kuropatoochka/bms_stand/bms_app/reports/report_1111_20250519_182336.pdf

ПРОТОКОЛ

Проверки соответствия системы контроля литий-ионной аккумуляторной батареи функциональным требованиям

№ ____ | « » _______ 2025 г.
1. Объект испытания: система контроля литий-ионной аккумуляторной батареи BMS_ABC123 зав. № 1111.
2. Цель испытания:
Проверка соответствия системы контроля литий-ионной аккумуляторной батареи функциональным требованиям
по защите аккумуляторной батареи от перезаряда, переразряда, токов короткого замыкания.
- отключение тока заряда при напряжении 4,25±0,05 В на любом из аккумуляторов;
- отключение тока разряда при напряжении 2,85±0,05 В на любом из аккумуляторов;
- отключение при превышении тока разряда свыше 50 А.
3. Дата проведения испытания: «19» May 2025 г.
4. Место проведения испытания: ООО "Ту-ту".

№ каналаРабота принапряженииниже 4,2 В Отключение принапряжениивыше 4,3 В Работа принапряжениивыше 2,9 В Отключение принапряженииниже 2,8 В

1 | + | - | - | -
2 | - | - | - | -
3 | - | - | - | +
4 | + | + | + | +
5 | - | + | - | +
6 | - | - | + | +
7 | - | - | + | +
8 | - | - | + | -

Отключение разряда по превышению тока 50 А: Результат по КЗ: СКУ ЛИАБ не сработало по короткому замыканию
