kuropatoochka/bms_stand/bms_app/reports/report_BMS_ABS111_20250519_181500.pdf

ПРОТОКОЛ

Проверки соответствия системы контроля литий-ионной аккумуляторной батареи функциональным требованиям

№ ____ | « » _______ 2025 г.
