kuropatoochka/bms_stand/bms_altium/Project Outputs for BMS_Test_Stand/BOM/Copy of Bill of Materials-Stand.xlsx

Comment | Description | Designator | Footprint | LibRef | Quantity
 | Чип-конденсатор | C1, C2, C3, C4, C5, C6, C7 | С0805 | Chip Capasitor | 7
C-Type | Чип конденсатор (3/C) тант. | C8, C9, C10 | C_tant 3(С-type) | К53-67 (3/C) | 3
 | Чип-конденсатор | C11, C12, C13, C14, C15, C16, C17, C18, C19, C20, C21, C22, C23, C24, C25, C26, C27, C44, C45, C46, C47, C48, C49, C50, C51, C52, C53, C54, C55, C56, C57, C58, C59, C60, C61, C62, C63, C64, C65, C66, C67 | C0603 | Chip Capasitor | 41
0.1μF | Чип-конденсатор | C28, C30, C32, C34, C36, C38, C40, C42 | C0603 | Chip Capasitor | 8
1nF | Чип-конденсатор | C29, C31, C33, C35, C37, C39, C41, C43 | C0603 | Chip Capasitor | 8
К1986ВЕ92Q | 32бит микроконтроллер CortexM3 | D1 | LQFP64 | К1986ВЕ92QI(C)_2parts(LQFP64) | 1
PRAB30S | Реле твердотельное с оптической развязкой | DA1, DA2, DA3, DA4 | SOP-4 | PRAB30S | 4
78D12L | Стабилизатор напряжения, 12В | DA5 | DPAK | 78D12L | 1
LD1117DT 3.3V | LDO-регулятор напряжения, 3.3В | DA6 | DPAK | LD1117DT33TR | 1
REF193 3V | Источник опорного напряжения, 3В | DA7 | SOP-8 (SOIC) | REF193 | 1
TS321ILT | 1х Операционный усилитель | DA8, DA9, DA10, DA11, DA12, DA13, DA14, DA15 | SOT-23-5 | TS321ILT | 8
CH340N | Преобразователь интерфейса USB в UART | DD1 | SOP-8 (SOIC) | CH340N | 1
FH-101C | Fuse holder 5x20mm | FU1 | FH-101C | FH-101C | 1
LED | Светодиод, d=5мм | HL1, HL2, HL3, HL4 | LED 5mm (L-7113IT) | LED | 4
LQH43MN331K | Чип-индуктивность 95мА, 330мкГн 10% | L1 | LQH43M (1812) | LQH43MN331K | 1
 | Чип-резистор | R1, R2, R5, R6, R10, R11, R19, R20, R28, R29, R30, R31, R32, R33, R34, R35, R36, R37, R38, R39, R40, R41, R42, R48, R49, R50, R51, R52, R53, R54, R55, R56, R57, R58, R59, R60, R61, R62, R63, R64, R70, R71, R72, R73, R74, R75, R76, R77, R78, R79, R80, R81, R82, R83, R84, R85, R86, R92, R93, R94, R95, R96, R97, R98, R99, R100, R101, R102, R103, R104, R105, R106, R107, R108, R114, R115, R116, R117, R118, R119, R120, R121, R122, R123, R124, R125, R126, R127, R128, R129, R130, R136, R137, R138, R139, R140, R141, R142, R143, R144, R145, R146, R147, R148, R149, R150, R151, R152, R158, R159, R160, R161, R162, R163, R164, R165, R166, R167, R168, R169, R170, R171, R172, R173, R174, R180, R181, R182, R183, R184, R185, R186, R187, R188, R189, R190, R191, R192, R193, R194, R195, R196, R202, R203 | R0603 | Chip Resistor | 144
 | Чип-резистор | R3, R4 | R1206 | Chip Resistor | 2
6,8К | Чип-резистор | R7 | R1206 | Chip Resistor | 1
100 | Чип-резистор | R8, R44, R66, R88, R110, R132, R154, R176, R198 | R0603 | Chip Resistor | 9
68 | Резистор | R9 | SQP 5W | Resistor | 1
 | Чип-резистор | R12, R13, R14, R15, R16, R17, R18, R21, R22, R23, R24, R25, R26, R27 | R0805 | Chip Resistor | 14
1k | Чип-резистор | R43, R45, R46, R47, R65, R67, R68, R69, R87, R89, R90, R91, R109, R111, R112, R113, R131, R133, R134, R135, R153, R155, R156, R157, R175, R177, R178, R179, R197, R199, R200, R201 | R0603 | Chip Resistor | 32
0650HIM-130G-G | Кнопка тактовая, h=5мм | SF1, SF2 | TC-0103 | 0650HIM-130G-G | 2
PRTR5V0U2X | Защитная диодная сборка от статического заряда | VD1 | SOT-143 | PRTR5V0U2X | 1
S1B | Диод выпрямительный, 100В | VD2, VD5, VD8, VD11, VD14, VD17, VD20, VD23 | DO-214AC | S1B | 8
TLV431B | Стабилитрон регулируемый, 6В | VD3, VD6, VD9, VD12, VD15, VD18, VD21, VD24 | SOT-23 | TLV431B | 8
SMCJ5.0A | Защитный диод, 5В | VD4, VD7, VD10, VD13, VD16, VD19, VD22, VD25 | DO-214AB | SMCJ5.0A | 8
BC846B | Транзистор биполярный NPN, 65В | VT1, VT3, VT4, VT5, VT15, VT16, VT17, VT27, VT28, VT29, VT39, VT40, VT41, VT51, VT52, VT53, VT63, VT64, VT65, VT75, VT76, VT77, VT87, VT88, VT89 | SOT-23 | BC846B | 25
IRFP4710PBF | Транзистор MOSFET N-канал, 100В | VT2 | TO-247AC | IRFP4710PBF | 1
BC856 | Транзистор биполярный PNP, 65В | VT6, VT7, VT8, VT13, VT18, VT19, VT20, VT25, VT30, VT31, VT32, VT37, VT42, VT43, VT44, VT49, VT54, VT55, VT56, VT61, VT66, VT67, VT68, VT73, VT78, VT79, VT80, VT85, VT90, VT91, VT92, VT97 | SOT-23 | BC856 | 32
AO3404A | Транзистор MOSFET N-канал, 30В | VT9, VT10, VT11, VT21, VT22, VT23, VT33, VT34, VT35, VT45, VT46, VT47, VT57, VT58, VT59, VT69, VT70, VT71, VT81, VT82, VT83, VT93, VT94, VT95 | SOT-23 | AO3404A | 24
2N7002 | Транзистор MOSFET N-канал, 60В | VT12, VT24, VT36, VT48, VT60, VT72, VT84, VT96 | SOT-23 | 2N7002 | 8
KT814Г | Транзистор биполярный PNP, 100В | VT14, VT26, VT38, VT50, VT62, VT74, VT86, VT98 | TO-126 | KT814Г | 8
Mini-Fit | Mini-Fit 4,2mm A Male 6 pin | XP1 | MF2x3MA | MF2x3MA | 1
MicroFit | MicroFit 3mm RA Male 4 pin | XP2 | MF3-04MA | 43045-0412 | 1
AC-023 | Разъём питания AC, одинарный | XP3 | IEC-C14 | AC-023 | 1
5EHDRC-03P | Клеммник 3 конт. "вилка" шаг 5.00 мм | XP4 | 5EHDRC-03P | 5EHDRC-03P | 1
5EHDRC-10P | Клеммник 10 конт. "вилка" шаг 5.00 мм | XP5 | 5EHDRC-10P | 5EHDRC-10P | 1
"JTAG" | J-TAG Connector | XP6 | IDC_20 | JTAG_20 L | 1
USB Type B | Гнездо USB тип B | XS1 | USB Type B | USB Type B | 1
QuartzRes | Кварцевый резонатор, 8 МГц | ZQ1 | HC-49SM | QuartzRes | 1
