kuropatoochka/bms_stand/bms_altium/Project Outputs for BMS_Test_Stand/Для СБ Измерительного модуля стенда/Top.DXF

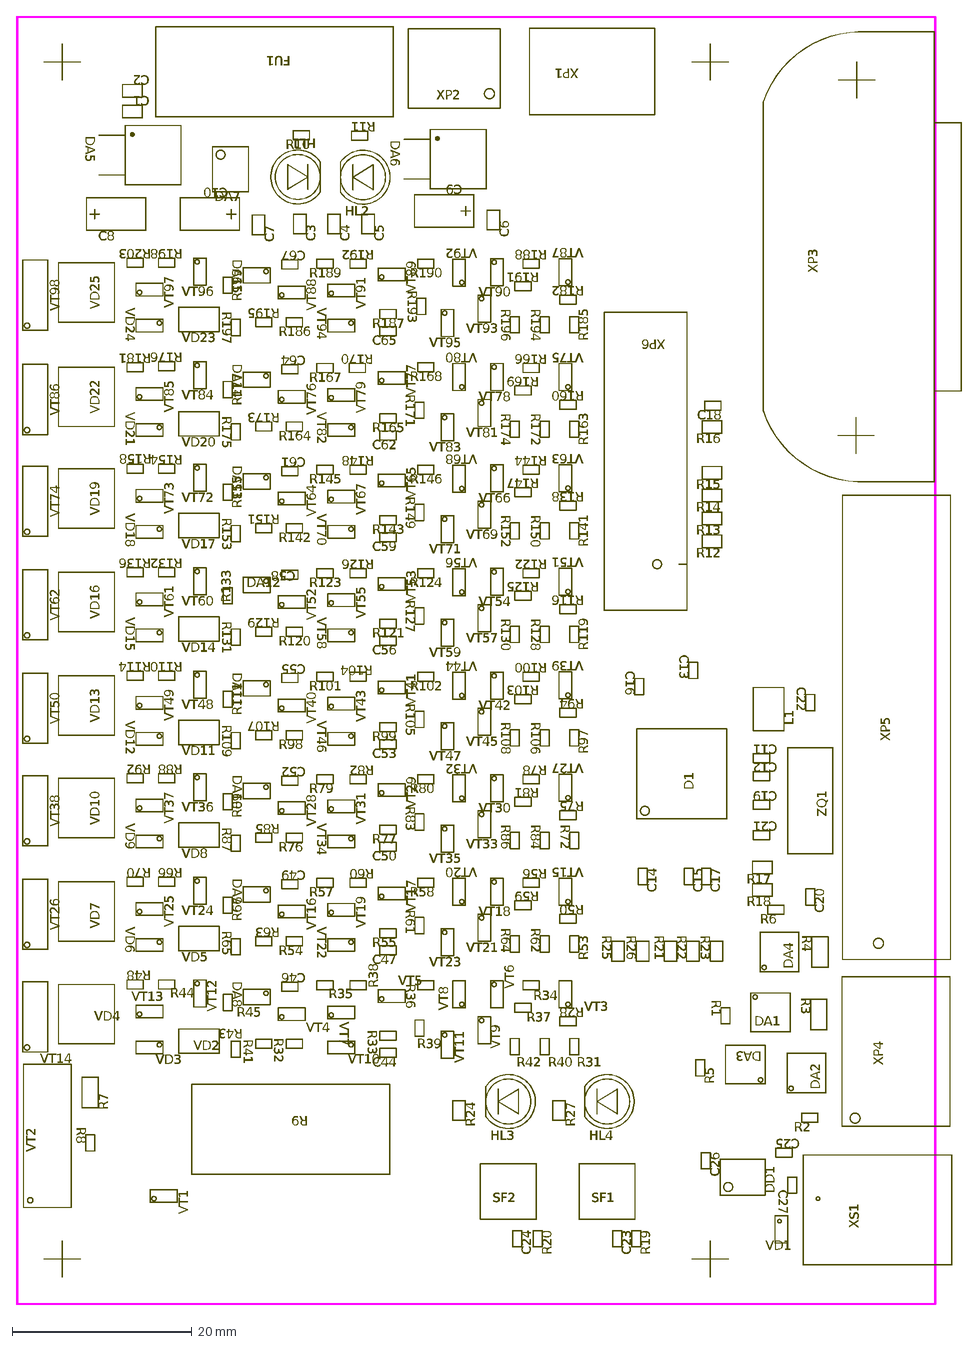
[picture p1: CAD file, 2025-08-11]
bms_altium/Project Outputs for BMS_Test_Stand/Для СБ Измерительного модуля стенда/Top.DXF
XP4
XP5
XP1
XP2
C3
C2
C67
C65
C64
C62
C61
C59
C58
C56
C55
C53
C52
C50
C49
C47
C46
C44
DA15
DA14
DA13
DA12
DA11
DA10
DA9
DA8
R50
C20
ZQ1
XS1
XP6
XP3
VT98
VT97
VT96
VT95
VT94
VT93
VT92
VT91
VT90
VT89
VT88
VT87
VT86
VT85
VT84
VT83
VT82
VT81
VT80
VT79
VT78
VT77
VT76
VT75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
