kuropatoochka/bms_stand/bms_solid/top.SLDPRT

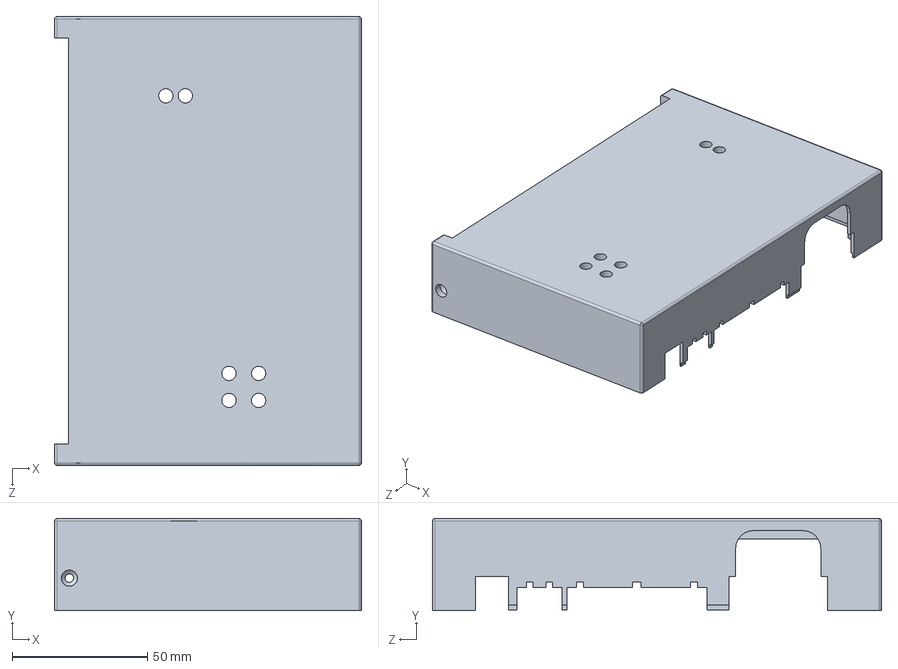
[picture p2: CAD file, 2025-08-11]
bms_solid/top.SLDPRT
113.6 x 34.1 x 166.2 mm
