kuropatoochka/bms_stand/bms_altium/Project Outputs for BMS_Test_Stand/Для СБ Измерительного модуля стенда/Bottom.DXF

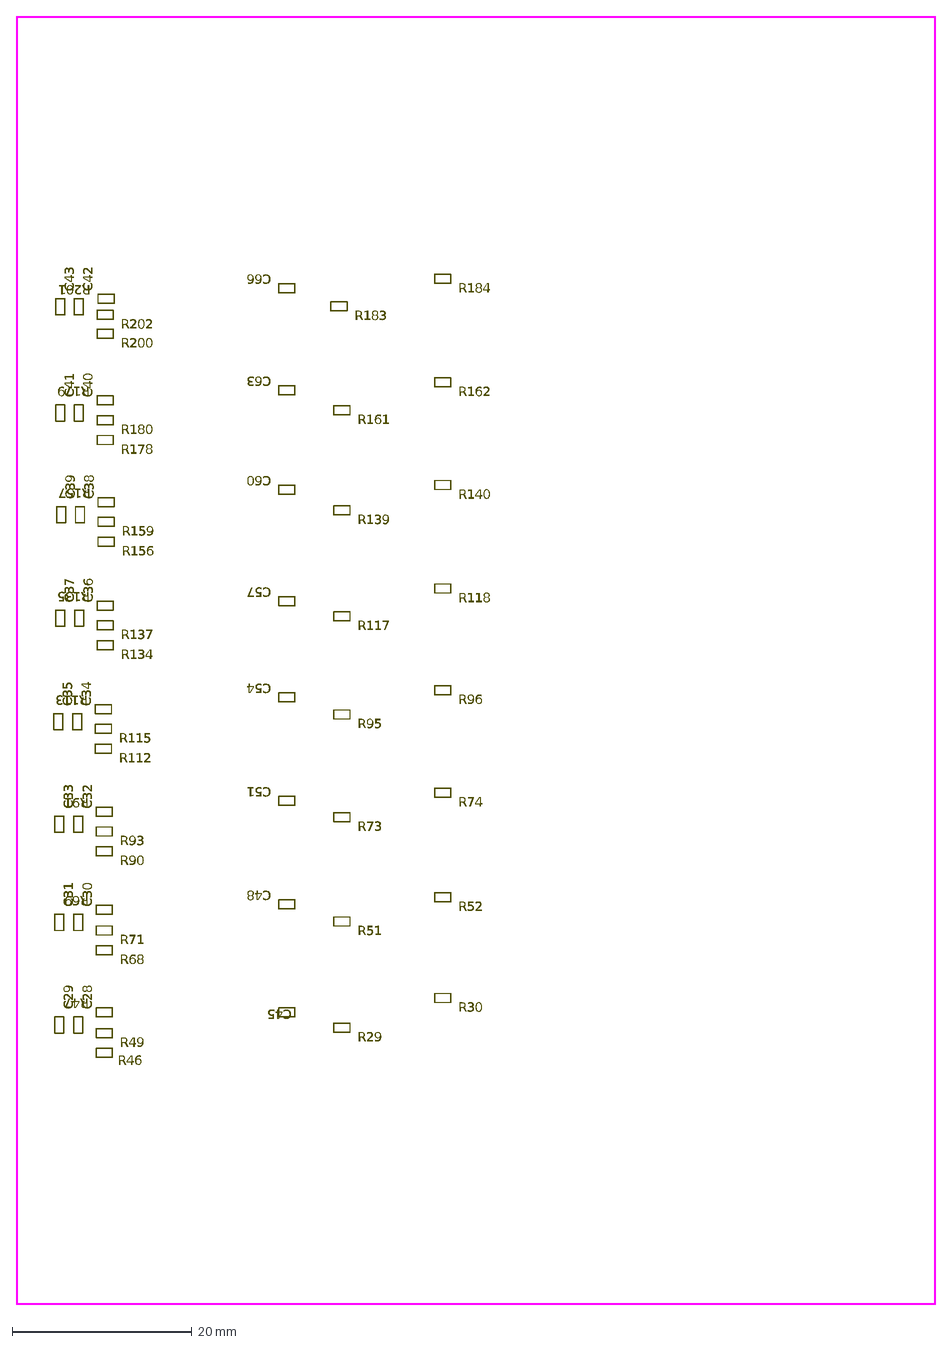
[picture p3: CAD file, 2025-08-11]
bms_altium/Project Outputs for BMS_Test_Stand/Для СБ Измерительного модуля стенда/Bottom.DXF
C66
C63
C60
C57
C54
C51
C48
C45
R200
R68
R202
R201
R184
R183
R180
R179
R178
R162
R161
R159
R157
R156
R140
R139
R137
R135
R134
R118
R117
R115
R113
R112
R96
R95
R93
R91
R90
R74
R73
R71
R69
R52
R51
R49
R47
R46
R30
R29
C43
C42
C41
C40
C39
C38
C37
C36
C35
C34
C33
C32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
