kuropatoochka/bms_stand/bms_solid/колпачек.SLDPRT

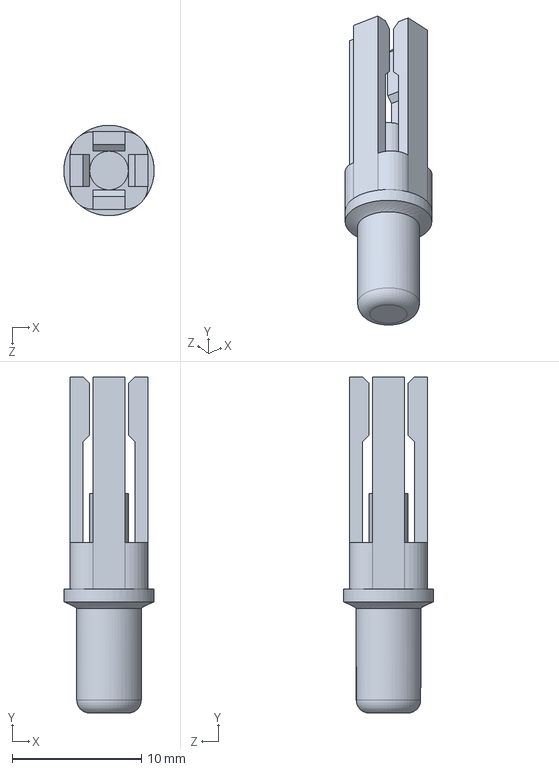
[picture p4: CAD file, 2025-08-11]
bms_solid/колпачек.SLDPRT
7.00 x 26.0 x 7.00 mm
