kuropatoochka/bms_stand/bms_solid/Плоская шайба DIN 125 M3.SLDPRT

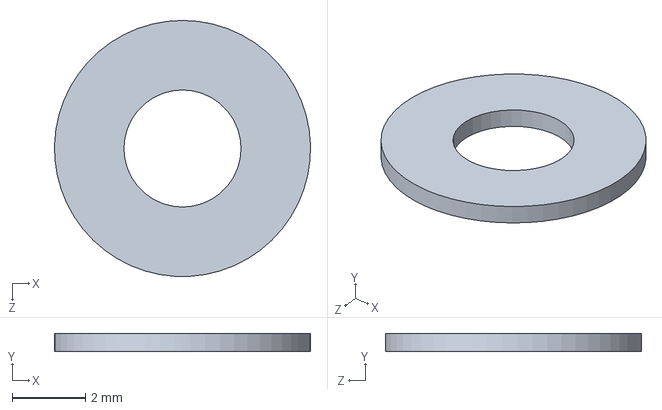
[picture p5: CAD file, 2025-08-11]
bms_solid/Плоская шайба DIN 125 M3.SLDPRT
7.00 x 0.5 x 7.00 mm
