kuropatoochka/bms_stand/bms_solid/A06-17.0.SLDPRT

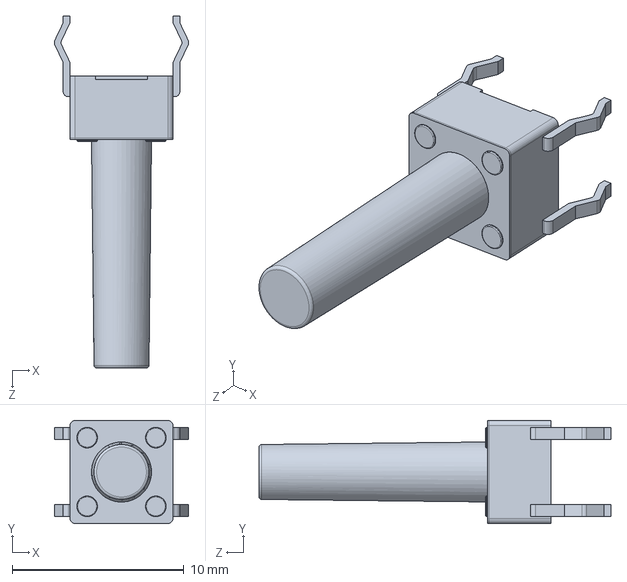
[picture p6: CAD file, 2025-08-11]
bms_solid/A06-17.0.SLDPRT
7.83 x 6.00 x 20.5 mm
