kuropatoochka/bms_stand/bms_solid/body.SLDPRT

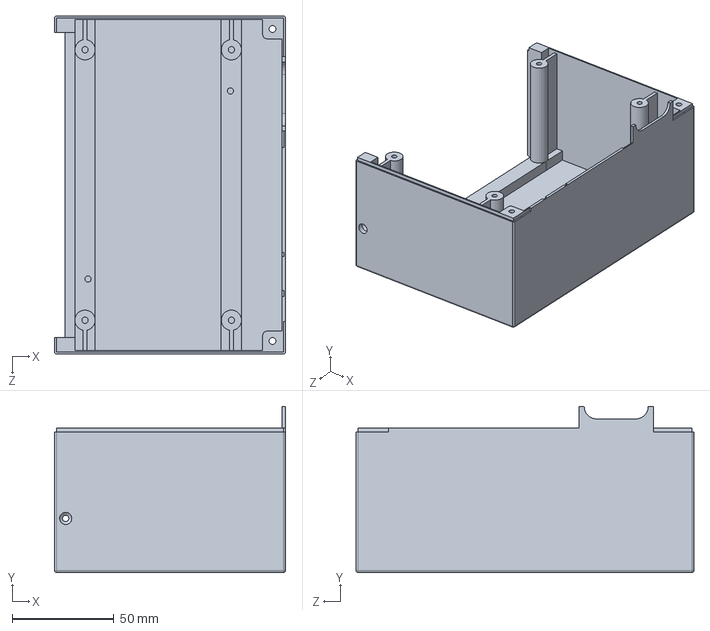
[picture p7: CAD file, 2025-08-11]
bms_solid/body.SLDPRT
113.6 x 81.6 x 166.2 mm
