kuropatoochka/bms_stand/bms_solid/LRS-35,50 Mean Well/Bot LRS-35,50.sldprt

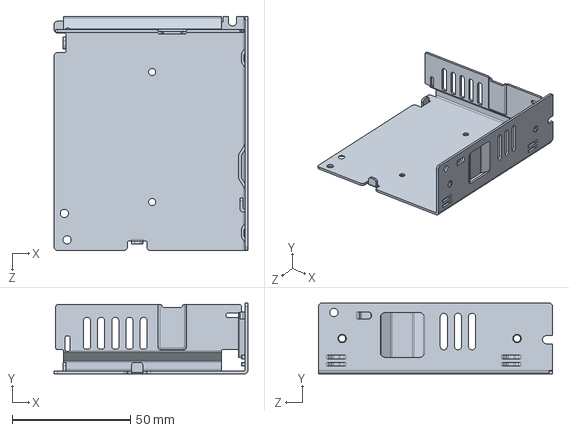
[picture p8: CAD file, 2025-08-11]
bms_solid/LRS-35,50 Mean Well/Bot LRS-35,50.sldprt
82.0 x 30.0 x 99.0 mm
