kuropatoochka/bms_stand/bms_solid/Пружинная шайба DIN 127 М3.SLDPRT

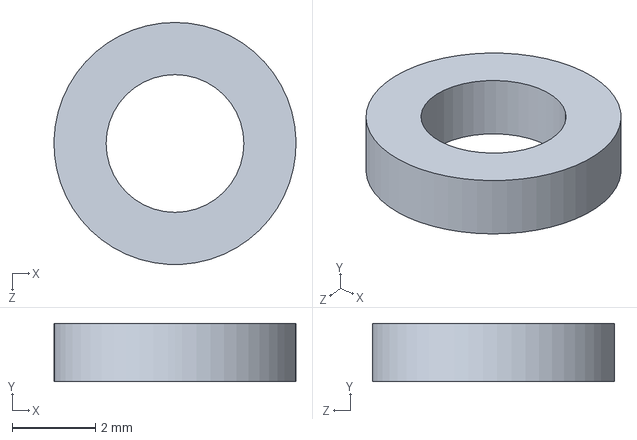
[picture p9: CAD file, 2025-08-11]
bms_solid/Пружинная шайба DIN 127 М3.SLDPRT
5.80 x 1.40 x 5.80 mm
