kuropatoochka/bms_stand/bms_solid/radiator_АВМ-077-100.SLDPRT

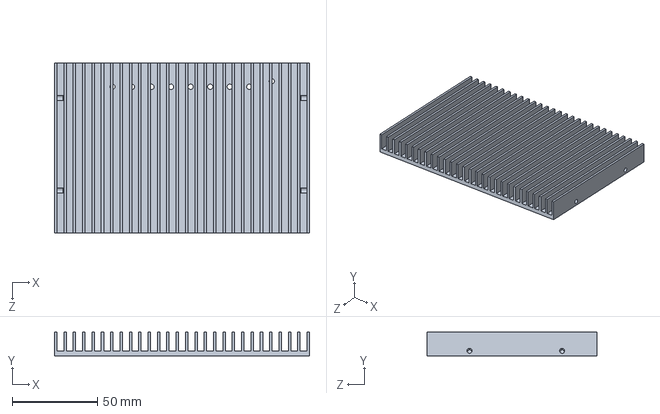
[picture p10: CAD file, 2025-08-11]
bms_solid/radiator_АВМ-077-100.SLDPRT
150.0 x 14.0 x 100.0 mm
