kuropatoochka/bms_stand/bms_solid/LRS-35,50 Mean Well/LRS-35,50 Mean Well.SLDASM

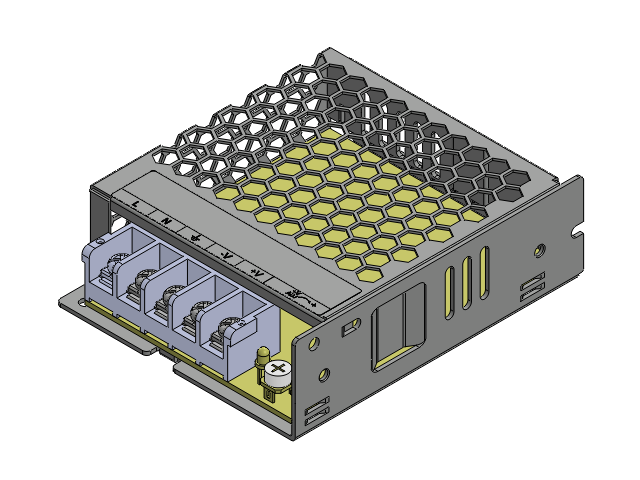
[picture p11: CAD file, 2025-08-11]
bms_solid/LRS-35,50 Mean Well/LRS-35,50 Mean Well.SLDASM
Bot LRS-35,50
Cap LRS-35,50
PCB LRS-35,50
Terminal Block LRS-35,50
