kuropatoochka/bms_stand/bms_solid/stand.SLDASM

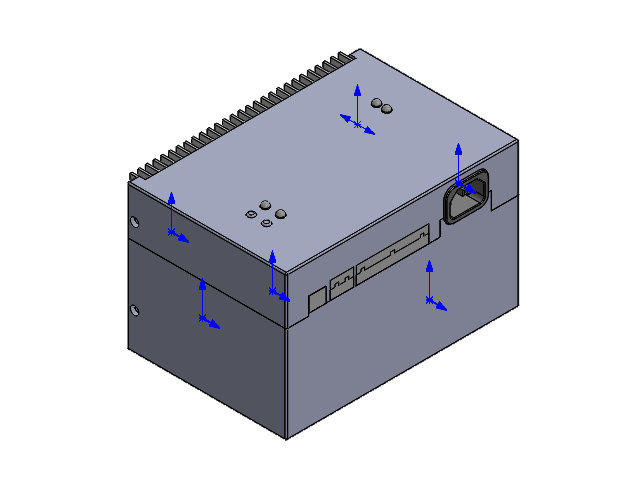
[picture p12: CAD file, 2025-08-11]
bms_solid/stand.SLDASM
Bot LRS-35,50
Cap LRS-35,50
PCB LRS-35,50
Terminal Block LRS-35,50
radiator_АВМ-077-100
top
колпачек x 2
slot head_am x 8
Измерительный модуль стенда
Плоская шайба DIN 125 M3 x 6
Пружинная шайба DIN 127 М3 x 6
flat head screw_am x 4
