kuropatoochka/bms_stand/(list of files, cad)

Other CAD files:
bms_altium/Stand.DXF
bms_solid/LRS-35,50 Mean Well/PCB LRS-35,50.sldprt
bms_solid/LRS-35,50 Mean Well/Terminal Block LRS-35,50.sldprt
bms_solid/LRS-35,50 Mean Well/Cap LRS-35,50.sldprt
bms_solid/LRS-35,50 Mean Well/СНАБ.468222.001 Э4 Схема электрическая подключения.SLDDRW
bms_solid/LRS-35,50 Mean Well/СНАБ.468222.001 Э4 Схема электрическая соединений.SLDDRW
bms_solid/СНАБ.468222.001 ПЭЗ Перечень элементов.SLDDRW
bms_solid/СНАБ.468222.001 СБ Измерительный модуль стенда.SLDDRW
bms_solid/СНАБ.468222.001 Спецификация измерительный модуль стенда.SLDDRW
bms_solid/СНАБ.468222.001 Э4 Схема электрическая соединений.SLDDRW
bms_solid/СНАБ.715691.001 Колпачок.SLDDRW
bms_solid/СНАБ.731141.001 Чертеж корпус основание.SLDDRW
bms_solid/СНАБ.735214.001 Чертеж корпус крышка.SLDDRW
bms_solid/СНАБ.752694.001 Радиатор.SLDDRW
