kuropatoochka/bms_stand/bms_docs/СНАБ.468222.001 ЭЗ Принципиальная схема.pdf

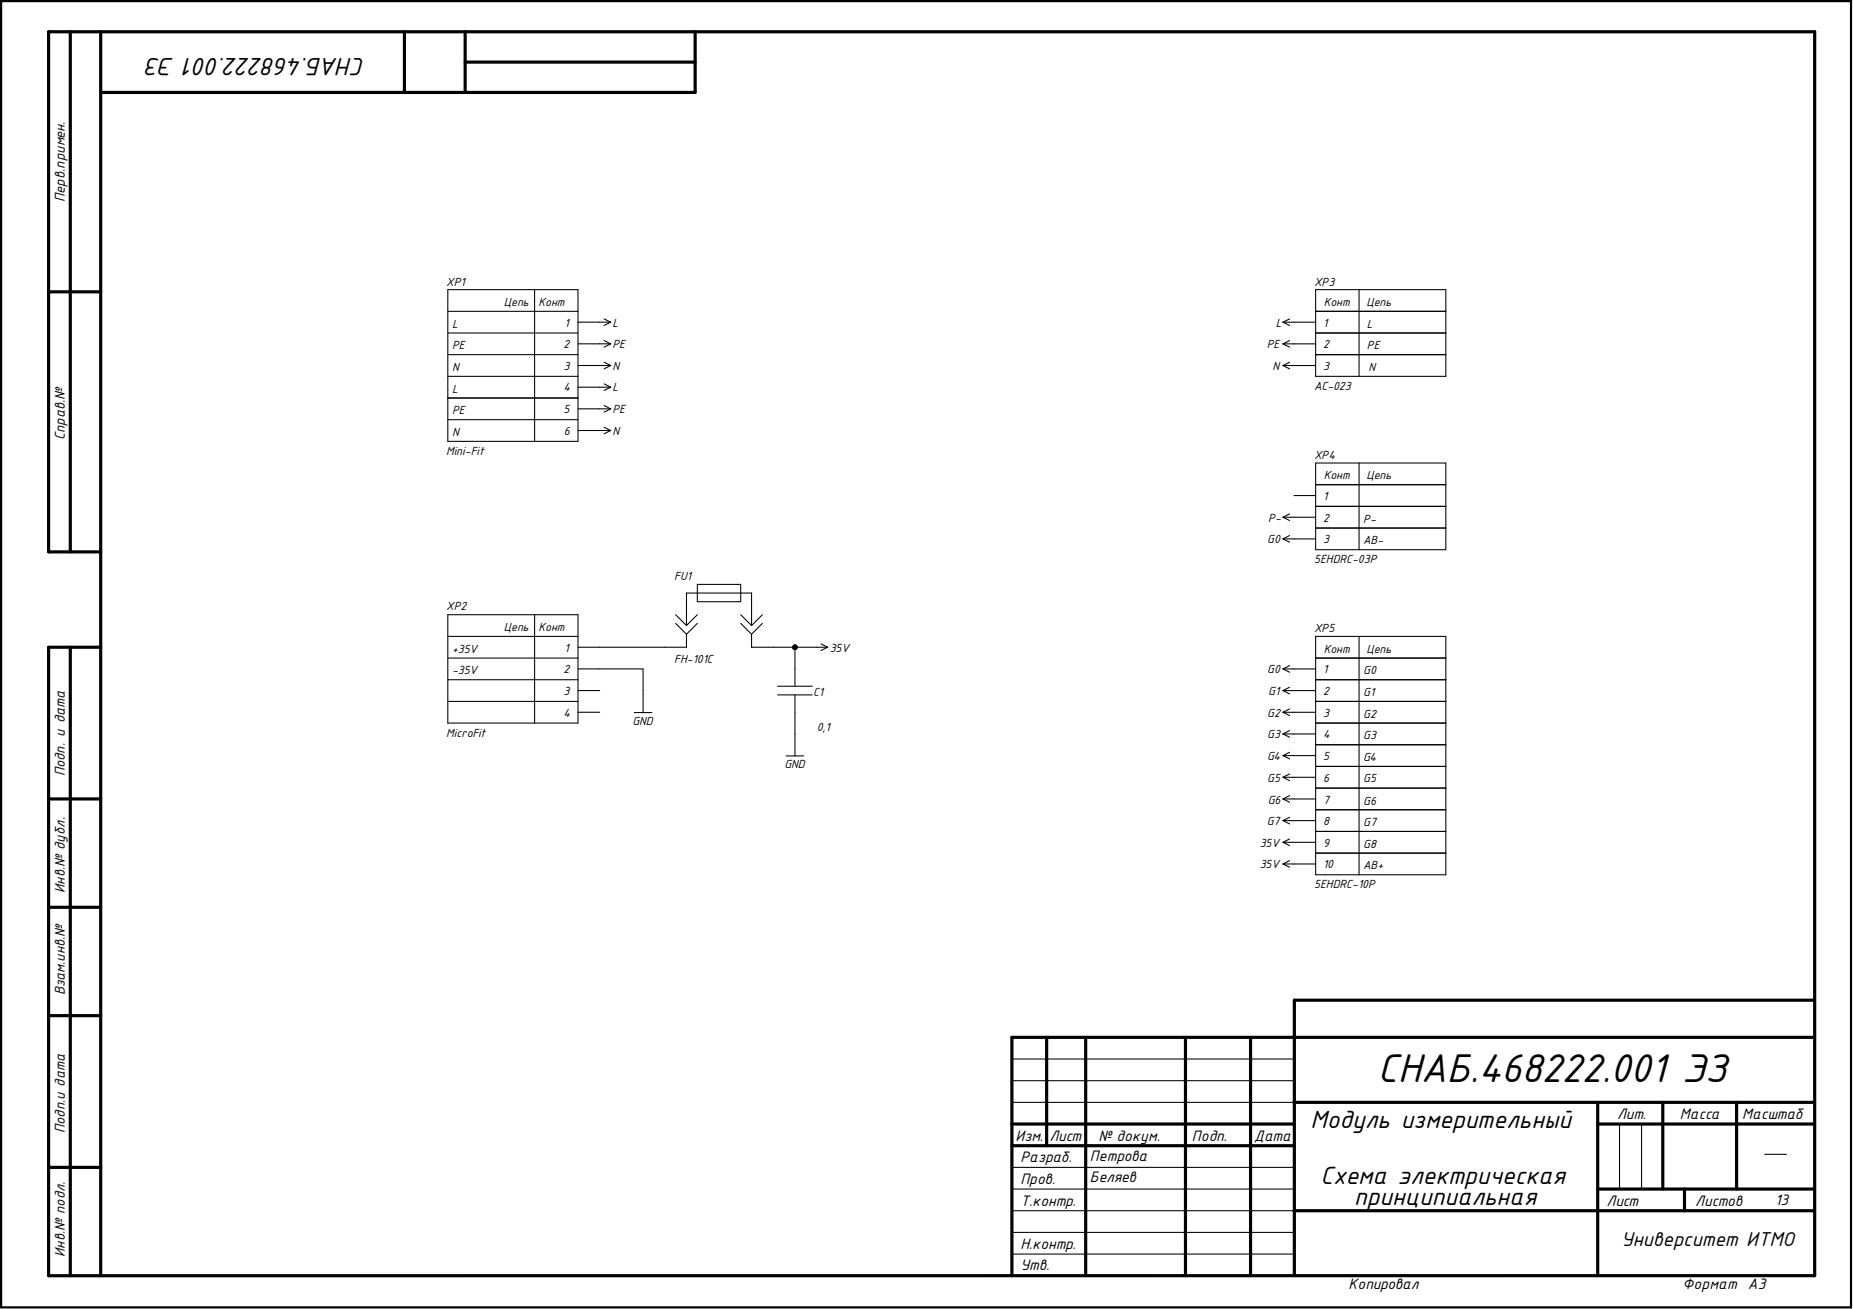
[picture p13: page 1]

PELN | XP4

Инв.№ подл. Подп.и дата Взам.инв.№ Инв.№ дубл. Подп. и дата

СНАБ.468222.001 ЭЗ

И з м . | Л и ст | № д о к у м . | П о дп . | Д а т а | | | стЛит

Модуль измерительный Копировал Схема электрическая принципиальная | . | М а с с а | М а с ш т а б

Р а зр а б. | | П е тр о в а
. Пр о в | | Б е л я е в

Н. н тр
Ут в .

Университет ИТМО

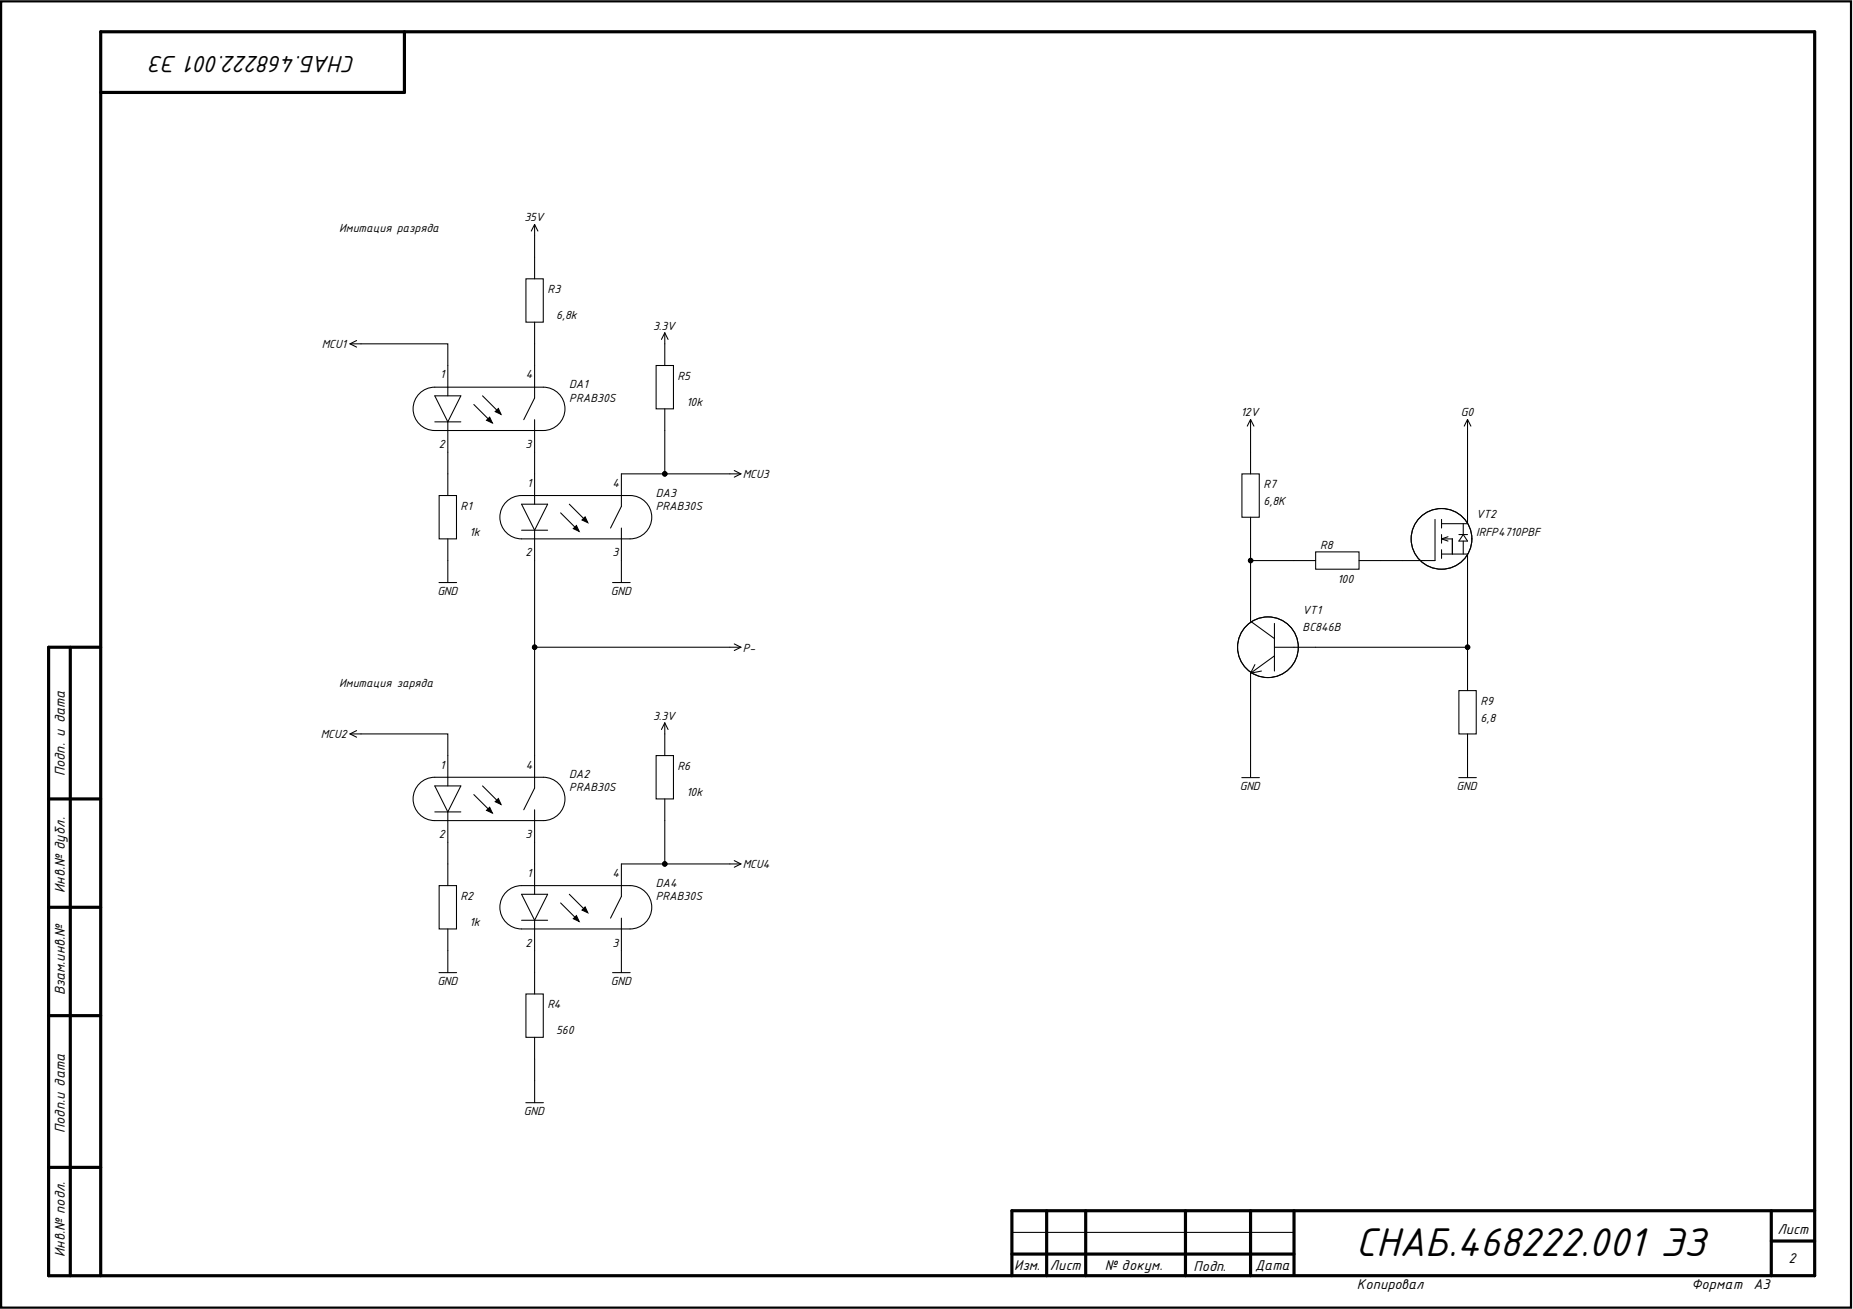
[picture p14: page 2]

Инв.№ подл. Подп.и дата Взам.инв.№ Инв.№ дубл.

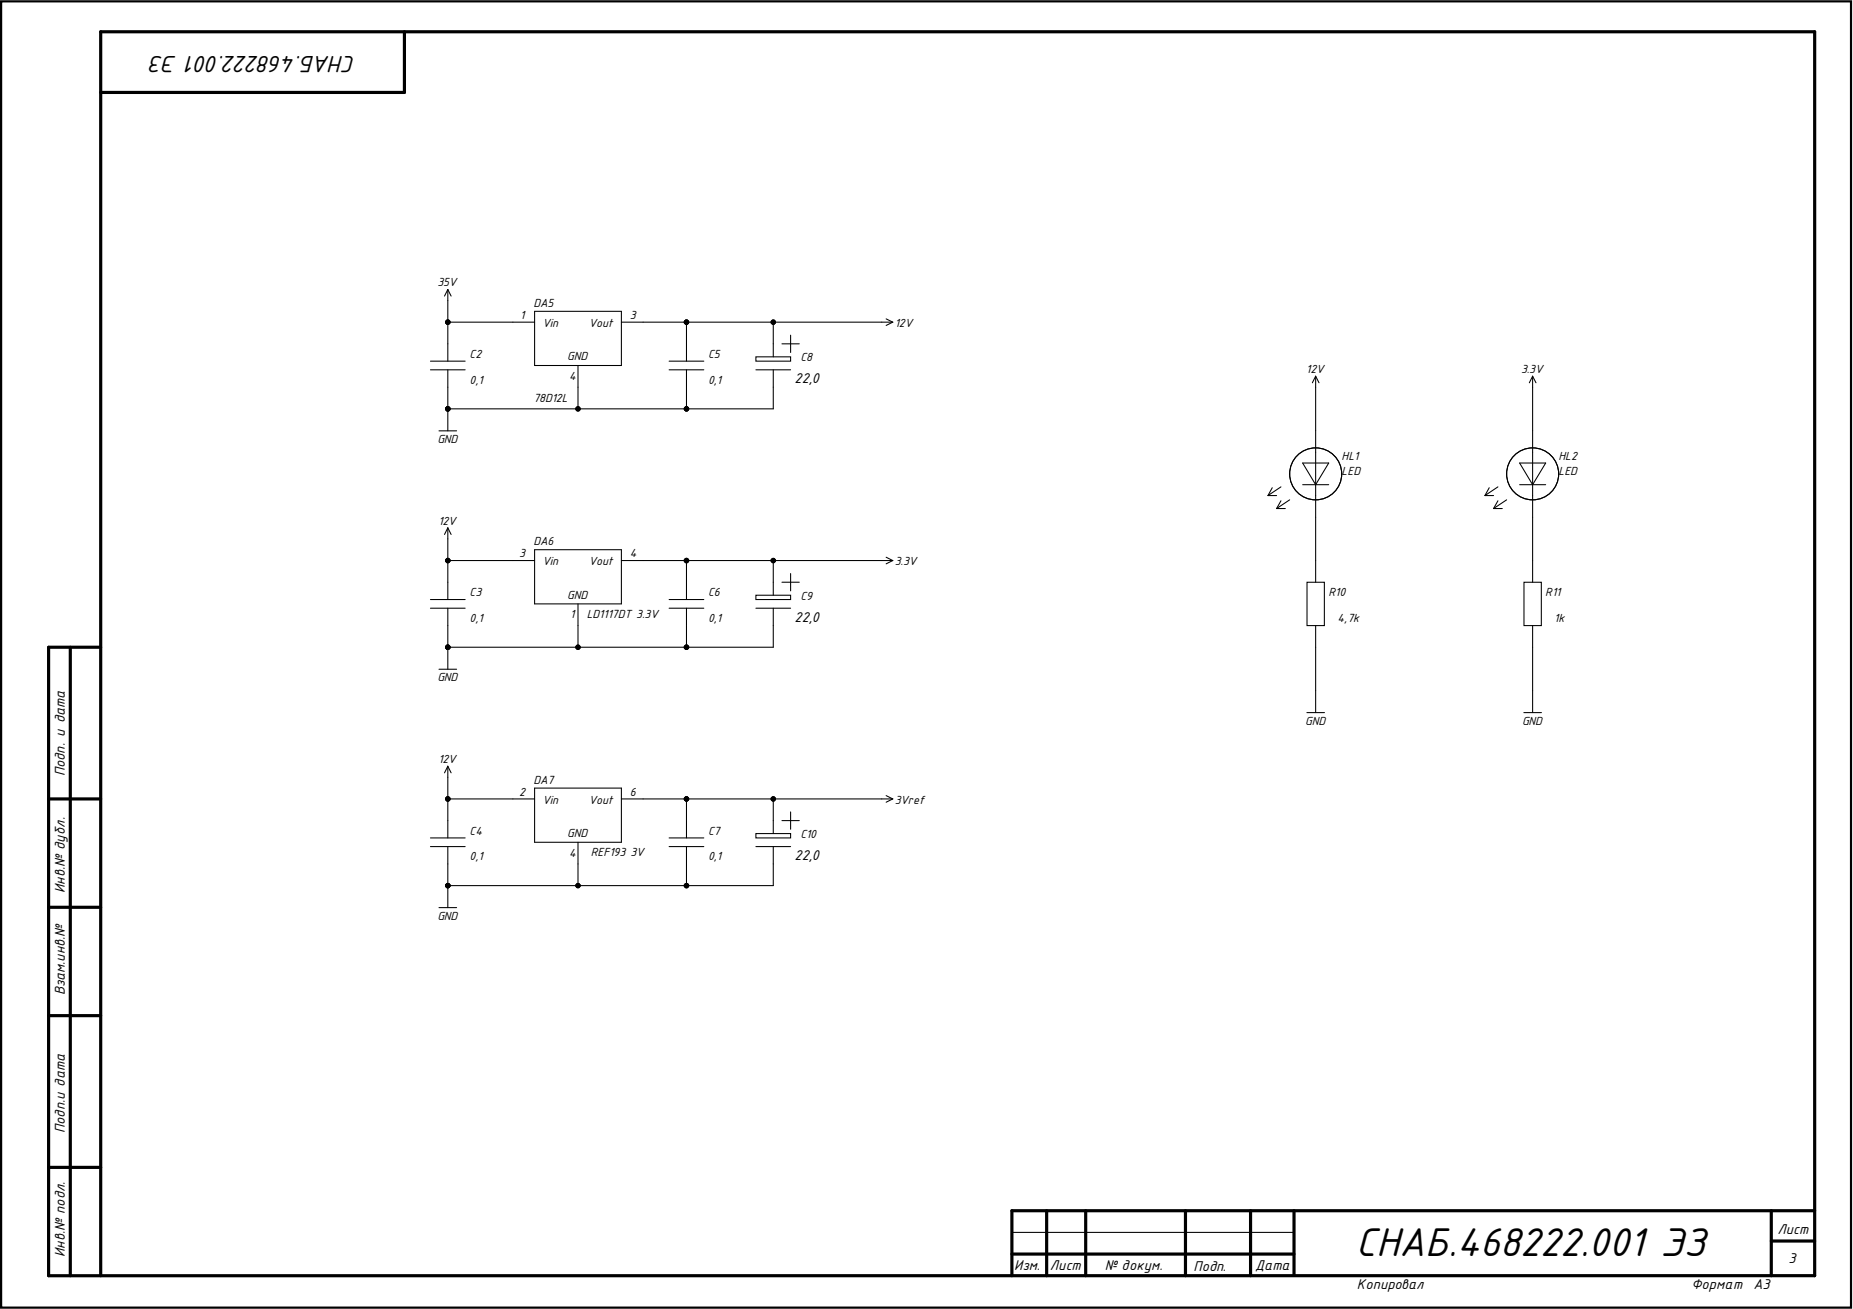
[picture p15: page 3]

Инв.№ подл. Подп.и дата Взам.инв.№ Инв.№ дубл.

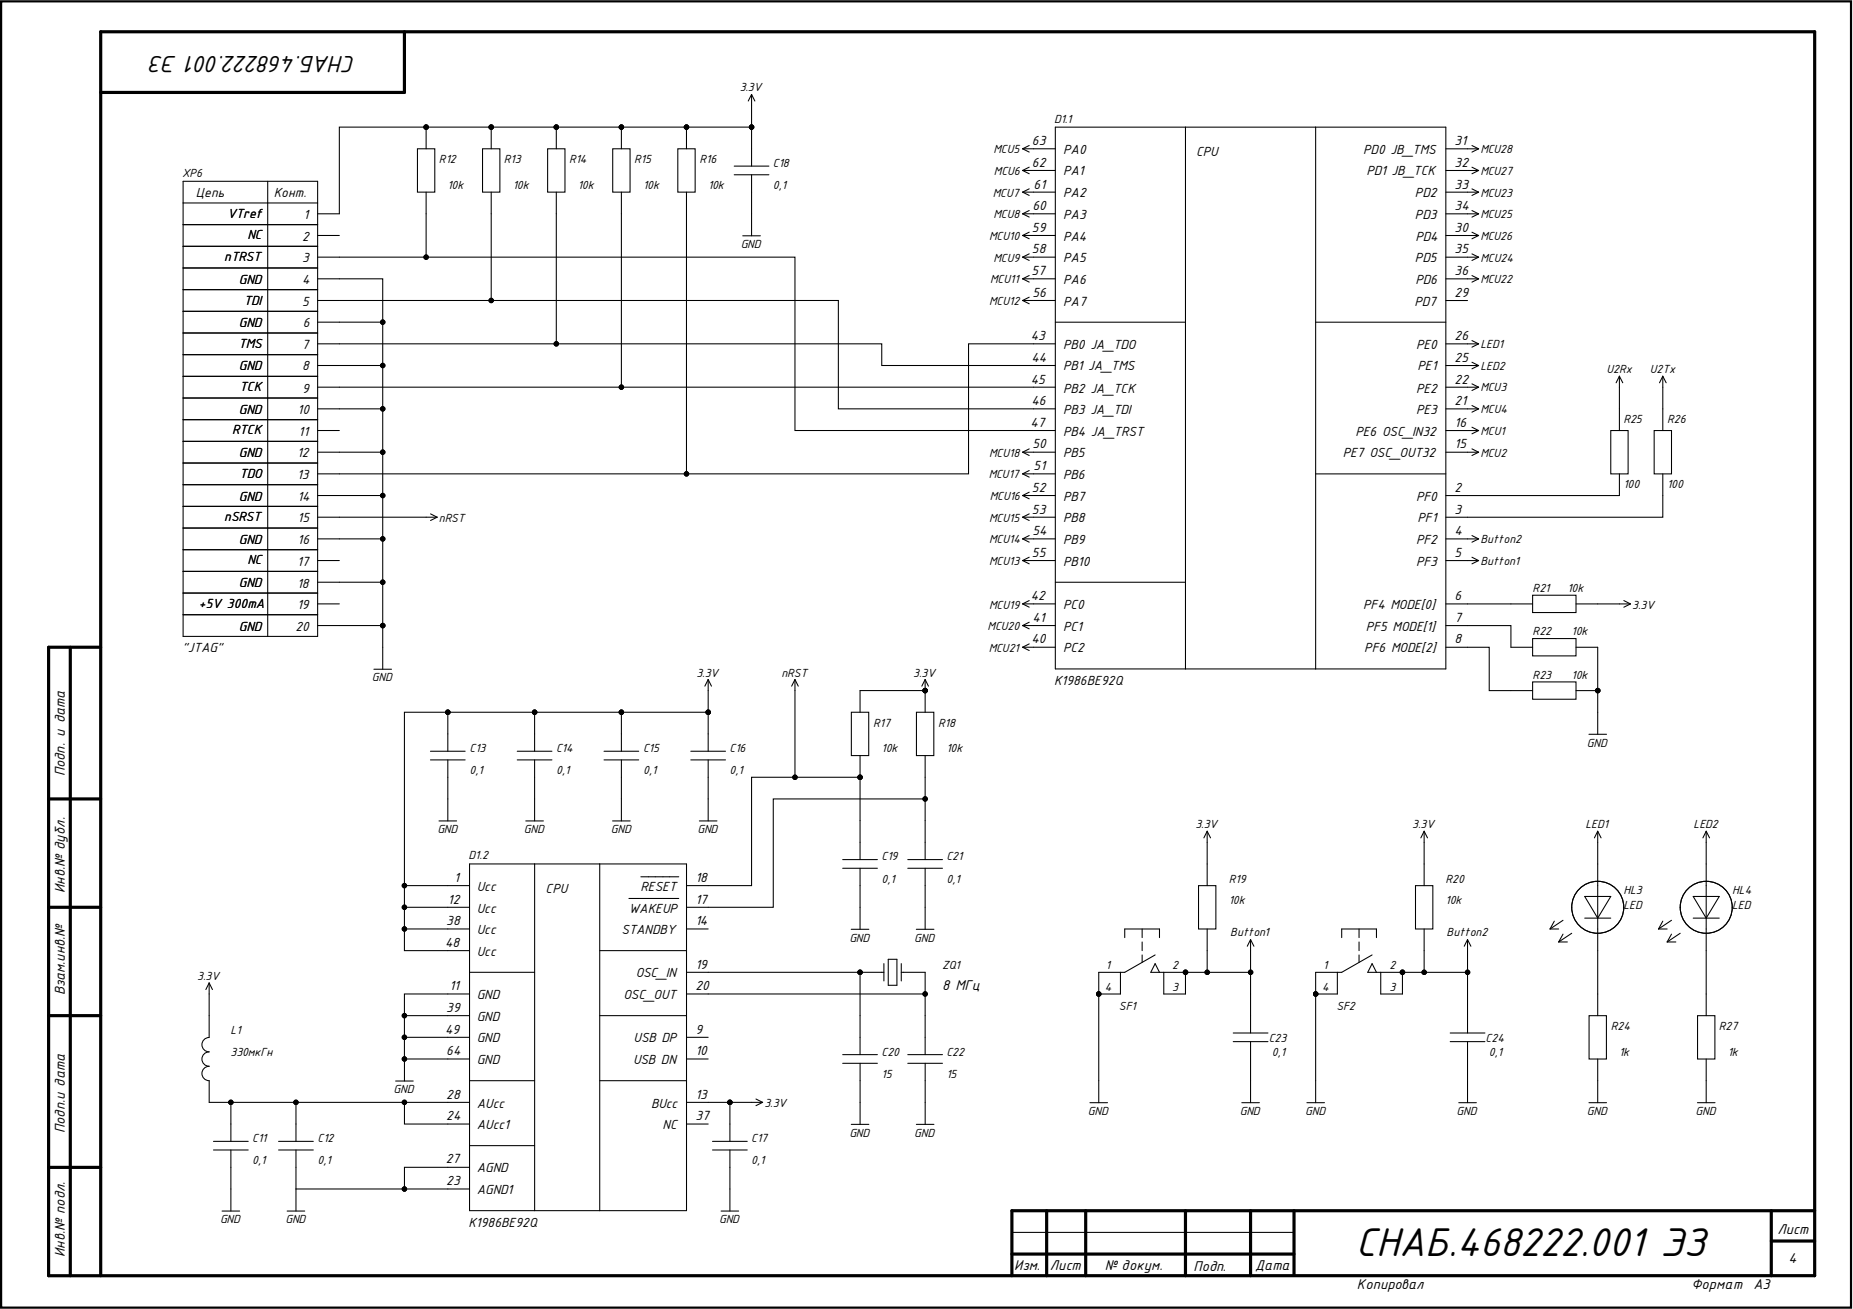
[picture p16: page 4]

Цепь | Конт.
VTref | 1
NC | 2
nTRST | 3

GND | MCU9 | PA4 59 PA5 58

MCU11 MCU12 | PA6 57 PA7 56

GND | 4
TDI | 5
GND | 6
TMS | 7
GND | 8
TCK | 9
GND | 10
RTCK | 11

PB1 JA_TMS 44

PB3 JA_TDI 46
PB4 JA_TRST 47

GND | 12
TDO | 13
GND | 14
nSRST | 15
GND | 16
NC | 17
GND | 18

MCU18 | PB5 50 PB6 51

GND | 20

GND 39 | 9
GND 49 | USB DP

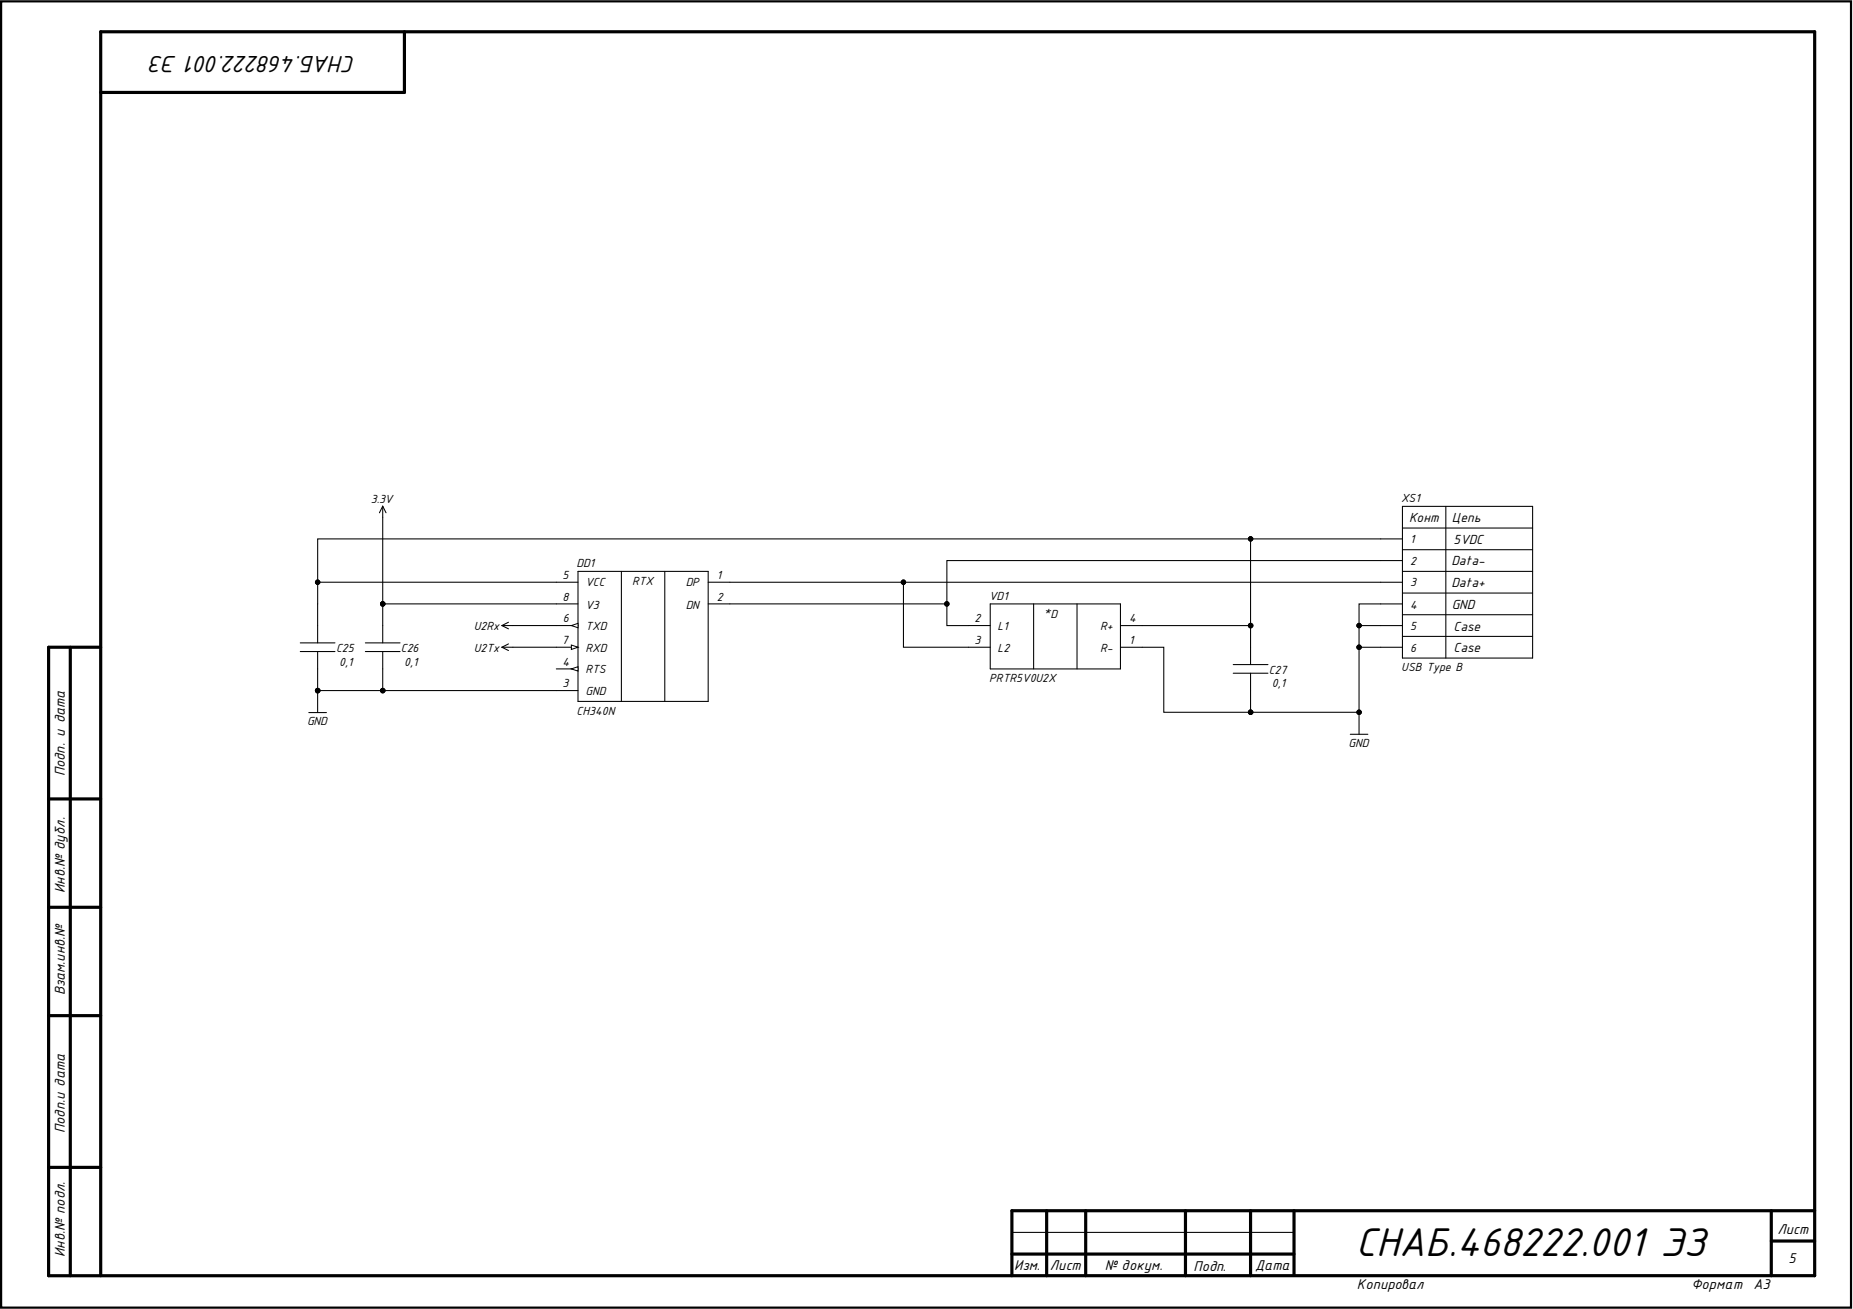
[picture p17: page 5]

5VD C
D ata -

U2Tx | TXD RXD RTS GND | | | | 2 | | * D | 4

C a s e

Инв.№ подл. Подп.и дата Взам.инв.№ Инв.№ дубл.

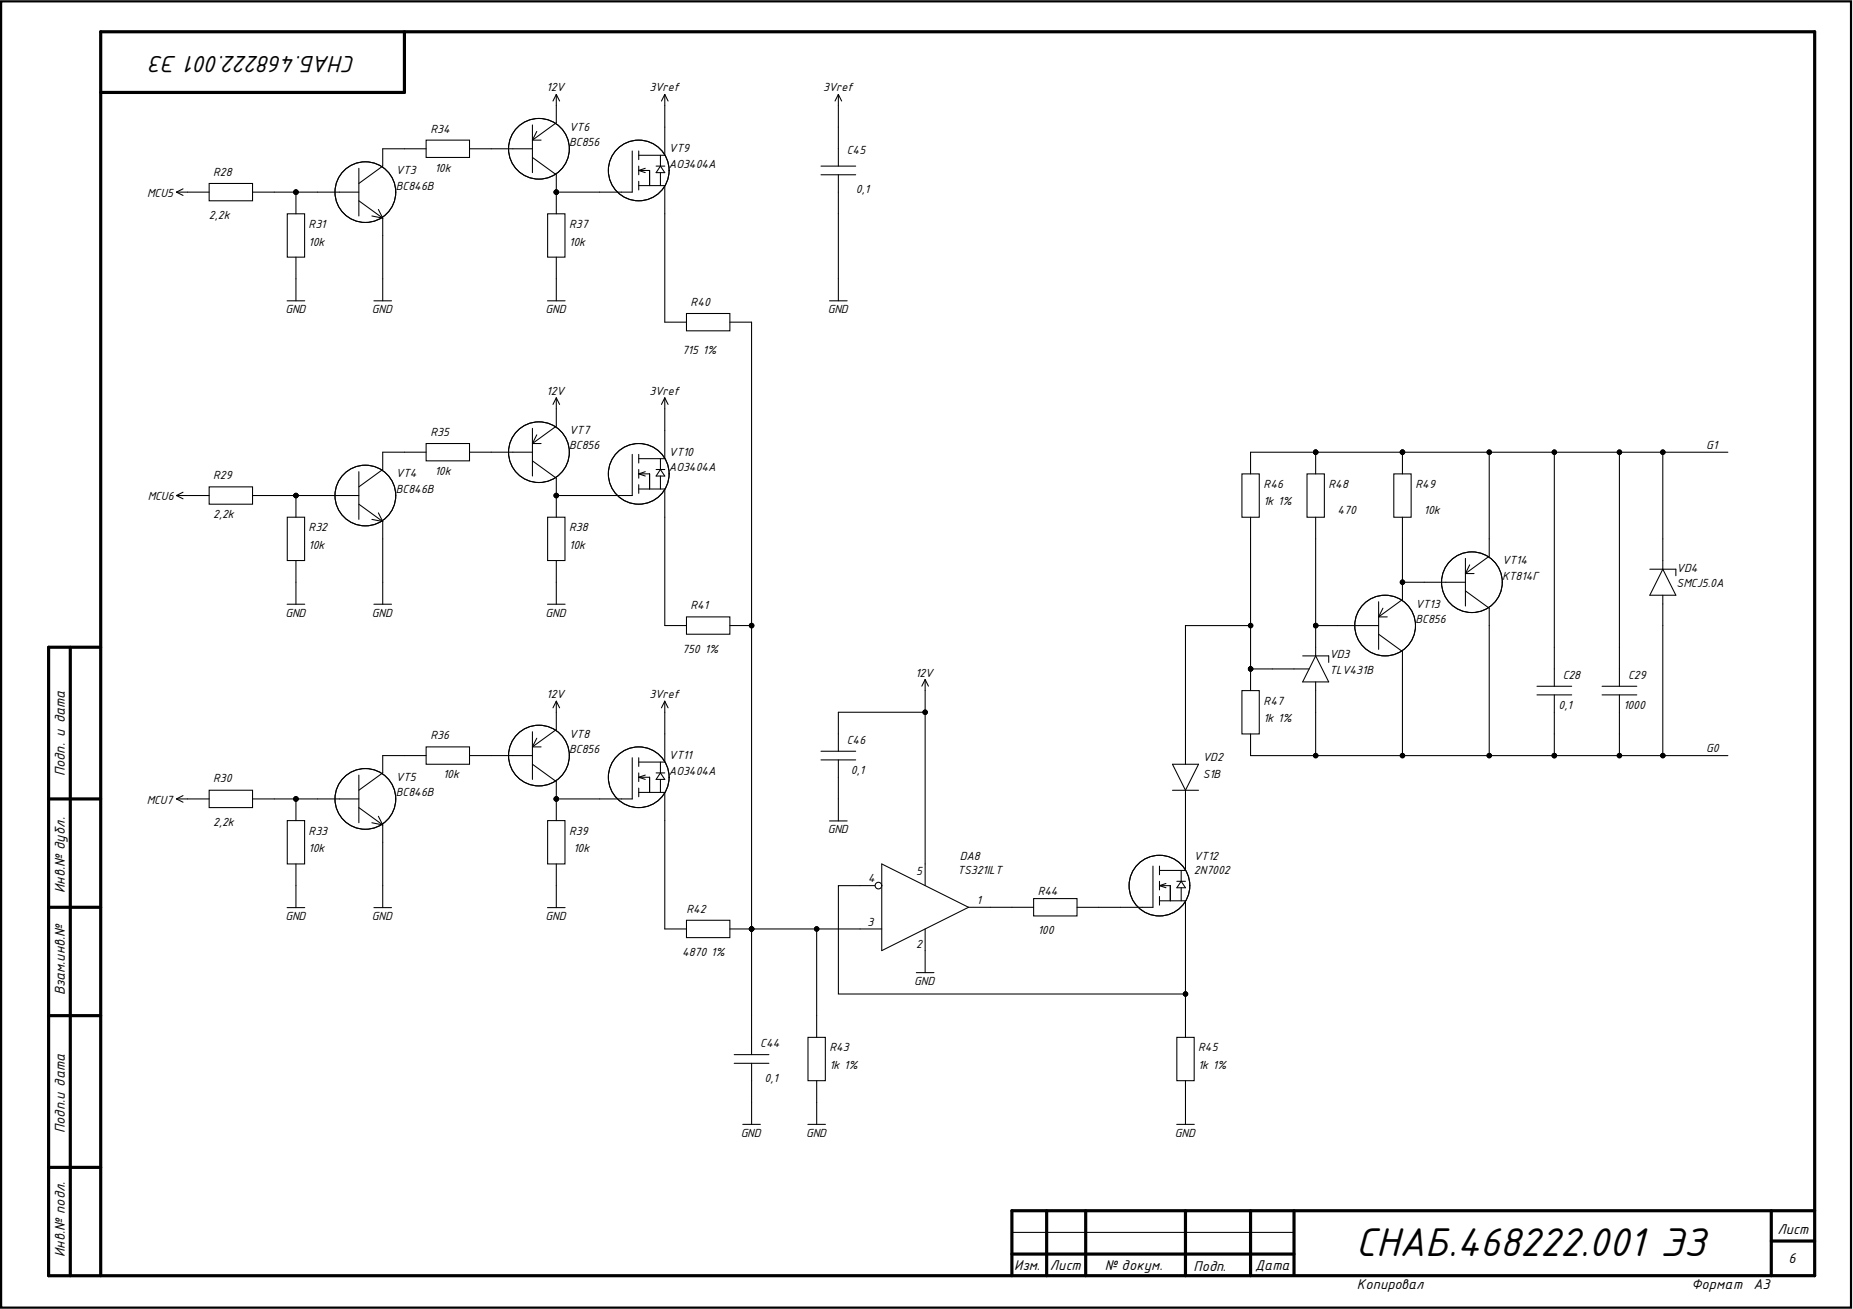
[picture p18: page 6]

Инв.№ подл. Подп.и дата Взам.инв.№ Инв.№ дубл.

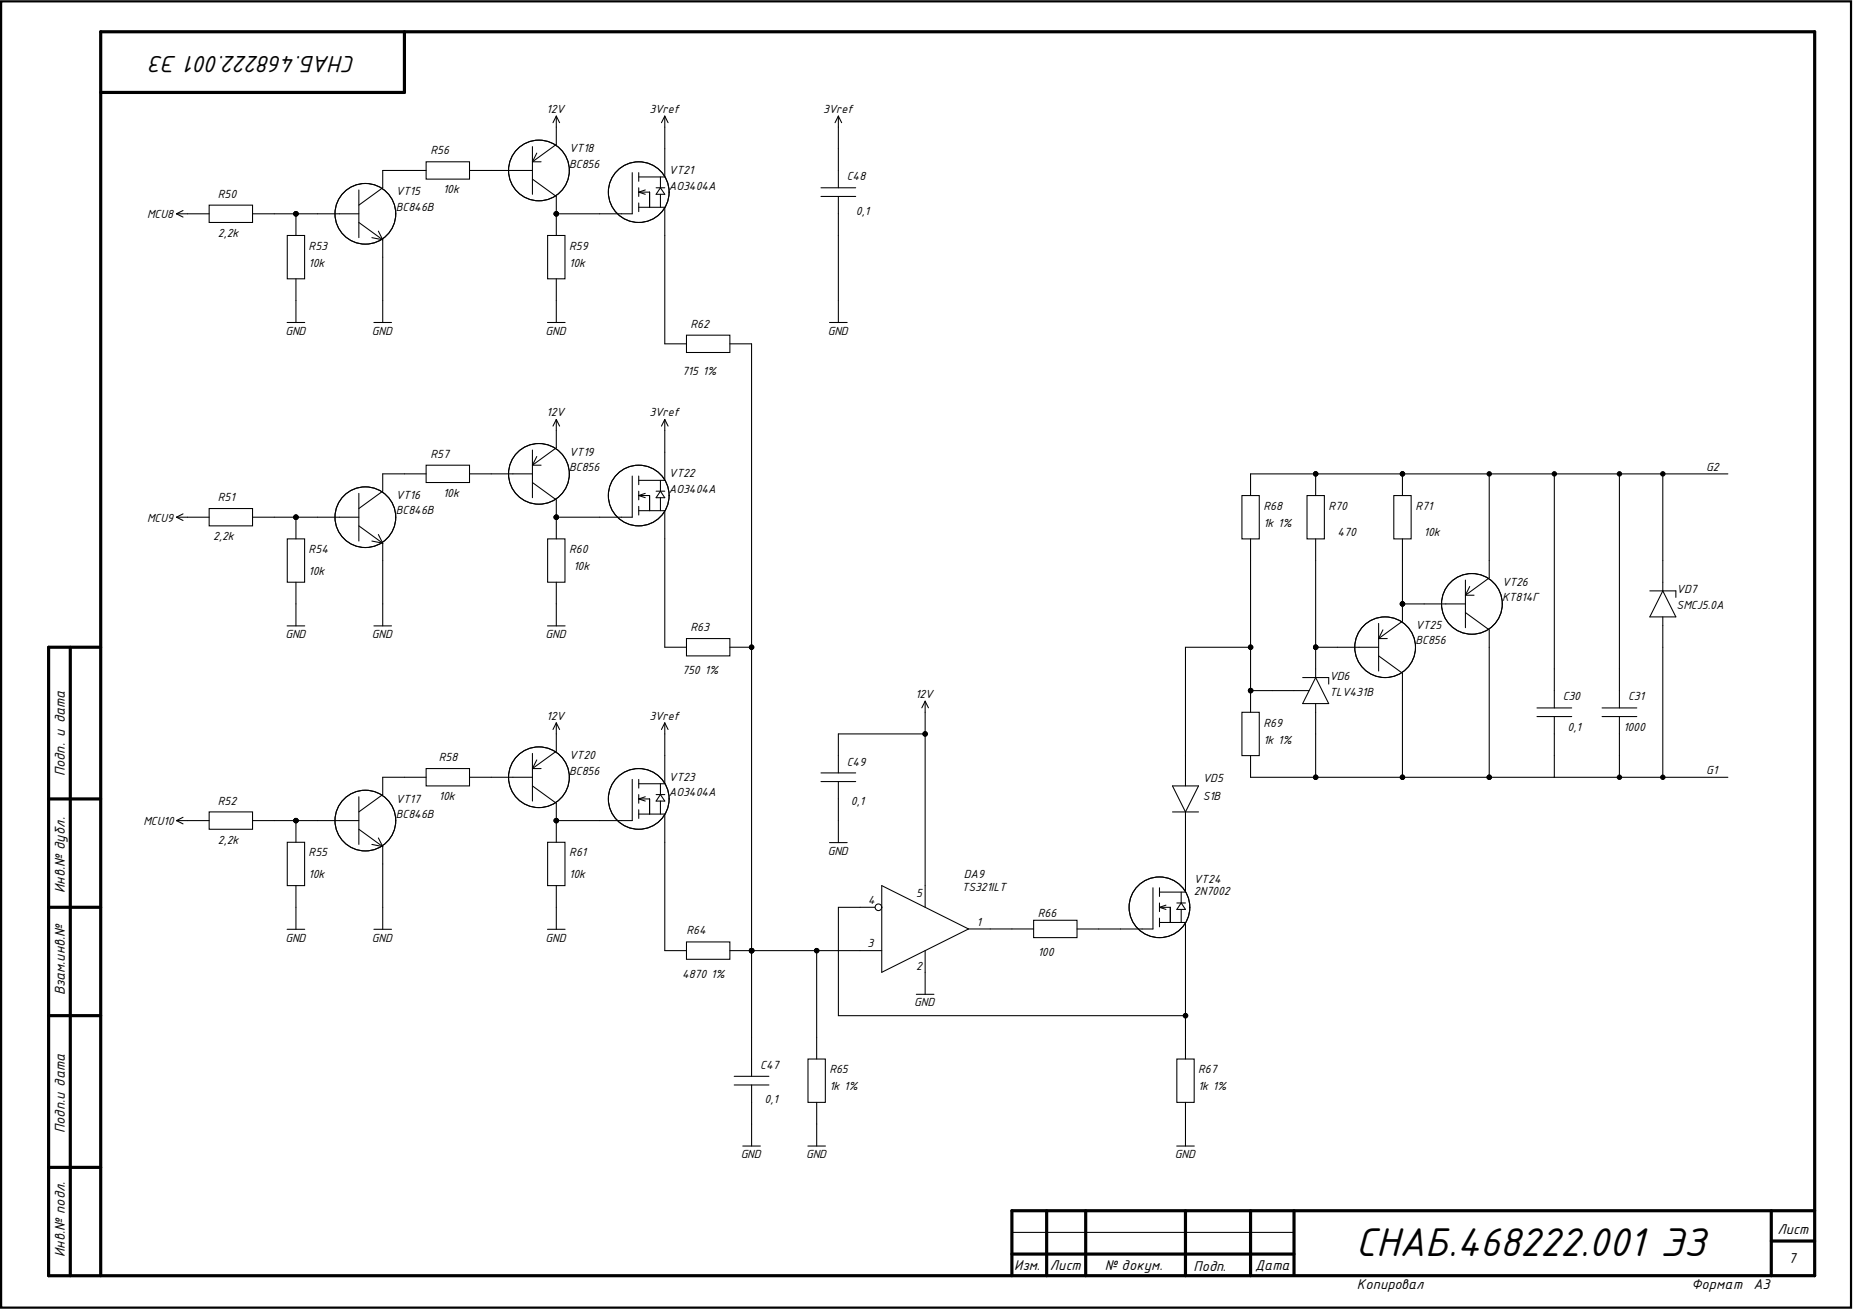
[picture p19: page 7]

Инв.№ подл. Подп.и дата Взам.инв.№ Инв.№ дубл.

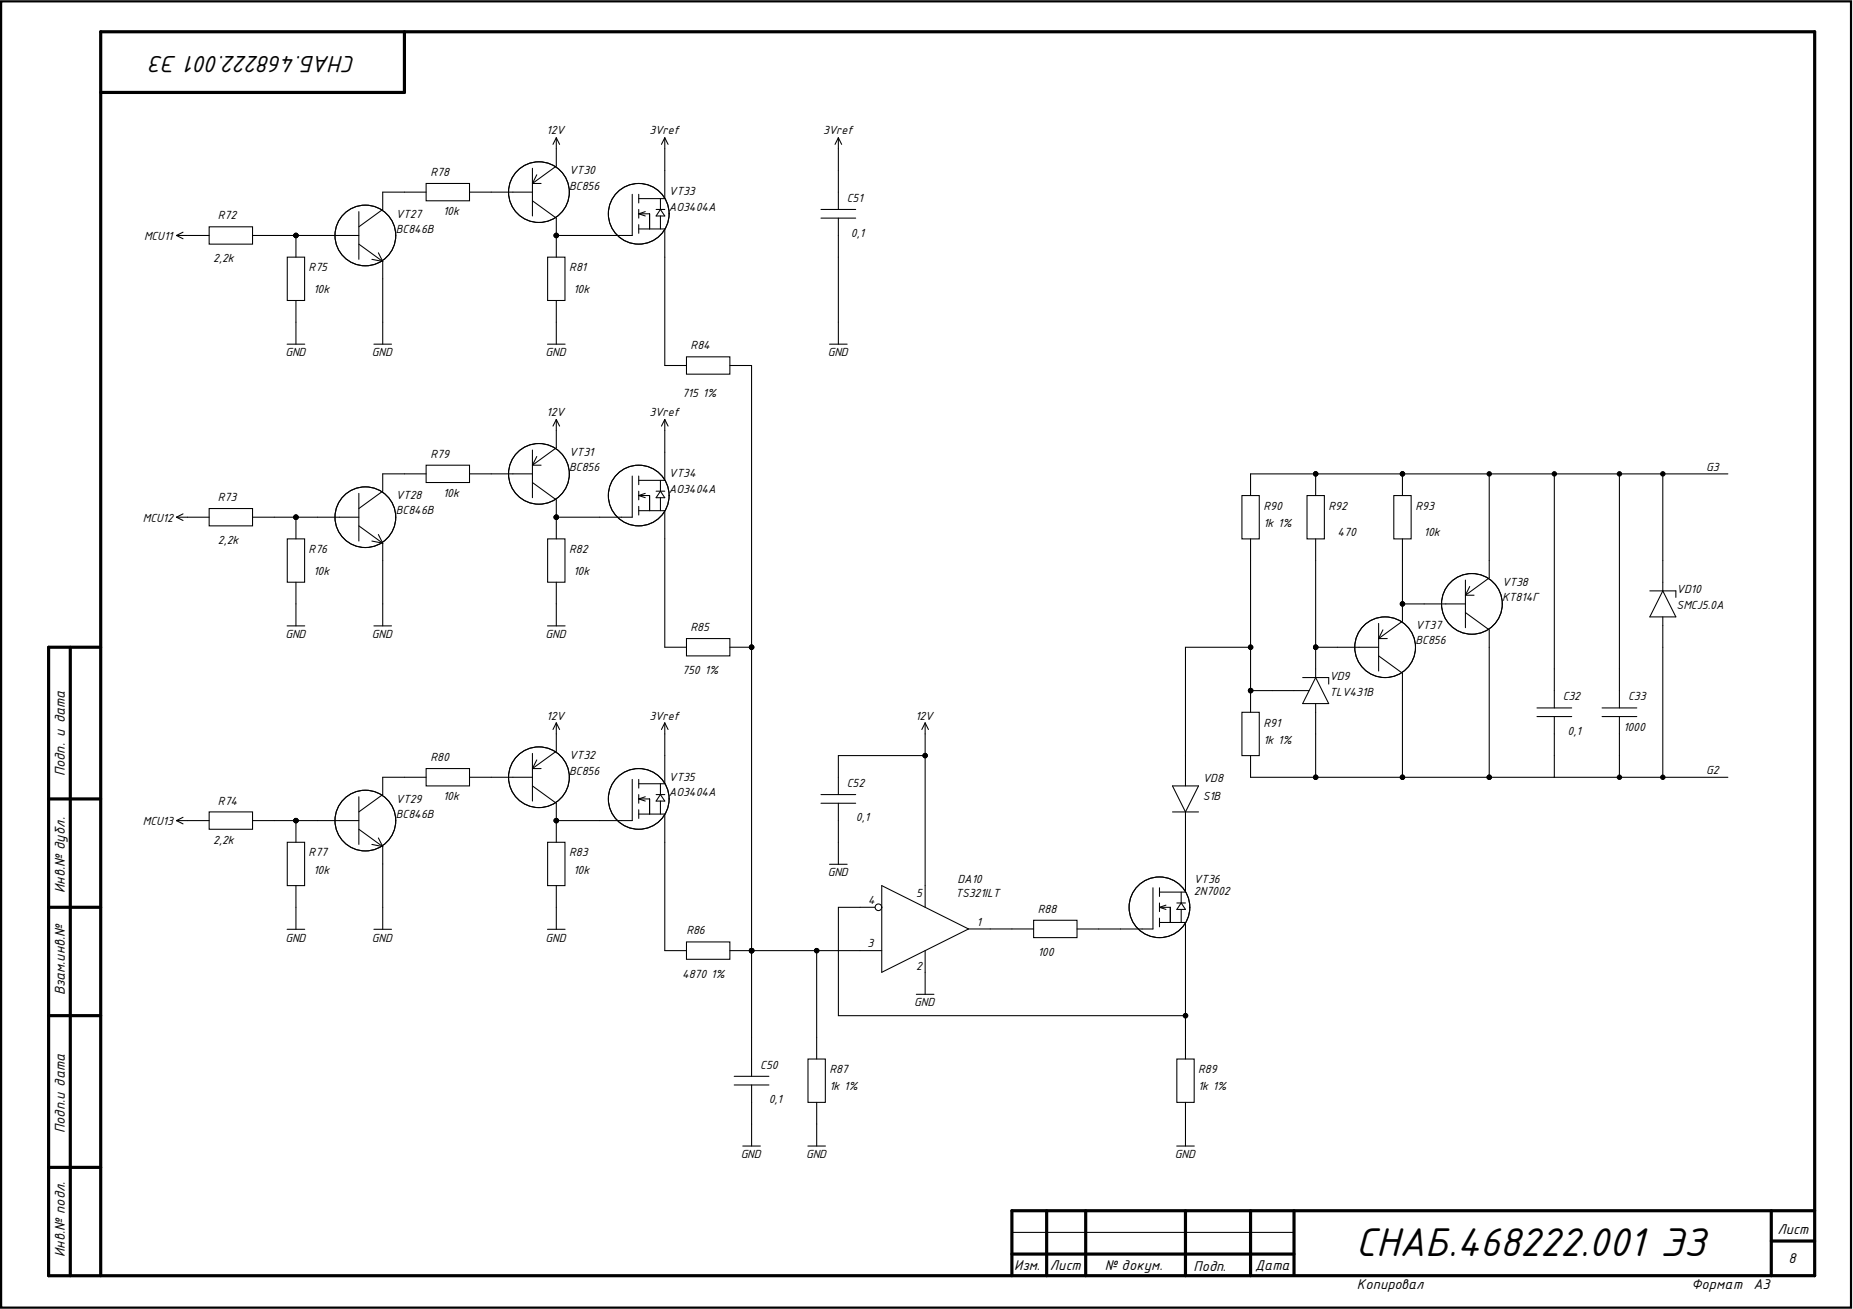
[picture p20: page 8]

Инв.№ подл. Подп.и дата Взам.инв.№ Инв.№ дубл.

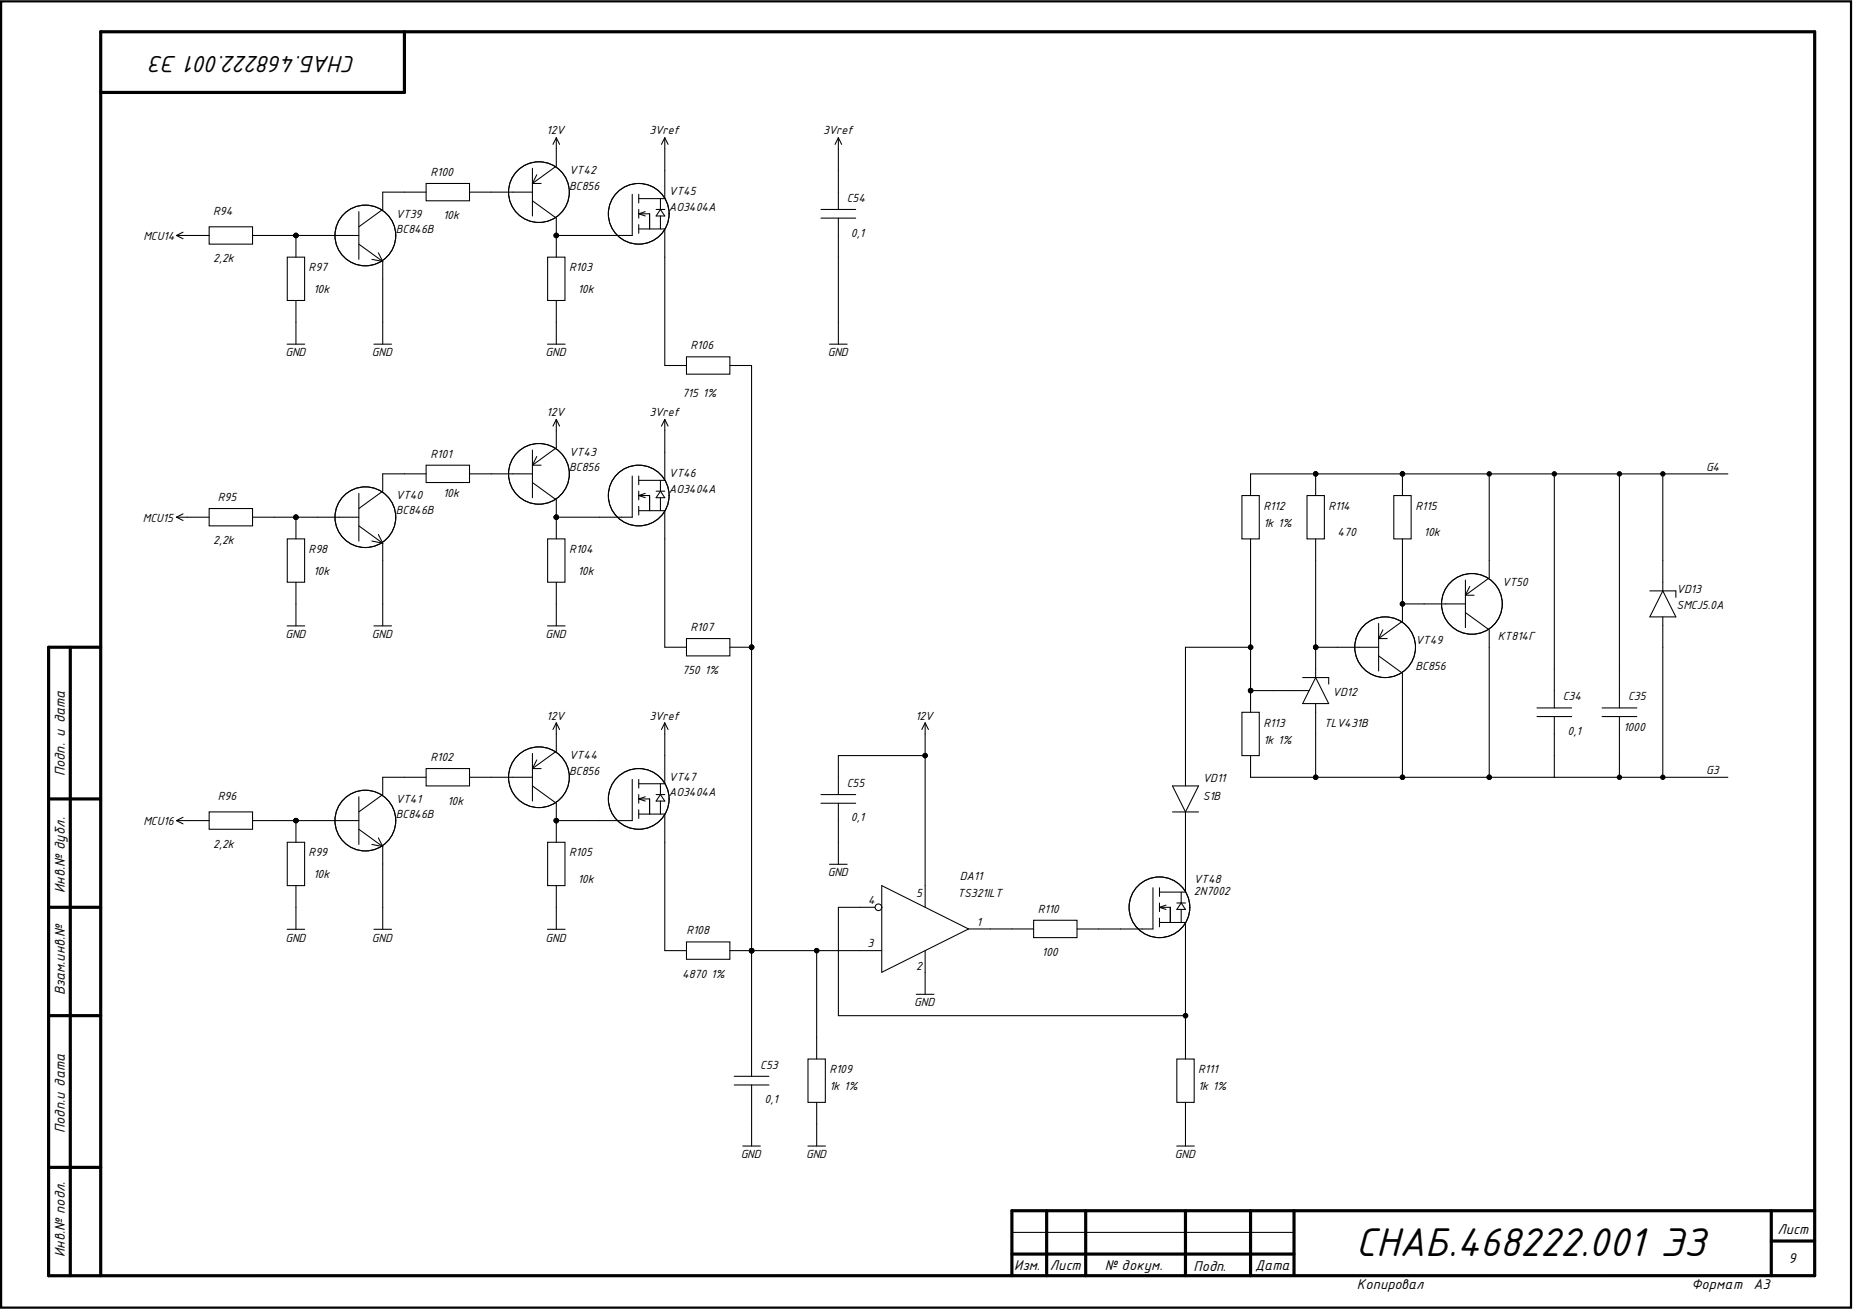
[picture p21: page 9]

Инв.№ подл. Подп.и дата Взам.инв.№ Инв.№ дубл.

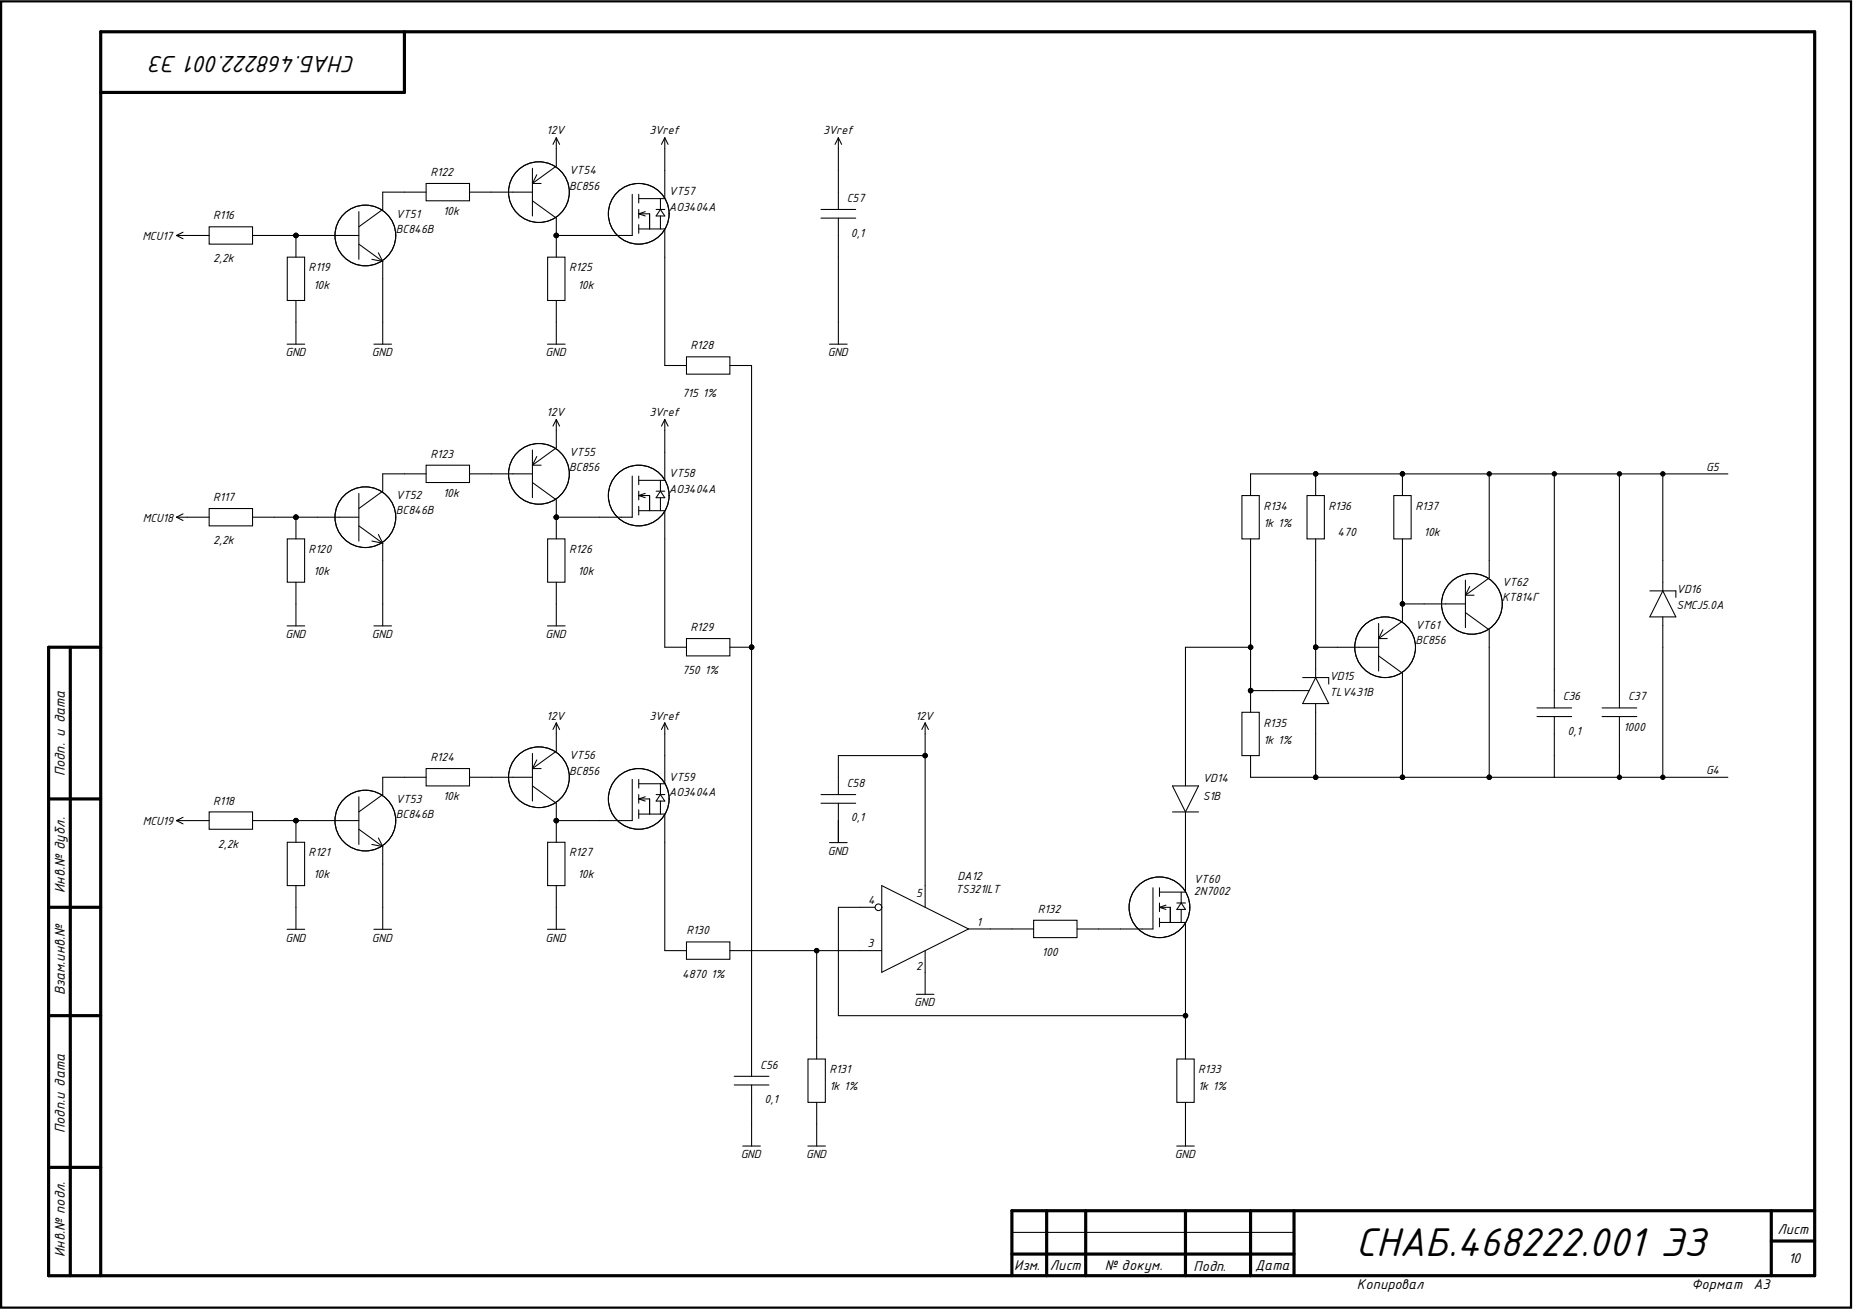
[picture p22: page 10]

Инв.№ подл. Подп.и дата Взам.инв.№ Инв.№ дубл.

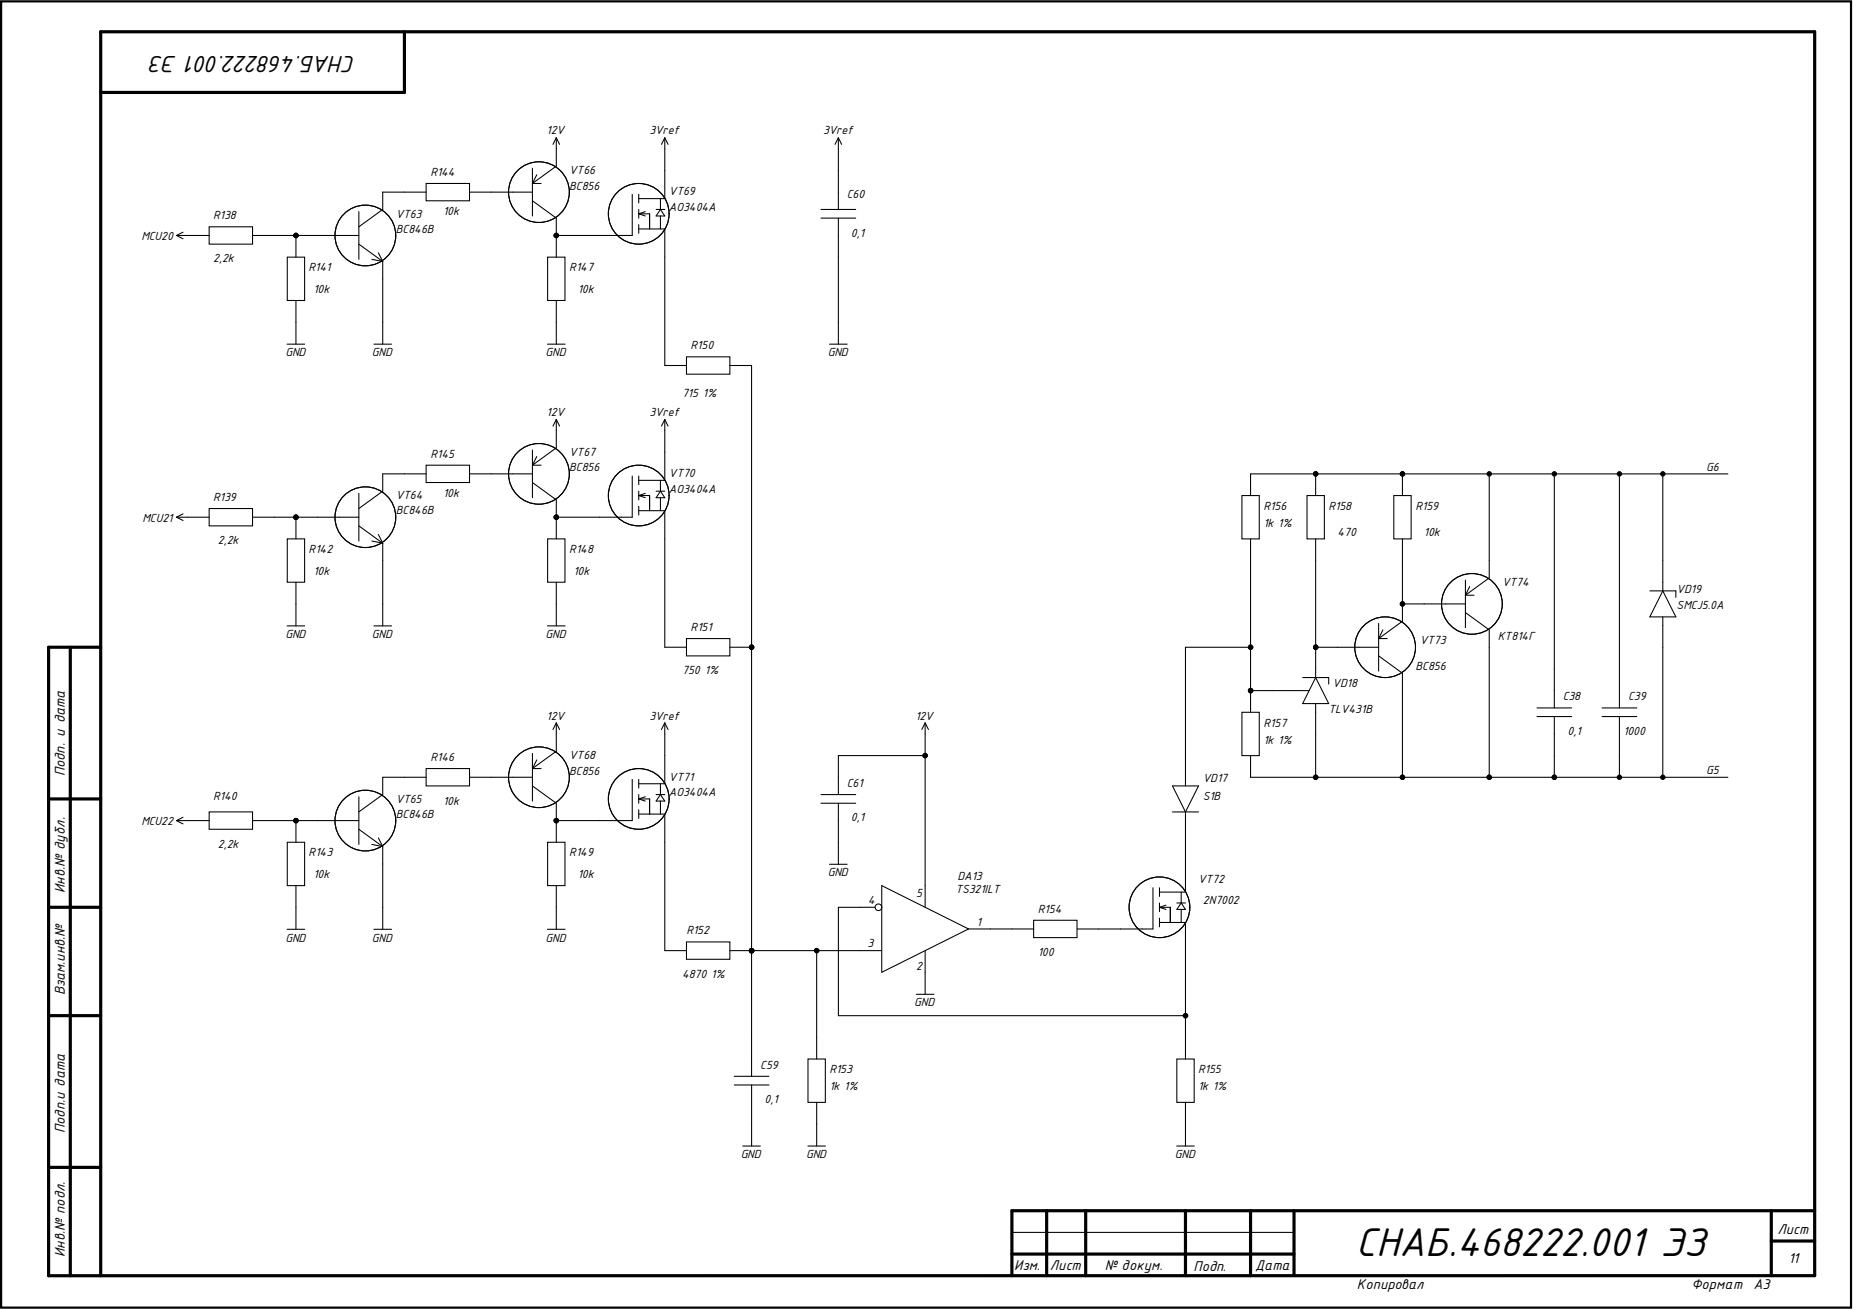
[picture p23: page 11]

Инв.№ подл. Подп.и дата Взам.инв.№ Инв.№ дубл.

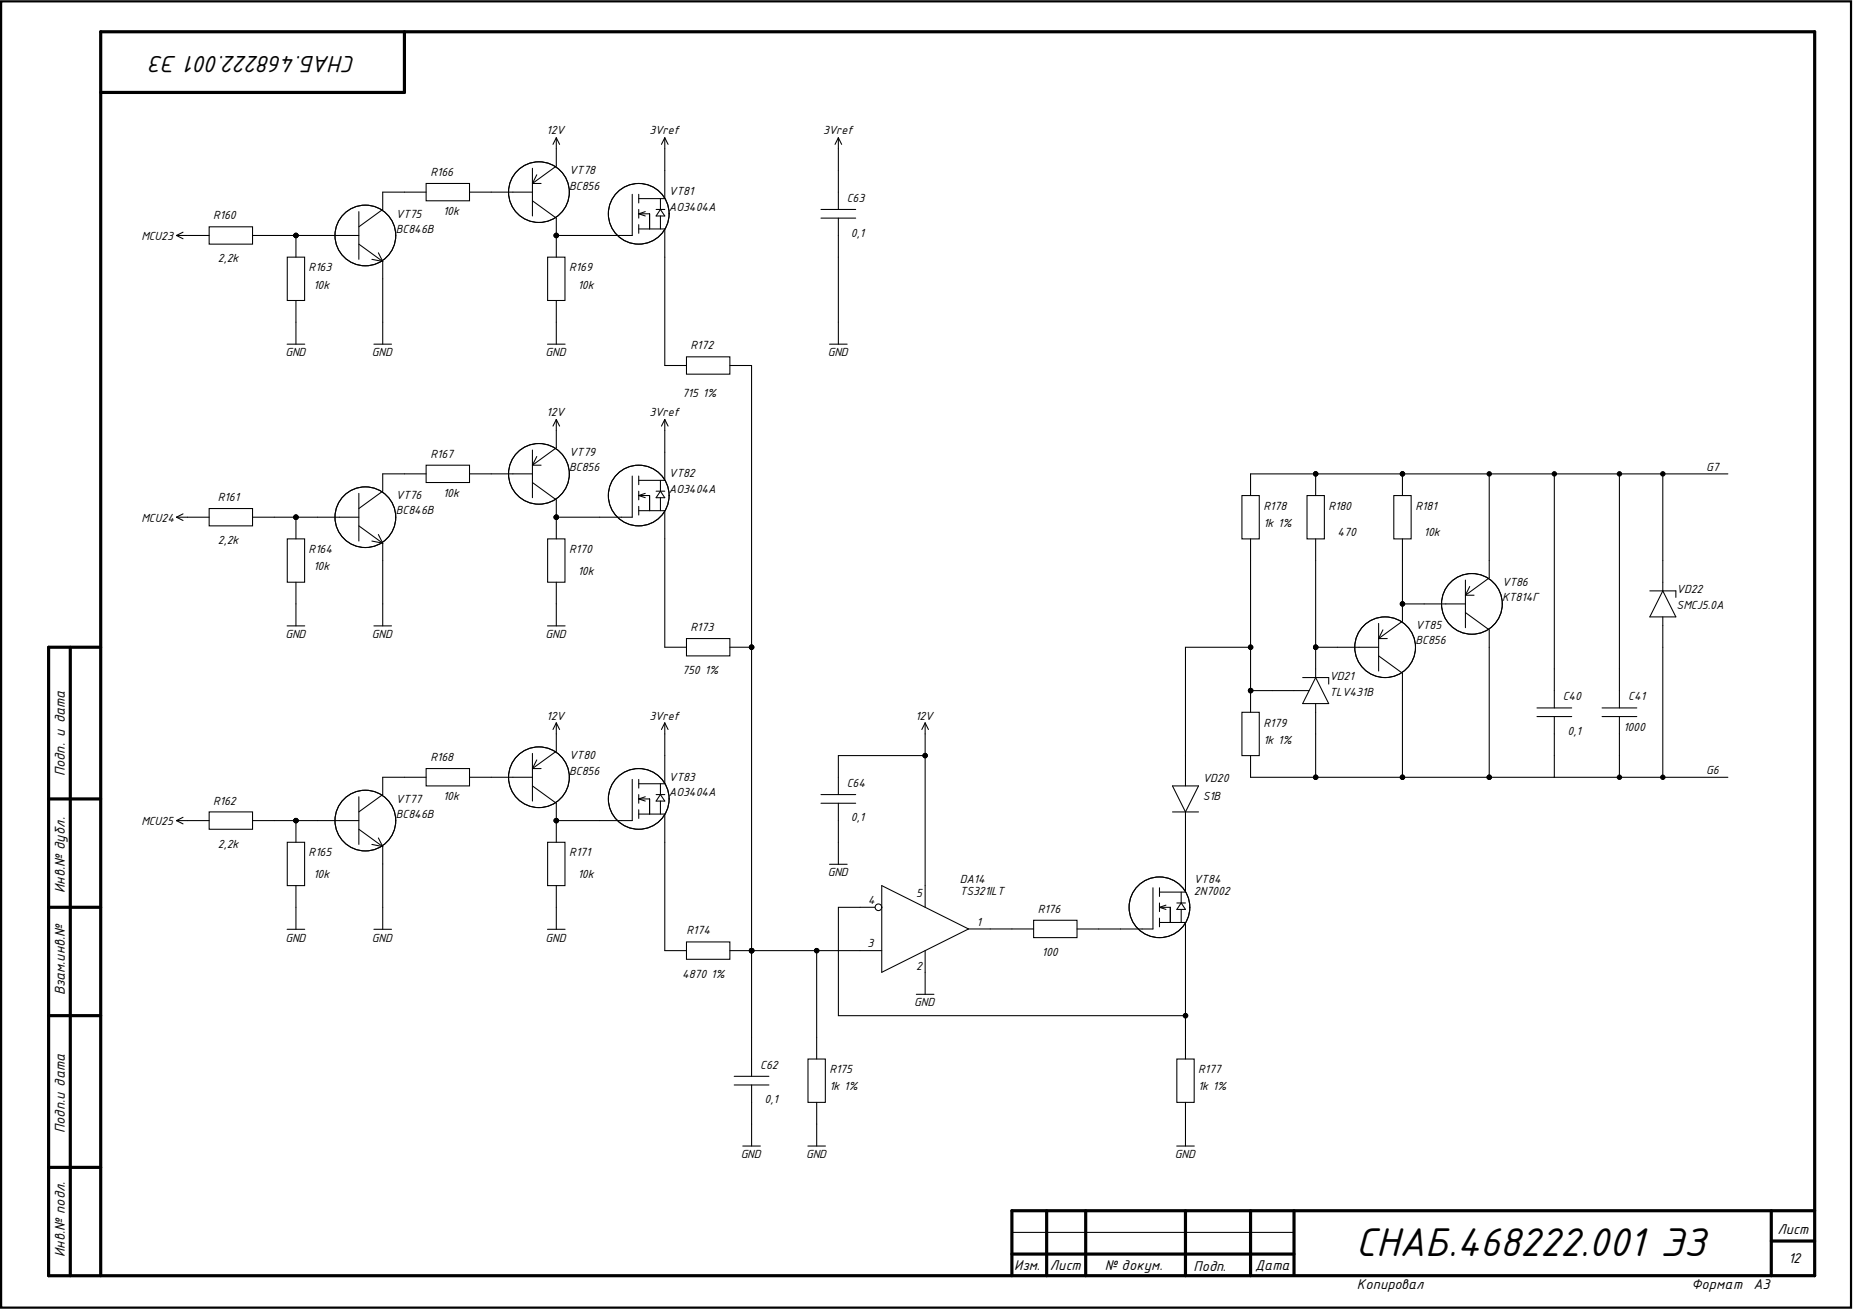
[picture p24: page 12]

Инв.№ подл. Подп.и дата Взам.инв.№ Инв.№ дубл.

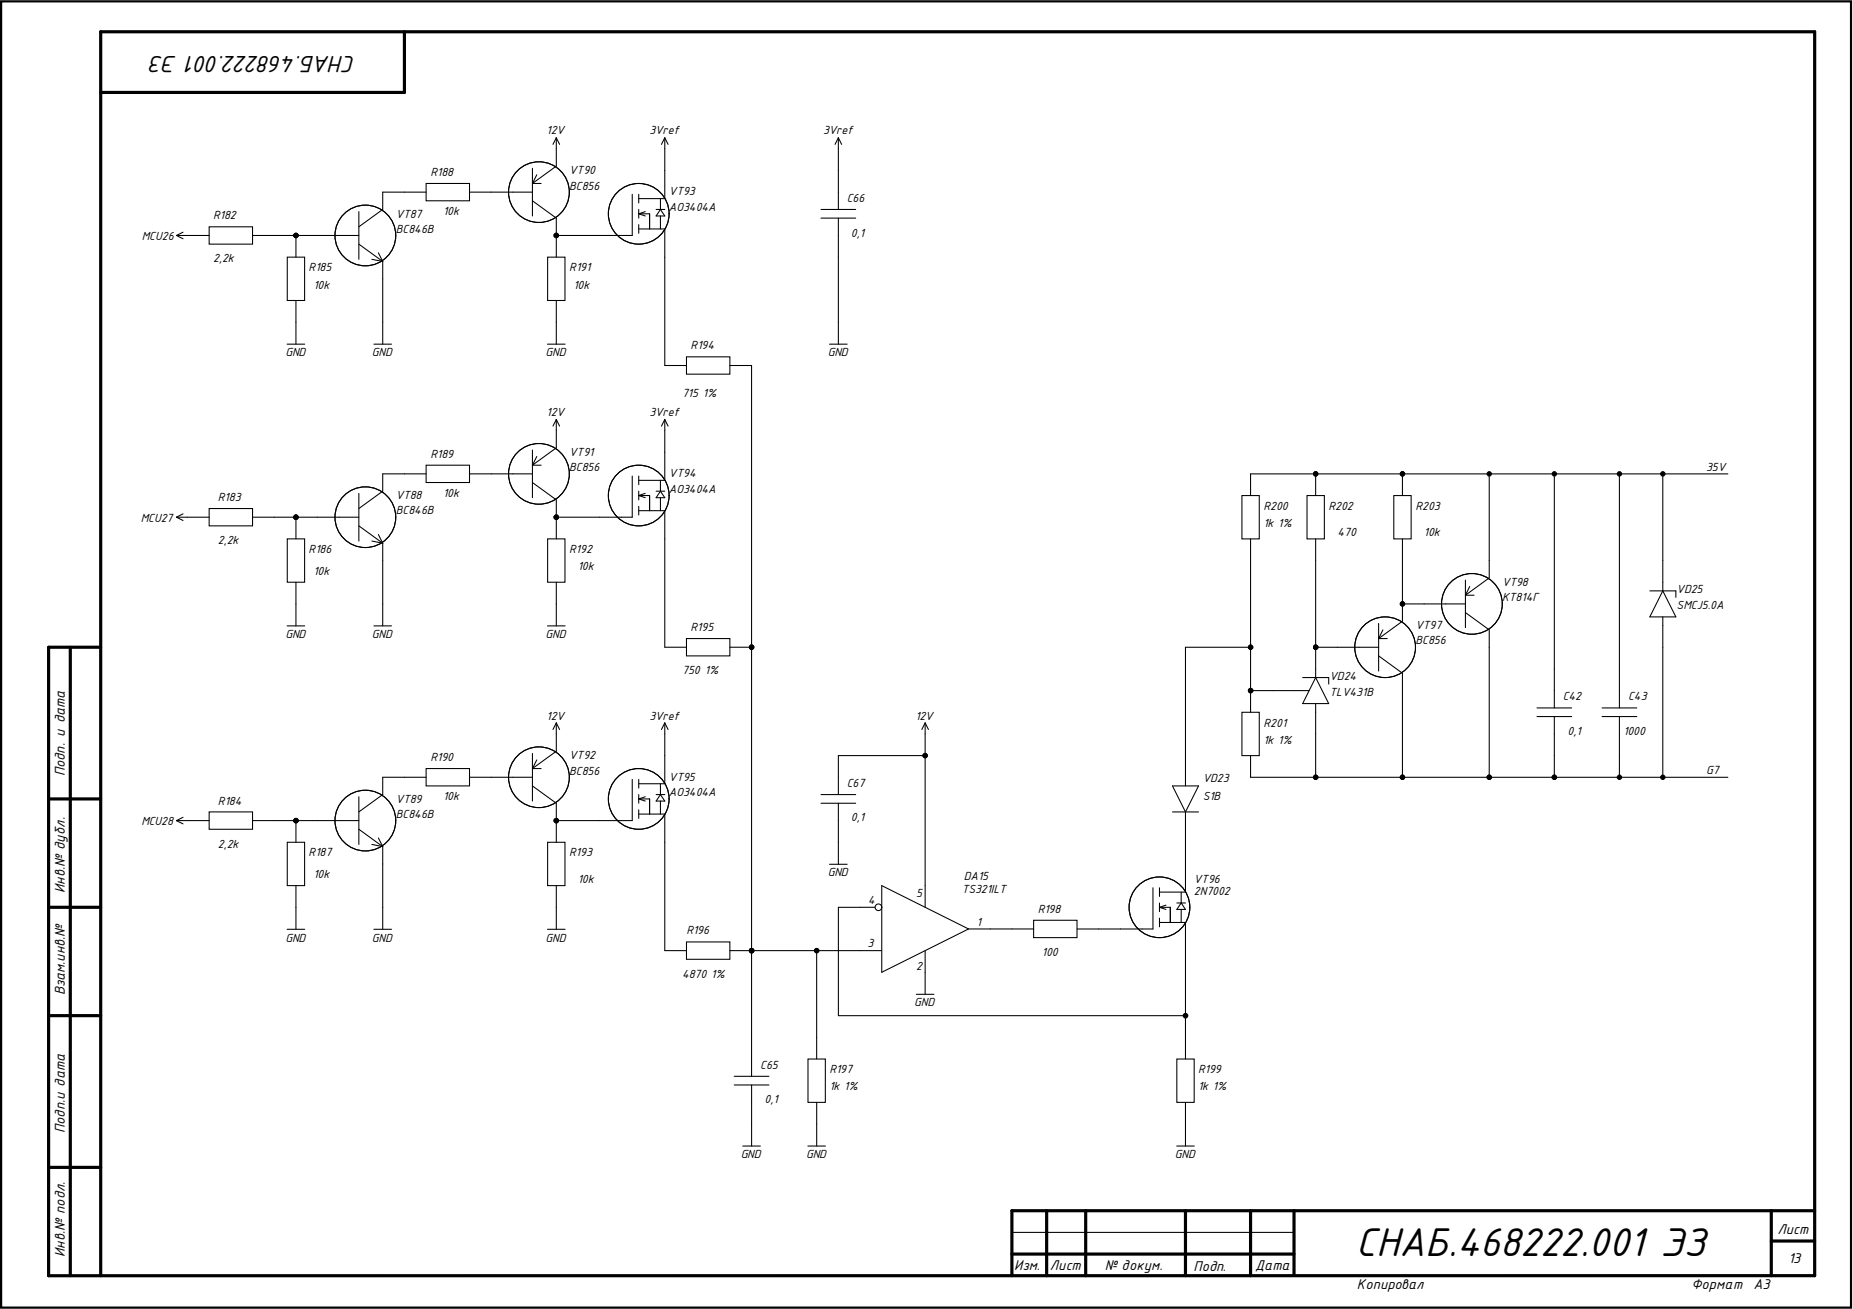
[picture p25: page 13]

Инв.№ подл. Подп.и дата Взам.инв.№ Инв.№ дубл.
