kuropatoochka/bms_stand/bms_docs/СНАБ.468222.001 ПЭЗ Перечень элементов.pdf

Поз.
обозначение
Наименование | Кол. | Примечание
C1-C7 | Конденсатор GRM21BR71H104KA01L | 7 | Murata
С8-С10 | Конденсатор К53-67-20 В-22 мкФ | 3 | АО "НИИ "ГИРИКОНД"
С11-С28 | Конденсатор GRM188R71H104JA93D | 18 | Murata
C29 | Конденсатор GCM155R71H102KA37D | 1 | Murata
С30 | Конденсатор GRM188R71H104JA93D | 1 | Murata
C31 | Конденсатор GCM155R71H102KA37D | 1 | Murata
C32 | Конденсатор GRM188R71H104JA93D | 1 | Murata
C33 | Конденсатор GCM155R71H102KA37D | 1 | Murata
C34 | Конденсатор GRM188R71H104JA93D | 1 | Murata
C35 | Конденсатор GCM155R71H102KA37D | 1 | Murata
С36 | Конденсатор GRM188R71H104JA93D | 1 | Murata
С37 | Конденсатор GCM155R71H102KA37D | 1 | Murata
С38 | Конденсатор GRM188R71H104JA93D | 1 | Murata
С39 | Конденсатор GCM155R71H102KA37D | 1 | Murata
С40 | Конденсатор GRM188R71H104JA93D | 1 | Murata
С41 | Конденсатор GCM155R71H102KA37D | 1 | Murata
С42 | Конденсатор GRM188R71H104JA93D | 1 | Murata
С43 | Конденсатор GCM155R71H102KA37D | 1 | Murata
С44-С67 Конденсатор GRM188R71H104JA93D | | 23 | Murata
D1 | Микросхема К1986ВЕ92QI | 1 | АО «ПКК Миландр»
DA1-DA4 Оптореле PRAB30S | | 4 | ОАО «Протон»
DA5 | Стабилизатор напряжения UMW 78D12L | 1 | UTD Semiconductor
DA6 | LDO-регулятор напряжения LD1117DT33TR | 1 | STMicroelectronics
DA7 | Источник опорного напряжения REF193GSZ-REEL | 1 | Analog Devices
DA8-DA15 Операционный усилитель TS321ILT | | 8 | STMicroelectronics

Н. контр.
Утв.
Изм. | Лист | № докум. | Подп. | Дата
| | Разраб. | Петрова Беляев | | Модуль измерительный Перечень элементов | Лит. | Лист | Листов
Пров. | | | | | | | 1 | 8

Справ. № Перв. примен. Подп. и дата Инв. № дубл. Взам. инв. № Подп. и дата Инв. № подл.

Копировал | Формат А4

# СНАБ.468222.001 ПЭЗ

### Университет ИТМО

A | A

Не для коммерческого использования

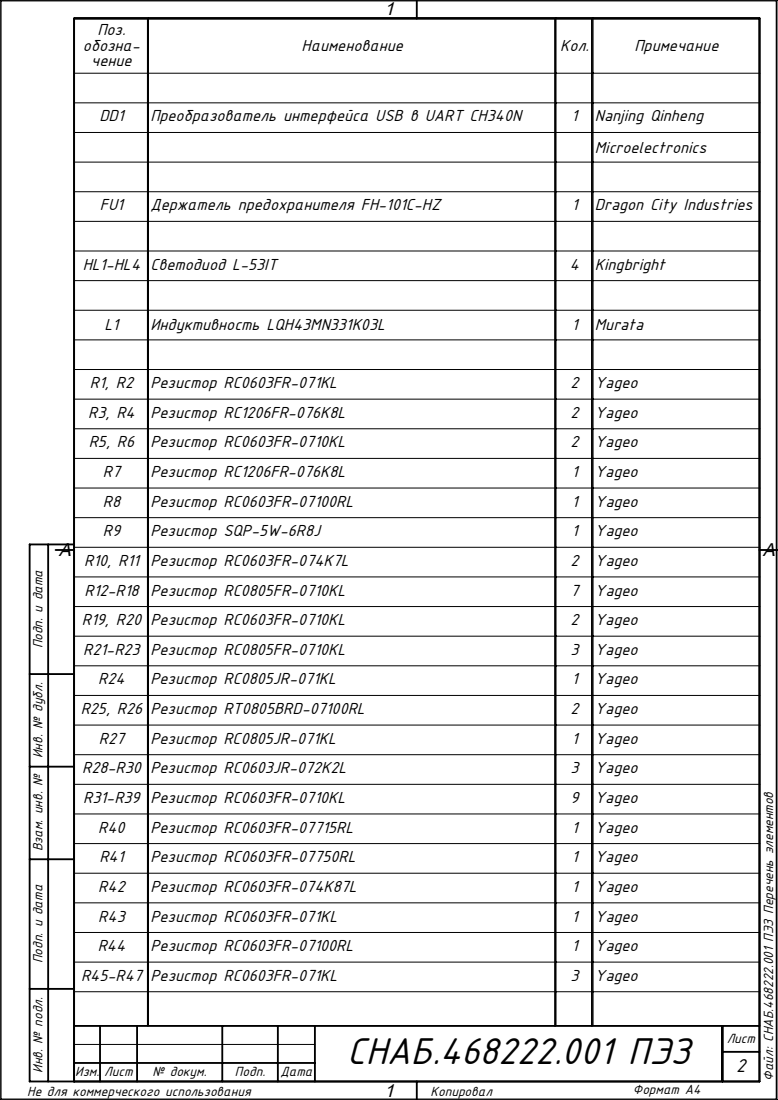
[picture p26: page 2]

Подп. и дата Взам. инв. № Инв. № дубл. Подп. и дата

Файл: СНАБ.468222.001 ПЭЗ Перечень элементов

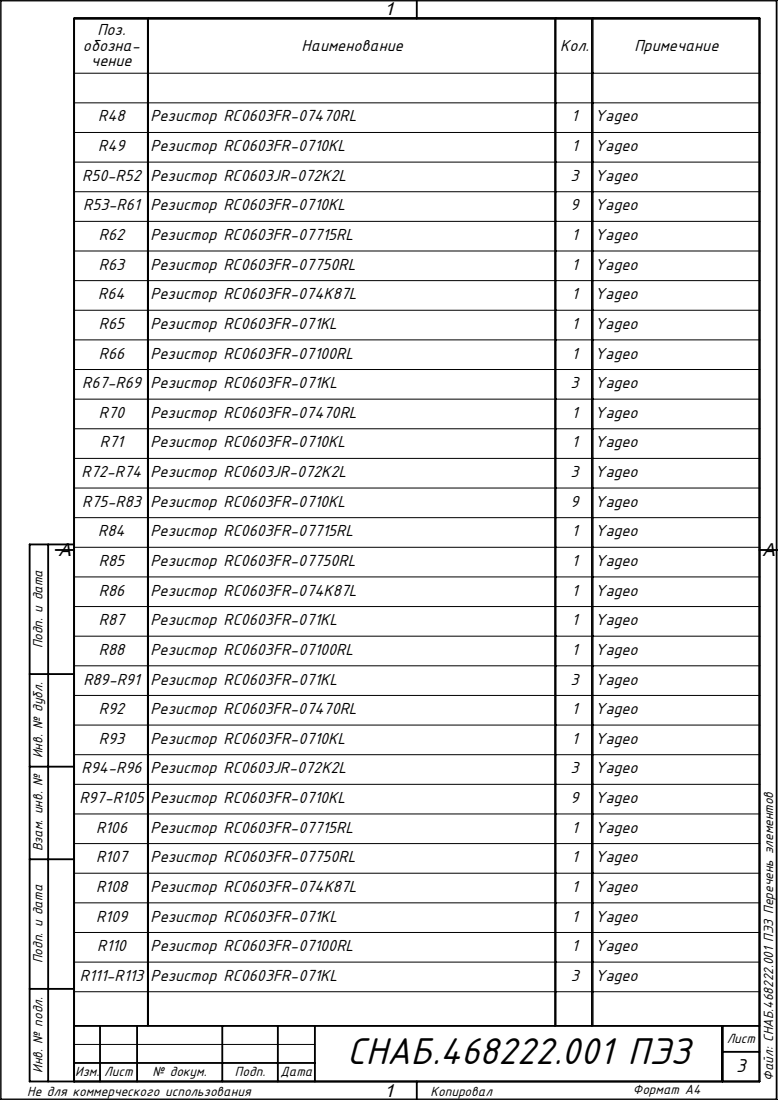
[picture p27: page 3]

Подп. и дата Взам. инв. № Инв. № дубл. Подп. и дата

Файл: СНАБ.468222.001 ПЭЗ Перечень элементов

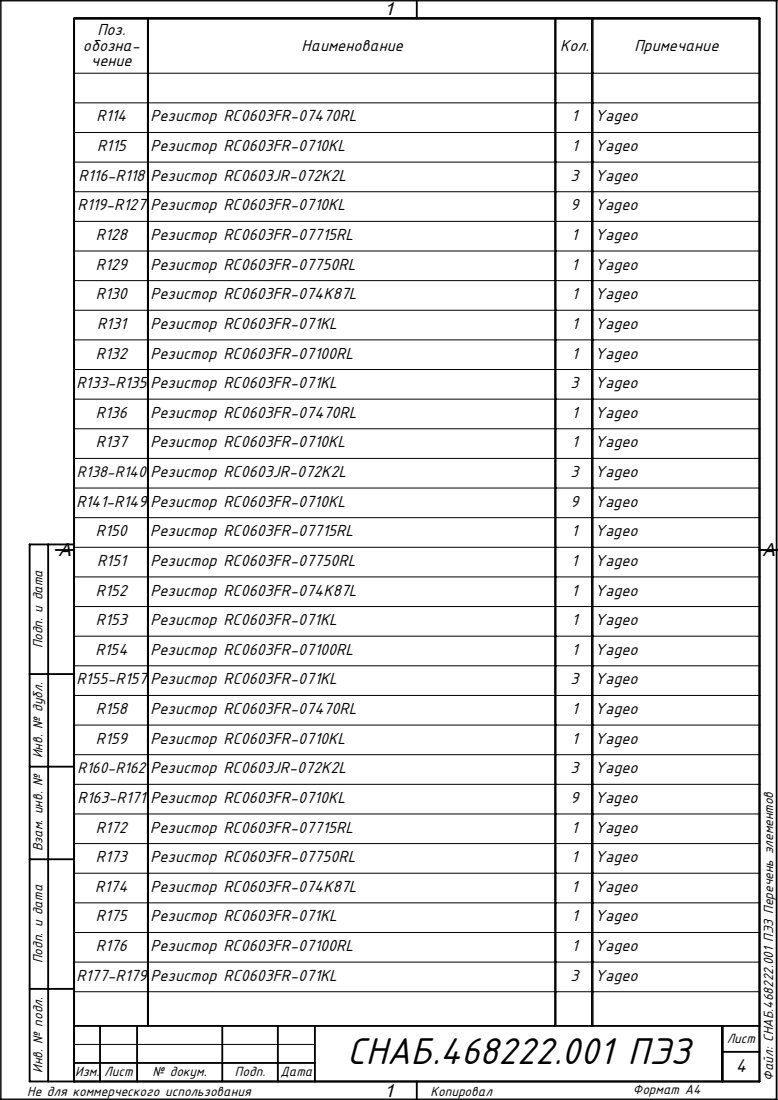
[picture p28: page 4]

Подп. и дата Взам. инв. № Инв. № дубл. Подп. и дата

Файл: СНАБ.468222.001 ПЭЗ Перечень элементов

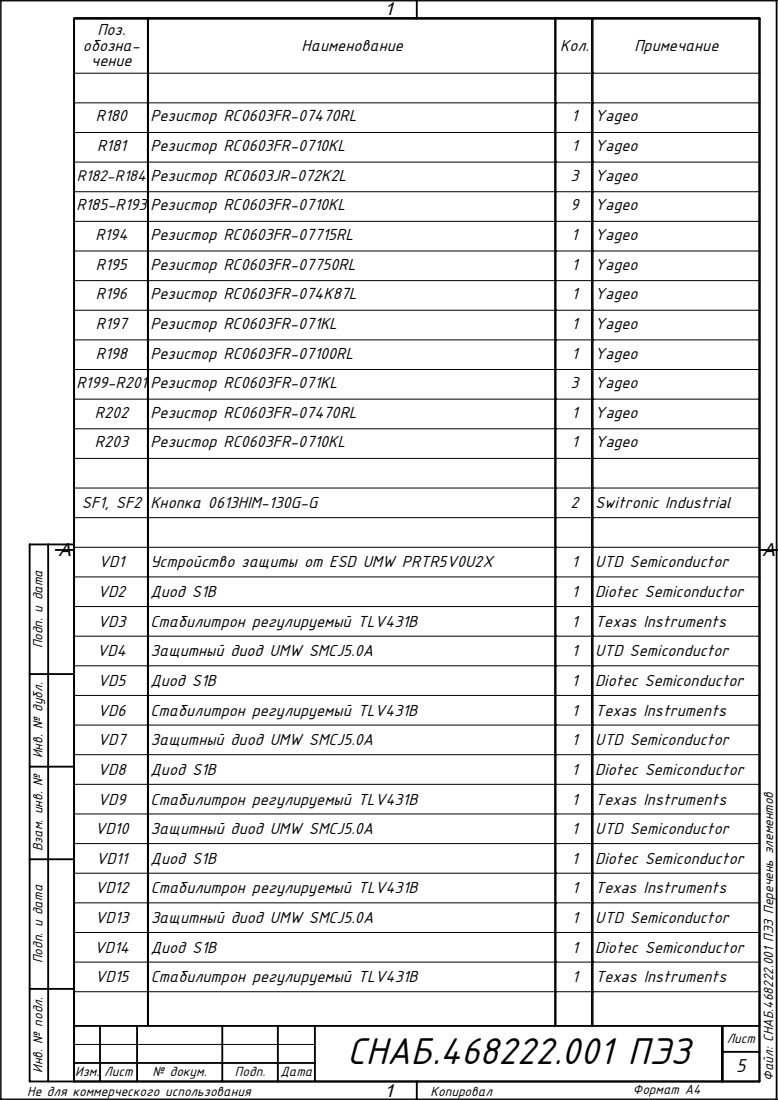
[picture p29: page 5]

Подп. и дата Взам. инв. № Инв. № дубл. Подп. и дата

Файл: СНАБ.468222.001 ПЭЗ Перечень элементов

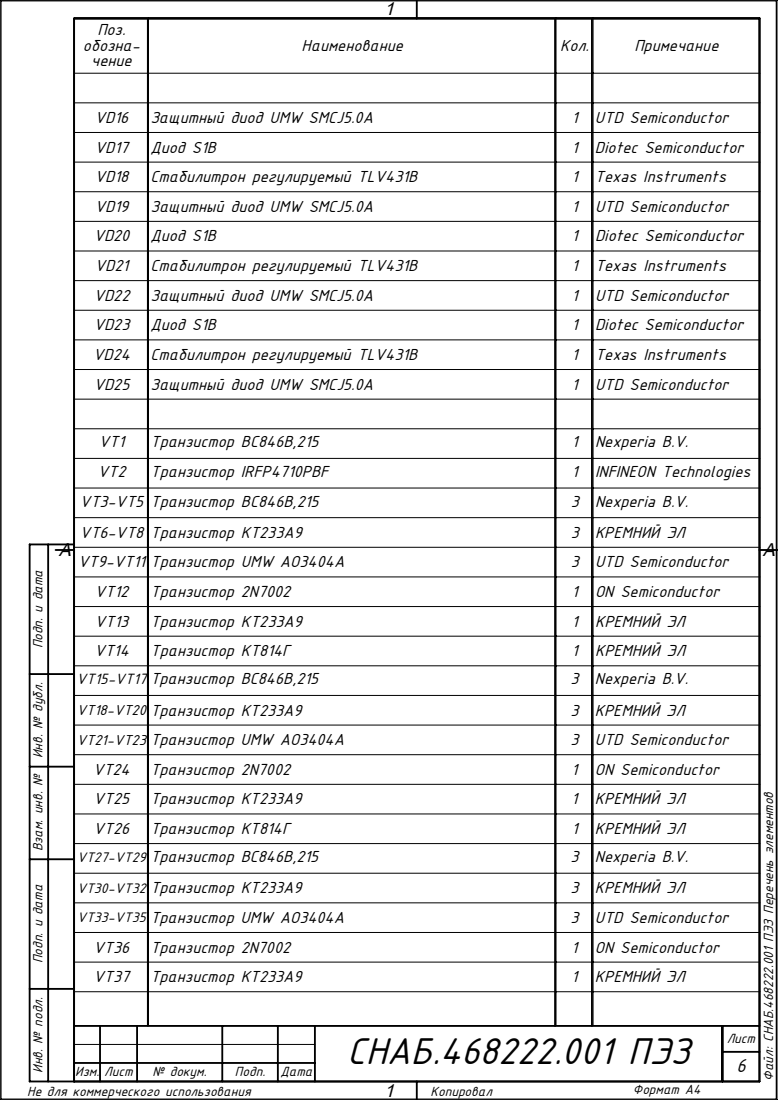
[picture p30: page 6]
Защитный диод UMW SMCJ5.0A; UTD Semiconductor; Диод S1B; Diotec Semiconductor; Стабилитрон регулируемый TLV431B; Texas Instruments; Транзистор BC846B,215; Nexperia B.V.; Транзистор IRFP4710PBF; INFINEON Technologies; VT3-VT5 Транзистор BC846B,215; VT6-VT8 Транзистор КТ233А9; КРЕМНИЙ ЭЛ; VT9-VT11 Транзистор UMW AO3404A; Транзистор 2N7002; ON Semiconductor; Транзистор КТ233А9; Транзистор KT814Г; VT15-VT17 Транзистор BC846B,215; VT18-VT20 Транзистор КТ233А9; VT21-VT23 Транзистор UMW AO3404A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

Подп. и дата Взам. инв. № Инв. № дубл. Подп. и дата

Файл: СНАБ.468222.001 ПЭЗ Перечень элементов

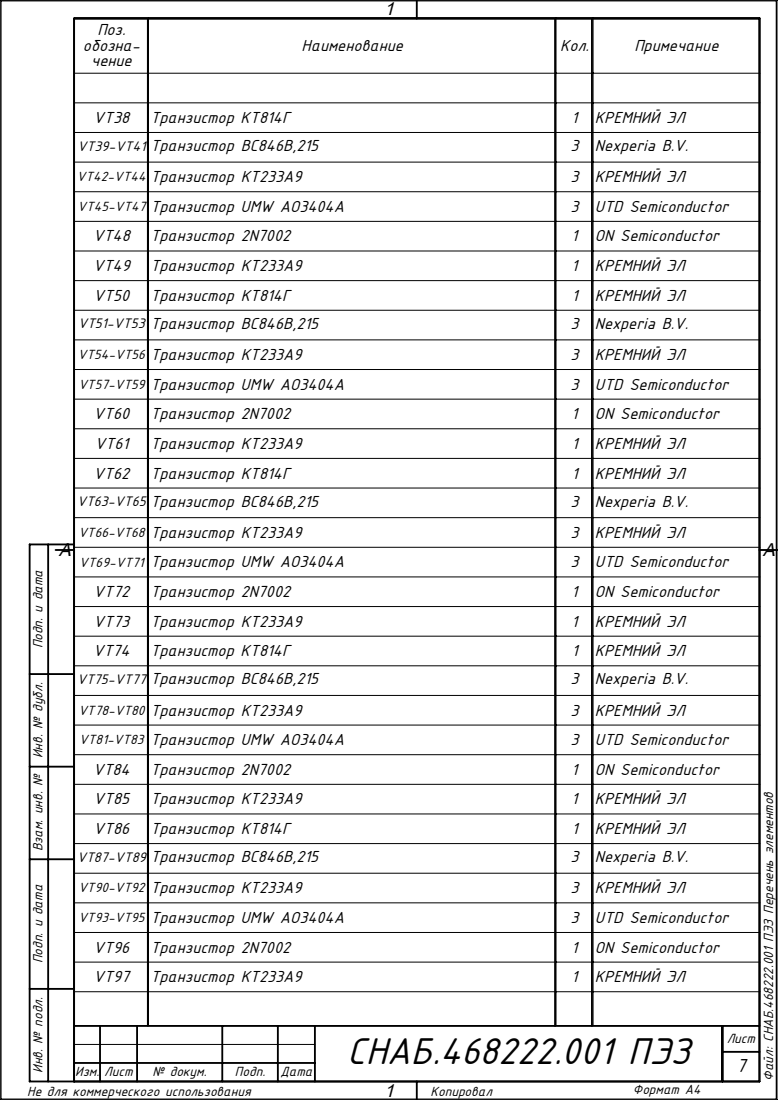
[picture p31: page 7]
Транзистор KT814Г; КРЕМНИЙ ЭЛ; VT39-VT41 Транзистор BC846B,215; Nexperia B.V.; VT42-VT44 Транзистор КТ233А9; VT45-VT47 Транзистор UMW AO3404A; UTD Semiconductor; Транзистор 2N7002; ON Semiconductor; Транзистор КТ233А9; VT51-VT53 Транзистор BC846B,215; VT54-VT56 Транзистор КТ233А9; VT57-VT59 Транзистор UMW AO3404A; VT63-VT65 Транзистор BC846B,215; VT66-VT68 Транзистор КТ233А9; VT69-VT71 Транзистор UMW AO3404A; VT75-VT77 Транзистор BC846B,215; VT78-VT80 Транзистор КТ233А9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

Подп. и дата Взам. инв. № Инв. № дубл. Подп. и дата

Файл: СНАБ.468222.001 ПЭЗ Перечень элементов

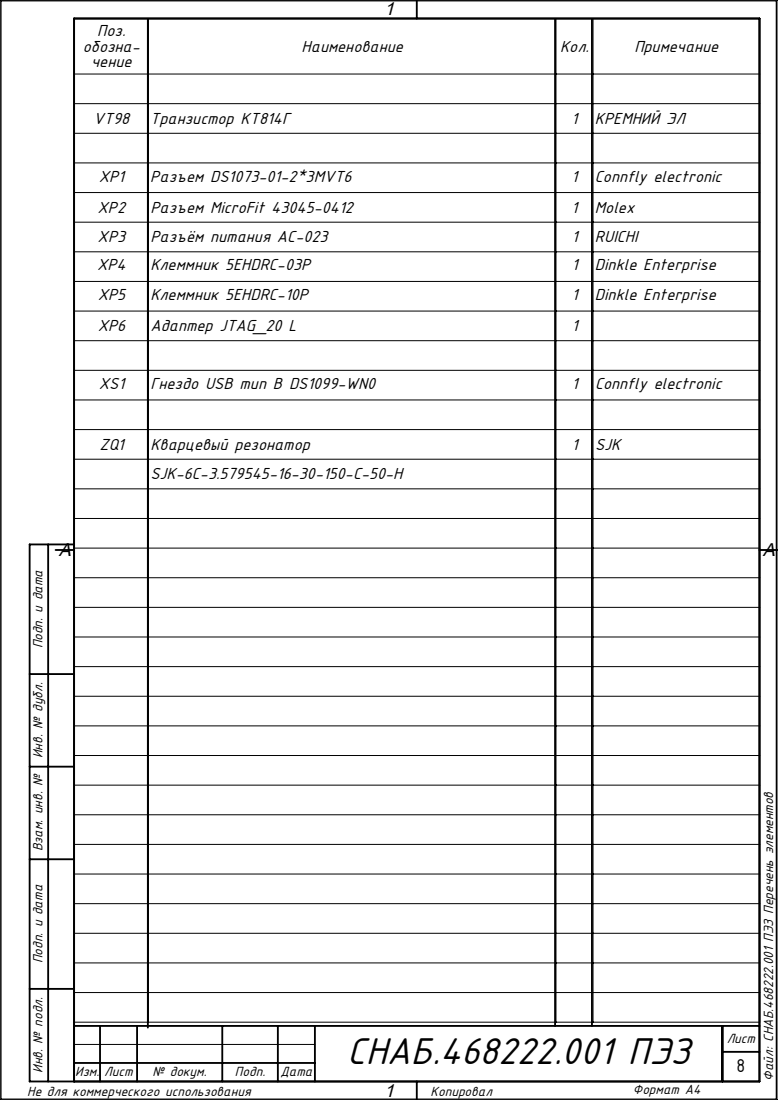
[picture p32: page 8]
Транзистор KT814Г; КРЕМНИЙ ЭЛ; Разъем DS1073-01-2*3MVT6; Connfly electronic; Разъем MicroFit 43045-0412; Molex; Разъём питания AC-023; RUICHI; Клеммник 5EHDRC-03P; Dinkle Enterprise; Клеммник 5EHDRC-10P; Адаптер JTAG_20 L; Гнездо USB тип B DS1099-WN0; Кварцевый резонатор; SJK; Инв. № подл.; № докум.; Подп.; Дата

Подп. и дата Взам. инв. № Инв. № дубл. Подп. и дата

Файл: СНАБ.468222.001 ПЭЗ Перечень элементов
