kuropatoochka/bms_stand/bms_docs/СНАБ.468222.001 Спецификация модуль измерительный.pdf

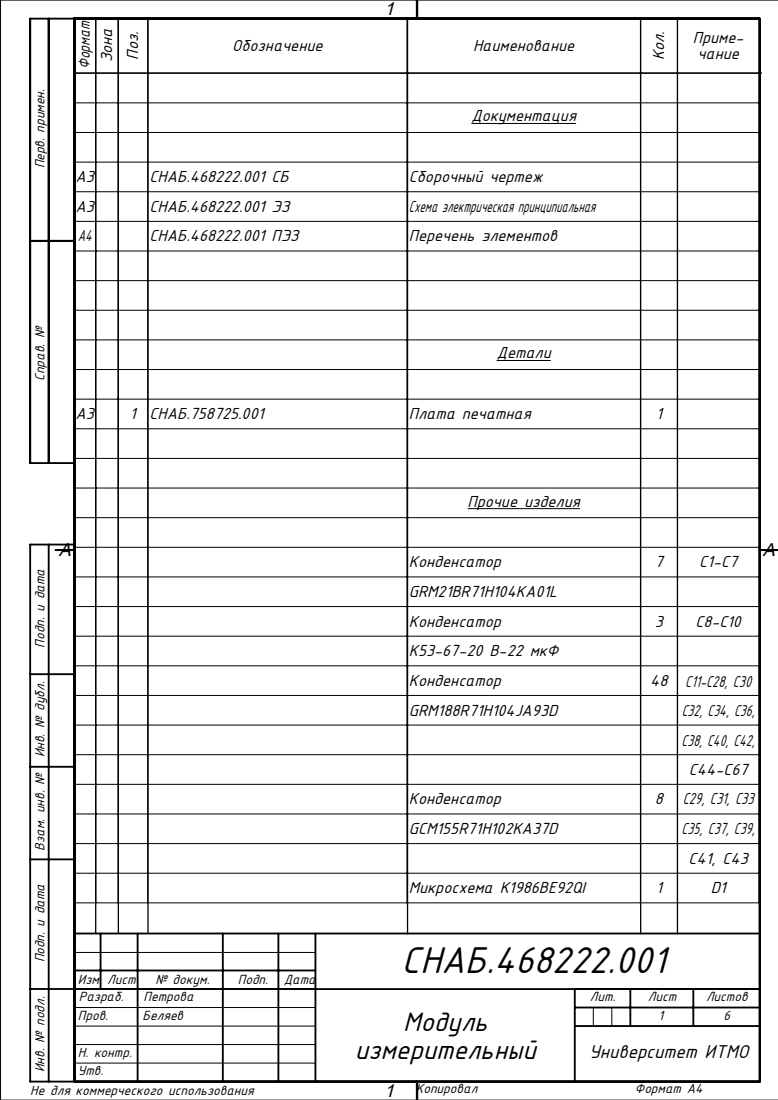
[picture p36: page 1]
СНАБ.468222.001 СБ; Сборочный чертеж; СНАБ.468222.001 ЭЗ; Схема электрическая принципиальная; СНАБ.468222.001 ПЭЗ; Перечень элементов; СНАБ.758725.001; Плата печатная; Прочие изделия; К53-67-20 В-22 мкФ; Конденсатор; GRM188R71H104JA93D; GCM155R71H102KA37D; Микросхема К1986ВЕ92QI; Университет ИТМО; Копировал; Формат А4

Инв. № подл. Подп. и дата Взам. инв. № Инв. № дубл. Подп. и дата Перв. примен. Справ. №

СНАБ.468222.001

Изм. | Лист № докум. | | Подп. | Дата
Разраб. | Петрова | | Модуль измерительный | Лит. | Лист | Листов
Пров. | Беляев | | | | | | 1 | 6

Н. контр.
Утв.

Не для коммерческого использования

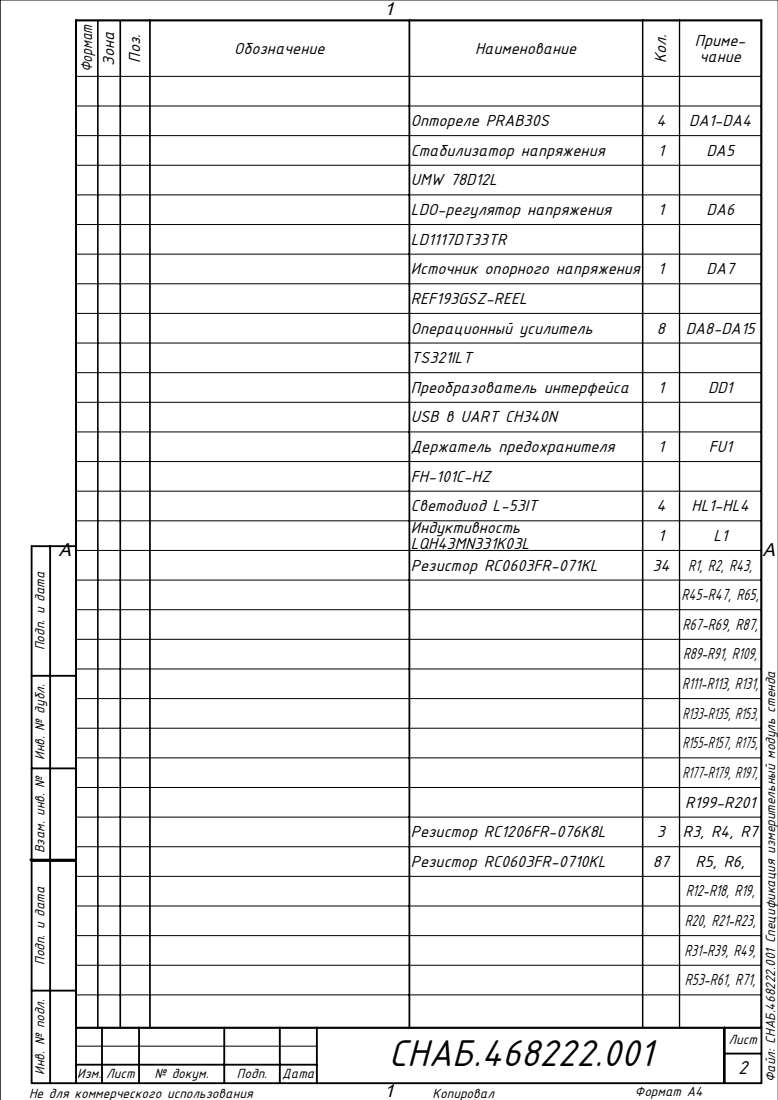
[picture p37: page 2]
Оптореле PRAB30S; Стабилизатор напряжения; UMW 78D12L; LDO-регулятор напряжения; Источник опорного напряжения 1; Операционный усилитель; Преобразователь интерфейса; USB в UART CH340N; Держатель предохранителя; Светодиод L-53IT; Резистор RC0603FR-071KL; Резистор RC1206FR-076K8L; Резистор RC0603FR-0710KL; Инв. № подл.; № докум.; Подп.; Дата; Формат А4

Подп. и дата Взам. инв. № Инв. № дубл. Подп. и дата

Файл: СНАБ.468222.001 Спецификация измерительный модуль стенда

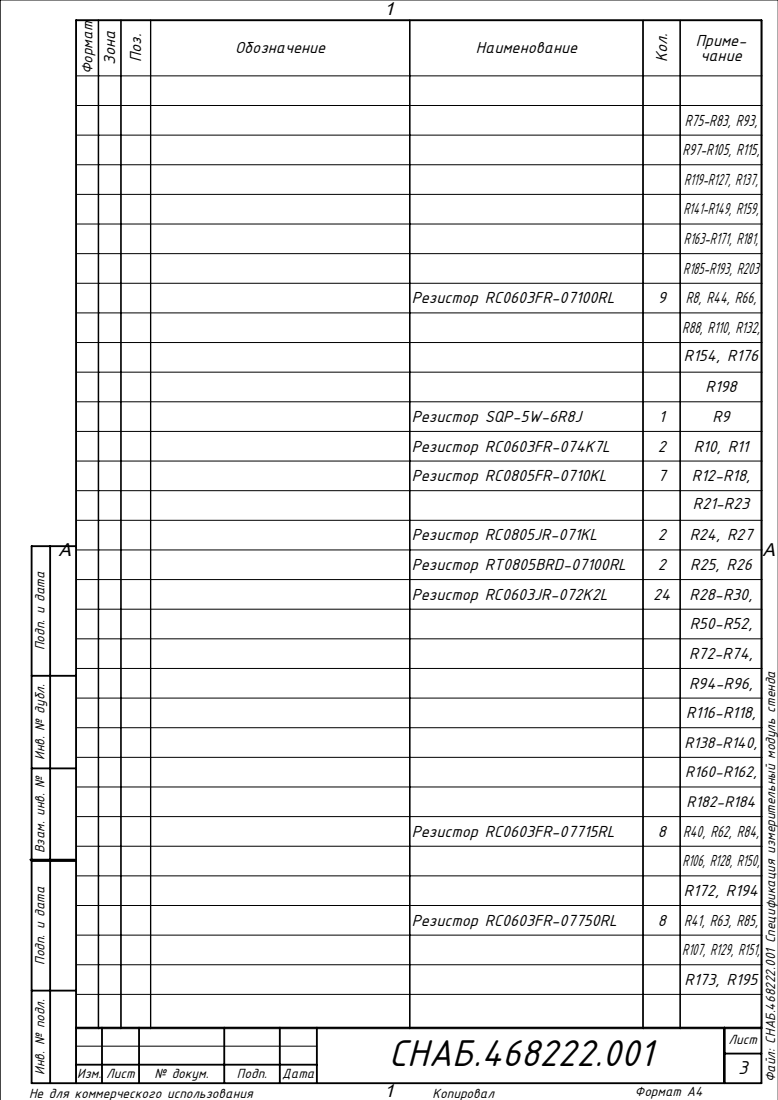
[picture p38: page 3]

Подп. и дата Взам. инв. № Инв. № дубл. Подп. и дата

Файл: СНАБ.468222.001 Спецификация измерительный модуль стенда

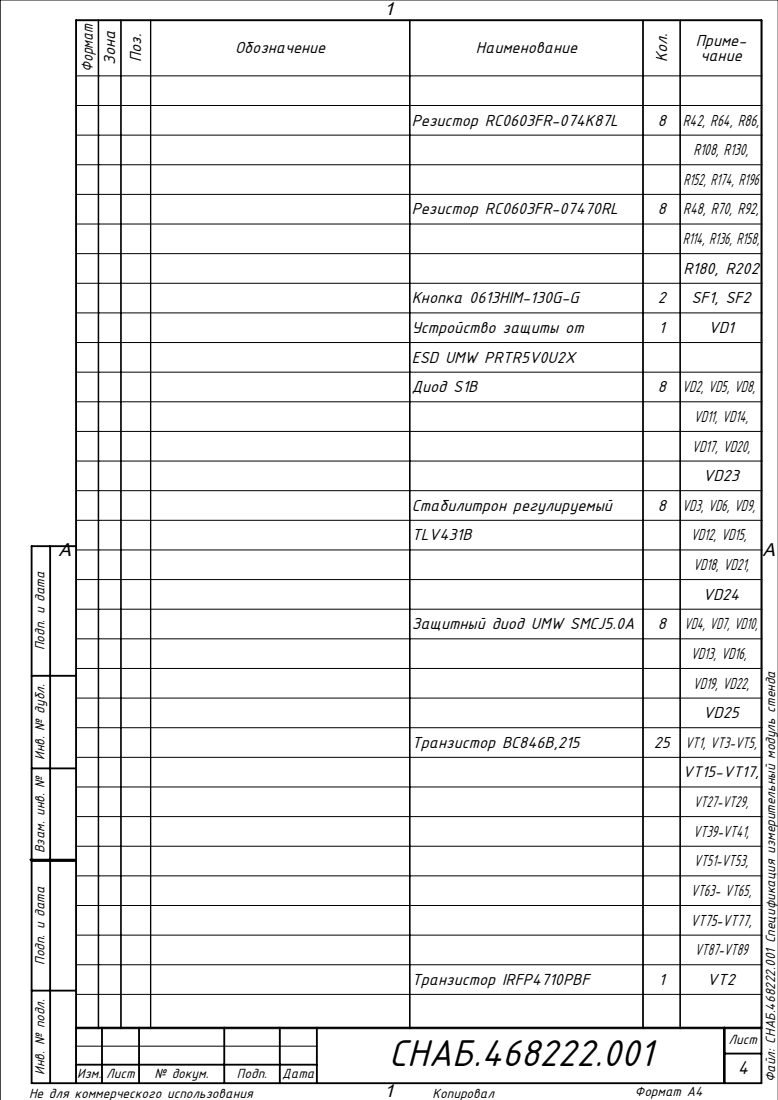
[picture p39: page 4]
Резистор RC0603FR-074K87L; Резистор RC0603FR-07470RL; Кнопка 0613HIM-130G-G; Устройство защиты от; ESD UMW PRTR5V0U2X; Диод S1B; Стабилитрон регулируемый; TLV431B; Защитный диод UMW SMCJ5.0A; Транзистор BC846B,215; Транзистор IRFP4710PBF; Инв. № подл.; № докум.; Подп.; Дата

Подп. и дата Взам. инв. № Инв. № дубл. Подп. и дата

Файл: СНАБ.468222.001 Спецификация измерительный модуль стенда

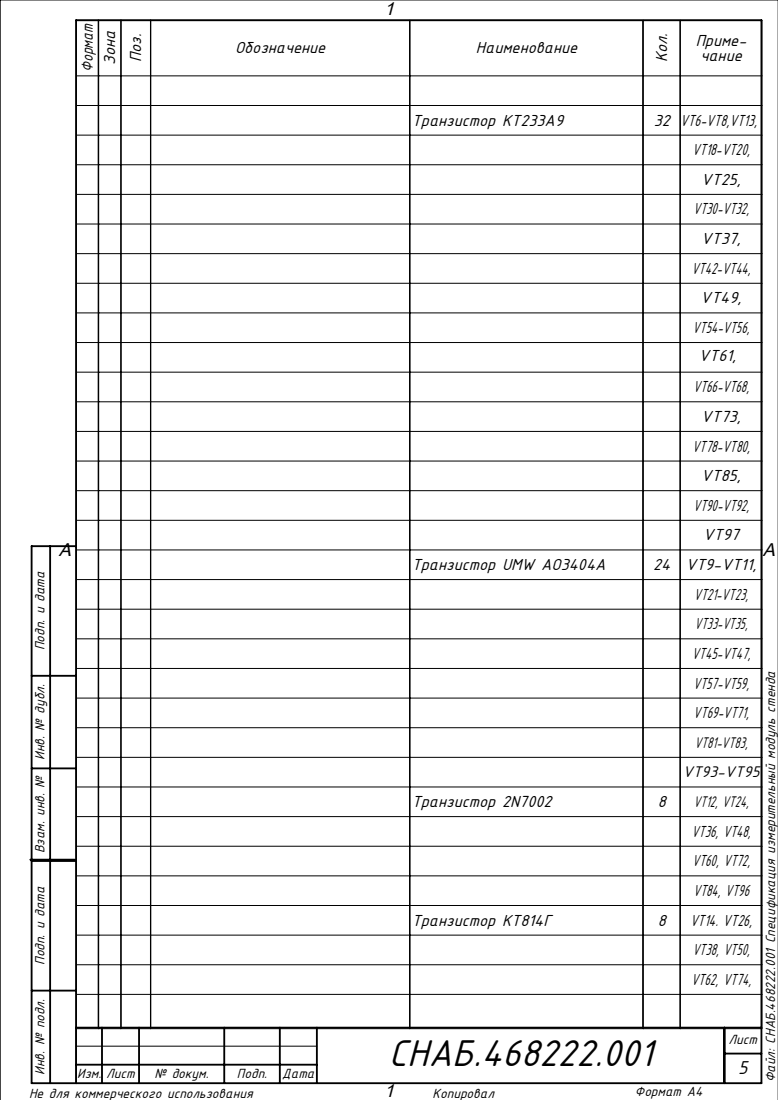
[picture p40: page 5]
Транзистор КТ233А9; Транзистор UMW AO3404A; Транзистор 2N7002; Транзистор KT814Г; Инв. № подл.; № докум.; Подп.; Дата

Подп. и дата Взам. инв. № Инв. № дубл. Подп. и дата

Файл: СНАБ.468222.001 Спецификация измерительный модуль стенда

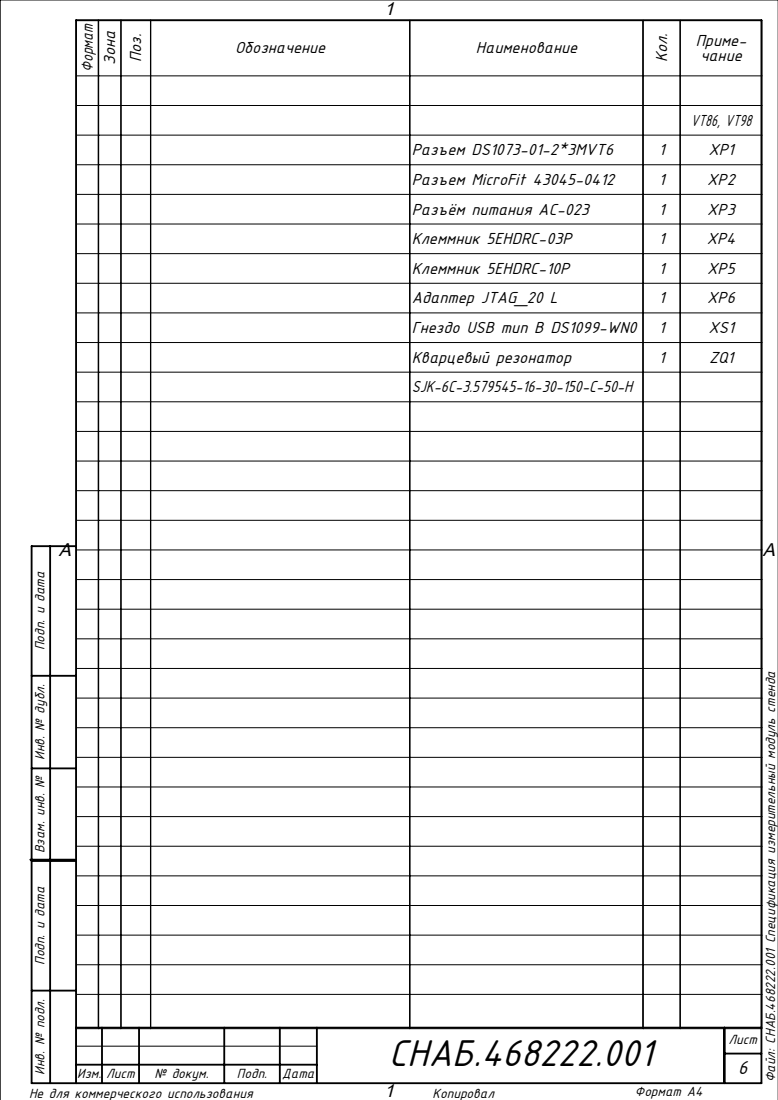
[picture p41: page 6]
Разъем DS1073-01-2*3MVT6; Разъем MicroFit 43045-0412; Разъём питания AC-023; Клеммник 5EHDRC-03P; Клеммник 5EHDRC-10P; Адаптер JTAG_20 L; Гнездо USB тип B DS1099-WN0; Кварцевый резонатор; Инв. № подл.; № докум.; Подп.; Дата

Подп. и дата Взам. инв. № Инв. № дубл. Подп. и дата

Файл: СНАБ.468222.001 Спецификация измерительный модуль стенда
