kuropatoochka/bms_stand/bms_docs/СНАБ.468222.001 Э4 Схема электрическая соединений.pdf

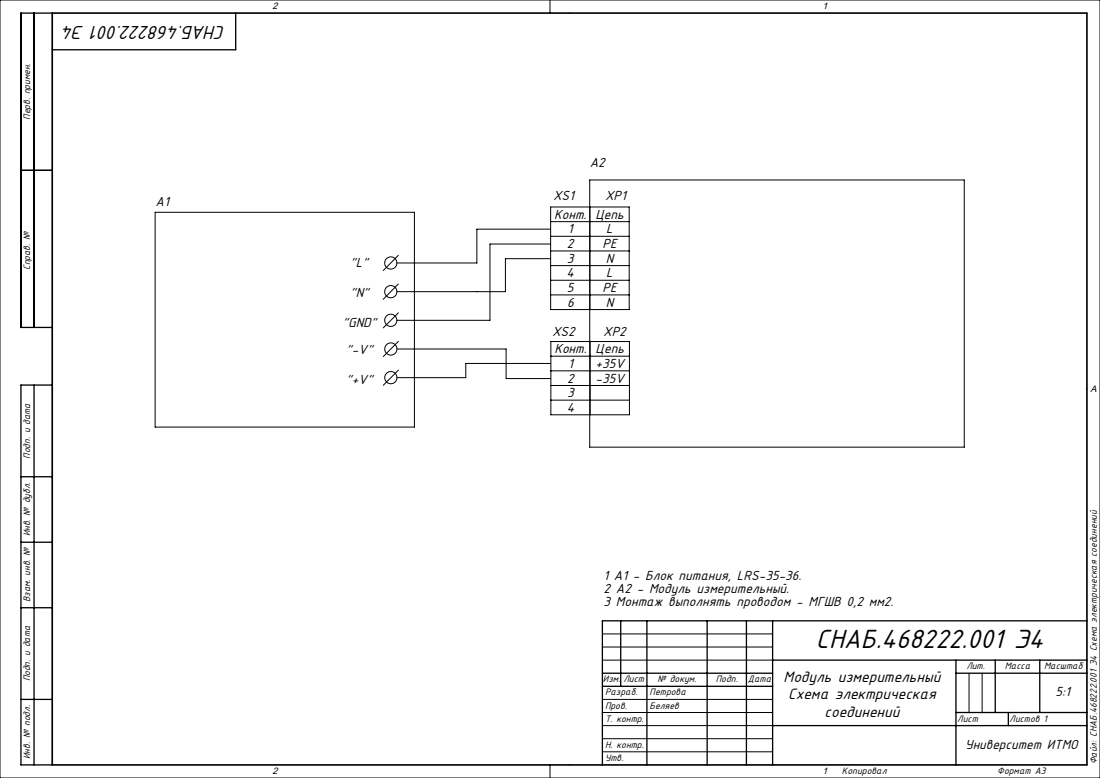
[picture p42: page 1]
Конт. Цепь 1; Копировал; Формат А3

Справ. № Перв. примен. Подп. и дата Инв. № дубл. Взам. инв. № Подп. и дата Инв. № подл.

Файл: СНАБ.468222.001 Э4 Схема электрическая соединений

1 А1 - Блок питания, LRS-35-36.
2 А2 - Модуль измерительный.
3 Монтаж выполнять проводом - МГШВ 0,2 мм2.

СНАБ.468222.001 Э4

Модуль измерительный Схема электрическая соединений | Лит. | Масса | Масштаб

Изм. | Лист | № докум. | Подп. | Дата | | | | | 5:1
Разраб. | | Петрова
Пров. | | Беляев
Т. контр. | | | | | Лист | Листов 1

Университет ИТМО

Н. контр.
Утв.
