kuropatoochka/bms_stand/bms_docs/СНАБ.468222.002 СБ Блок измерительный.pdf

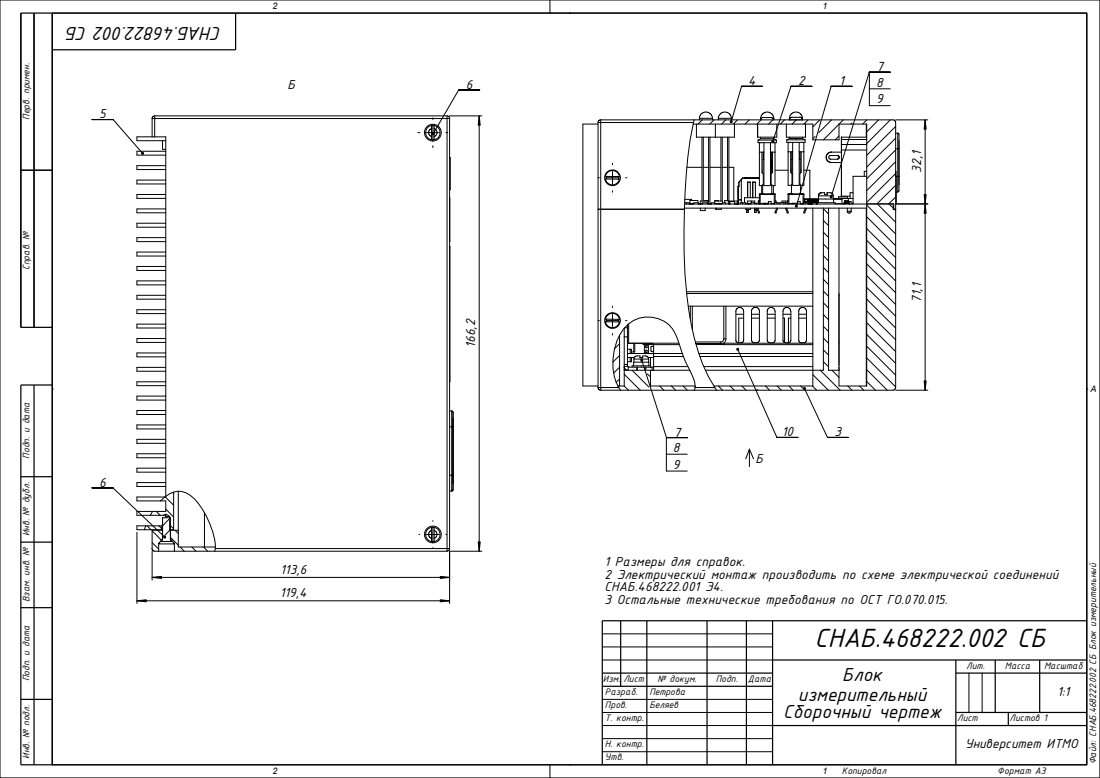
[picture p43: page 1]
Университет ИТМО; Файл: СНАБ.468222.002 СБ Блок измерительный Изм.; Лист ²; Копировал; Формат А3; Т. контр. Справ. №

Листов 1 Перв. примен. Подп. и дата Инв. № дубл. Взам. инв. № Подп. и дата Инв. № подл.

1 Размеры для справок.
2 Электрический монтаж производить по схеме электрической соединений
СНАБ.468222.001 Э4.
3 Остальные технические требования по ОСТ ГО.070.015.

СНАБ.468222.002 СБ
Блок измерительный Сборочный чертеж | Лит. | Масса | Масштаб

Лист | № докум. | Подп. | Дата | | | | | 1:1
Разраб. | | Петрова
Пров. | | Беляев

Н. контр.
Утв.
