kuropatoochka/bms_stand/bms_docs/СНАБ.468222.002 Спецификация блок измерительный.pdf

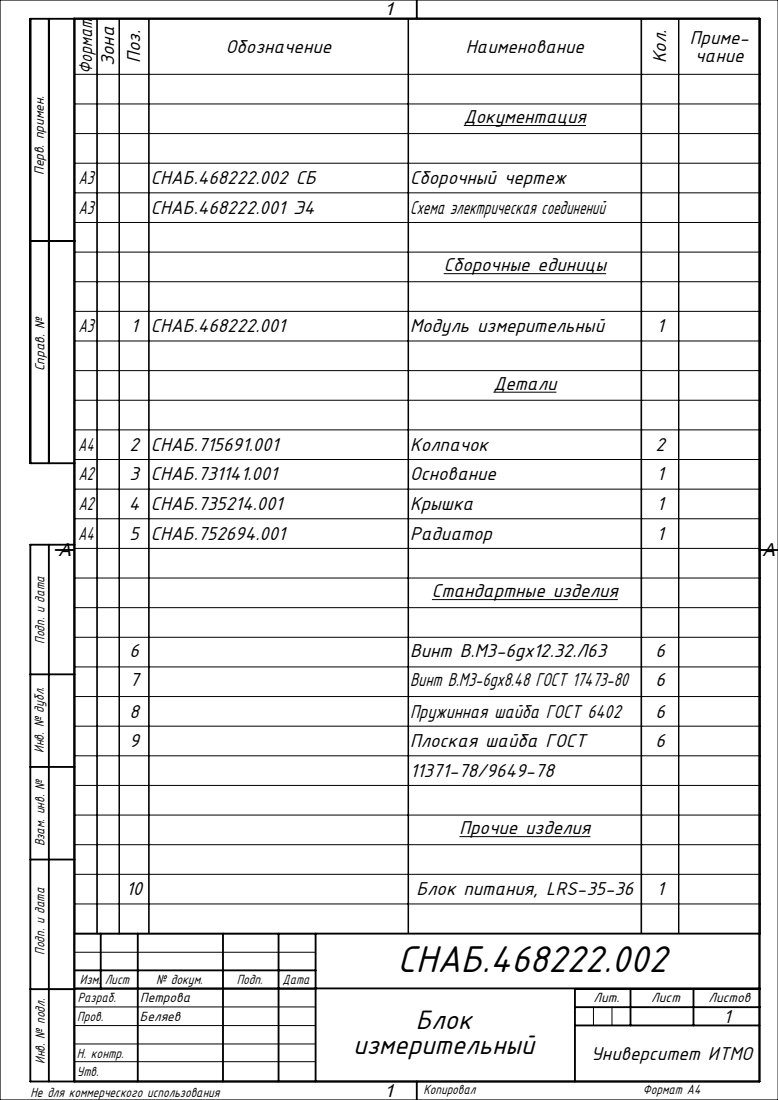
[picture p44: page 1]
СНАБ.468222.002 СБ; Сборочный чертеж; СНАБ.468222.001 Э4; Схема электрическая соединений; Сборочные единицы; 1 СНАБ.468222.001; Модуль измерительный; 2 СНАБ.715691.001; Колпачок; 3 СНАБ.731141.001; Основание; 4 СНАБ.735214.001; Крышка; 5 СНАБ.752694.001; Радиатор; Стандартные изделия; Винт В.М3-6gх12.32.Л63; Винт B.М3-6gх8.48 ГОСТ 17473-80; Пружинная шайба ГОСТ 6402; Плоская шайба ГОСТ; Прочие изделия; Блок питания, LRS-35-36; Университет ИТМО; Копировал; Формат А4

Справ. № Инв. № подл. Подп. и дата Взам. инв. № Инв. № дубл. Перв. примен. Подп. и дата

СНАБ.468222.002

Изм. | Лист | № докум. | Подп. | Дата
Разраб. | Петрова | | Блок измерительный | Лит. | Лист | Листов
Пров. | Беляев | | | | | | | 1

Н. контр.
Утв.

Не для коммерческого использования

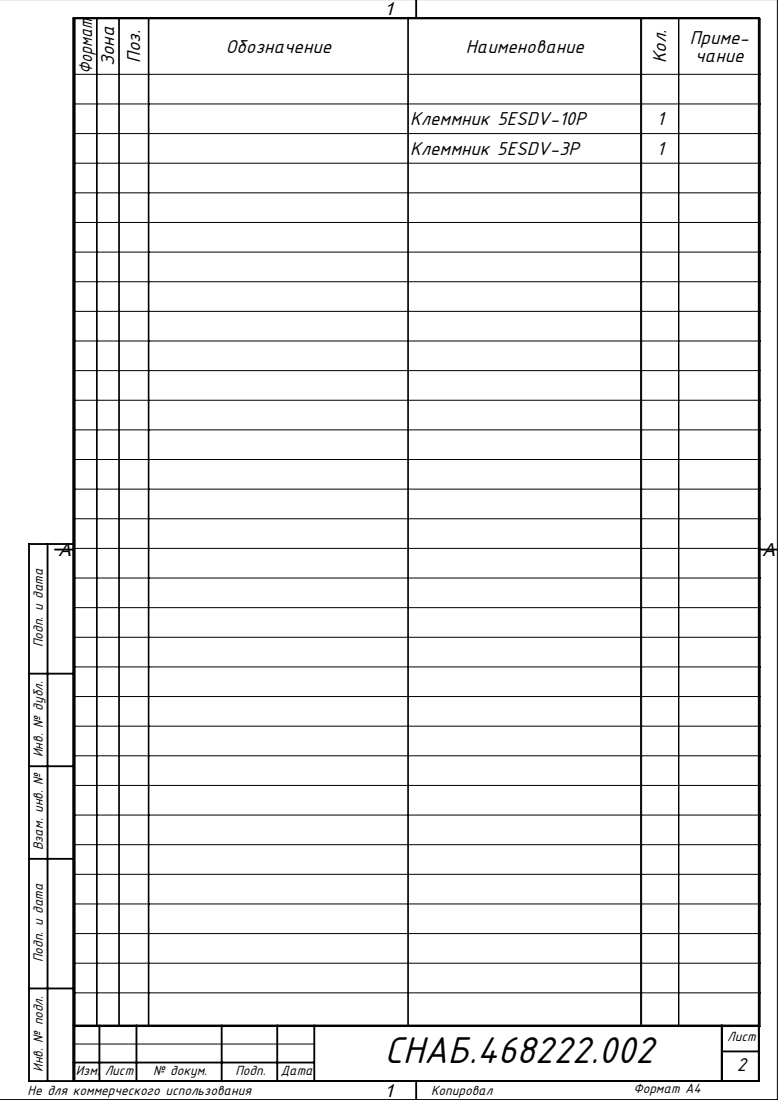
[picture p45: page 2]
Клеммник 5ESDV-10P; Клеммник 5ESDV-3P; Формат А4; № докум.; Подп.; Дата

Подп. и дата Инв. № дубл. Взам. инв. № Подп. и дата Инв. № подл.

Изм.
Не для коммерческого использования
