kuropatoochka/bms_stand/bms_docs/СНАБ.715691.001 Колпачок.pdf

Лист | № докум. | Подп. | Дата Справ. № Перв. примен. Подп. и дата Инв. № дубл. Взам. инв. № Подп. и дата Инв. № подл.

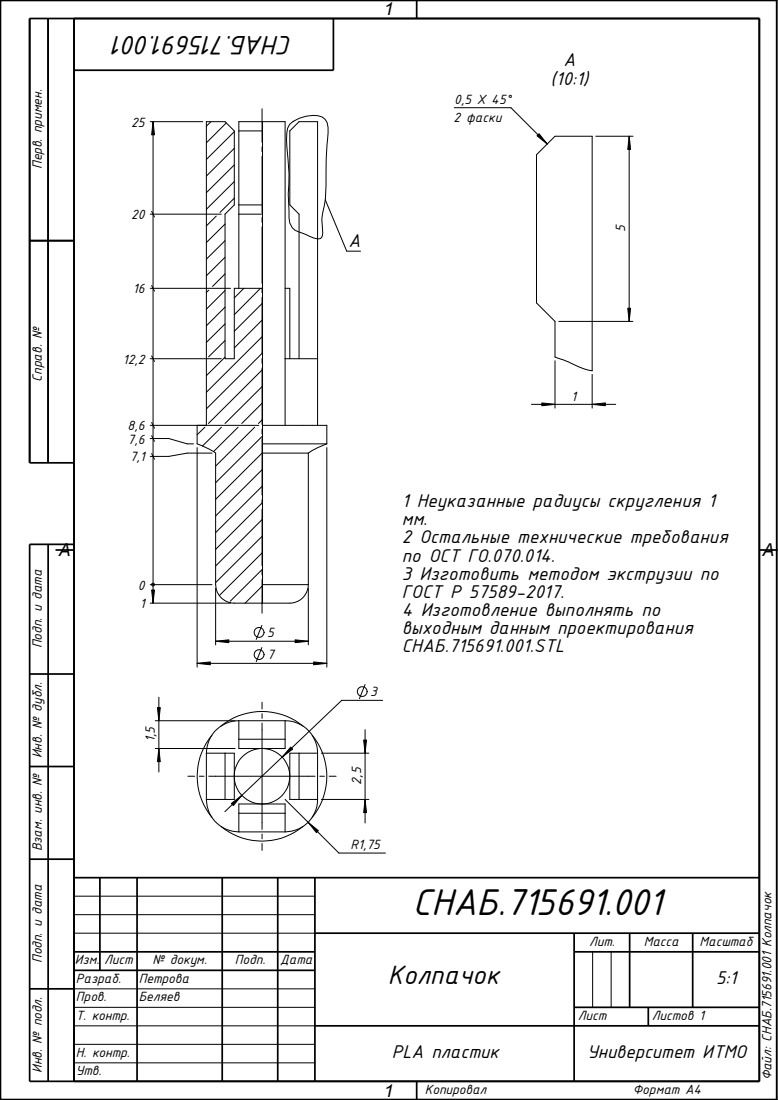
[picture p46: page 1]
Изм.; Файл: СНАБ.7¹569¹.00¹ Колпачок; Копировал; Формат А4; 2 фаски

1 Неуказанные радиусы скругления 1
2 Остальные технические требования
по ОСТ ГО.070.014.
3 Изготовить методом экструзии по
ГОСТ Р 57589-2017.
4 Изготовление выполнять по
выходным данным проектирования
СНАБ.715691.001.STL

СНАБ.715691.001

Колпачок | Лит. | Масса | Масштаб
Петрова | | | | | 5:1

Разраб.
Пров. | Беляев
Т. контр. | | | | Лист | Листов 1

PLA пластик | Университет ИТМО

Н. контр.
Утв.
