kuropatoochka/bms_stand/bms_docs/СНАБ.731141.001 Чертеж корпус основание.pdf

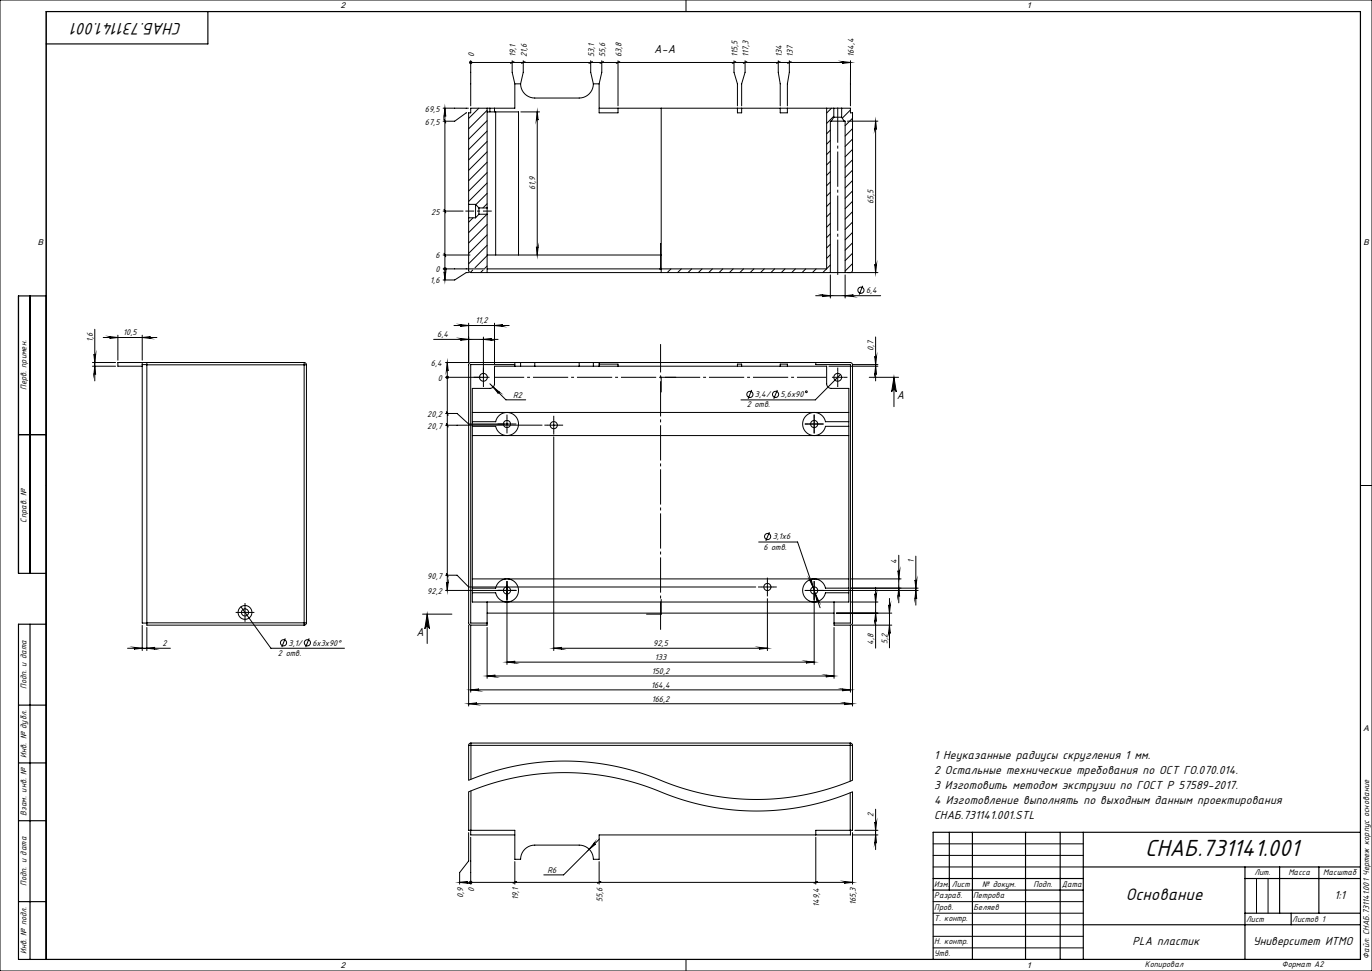
[picture p47: page 1]
2 отв.; 6 отв.; Копировал; Формат А2

Справ. № Перв. примен. Подп. и дата Инв. № дубл. Взам. инв. № Подп. и дата Инв. № подл.

1 Неуказанные радиусы скругления 1 мм.
2 Остальные технические требования по ОСТ ГО.070.014.
3 Изготовить методом экструзии по ГОСТ Р 57589-2017.
4 Изготовление выполнять по выходным данным проектирования
СНАБ.731141.001.STL

Файл: СНАБ.731141.001 Чертеж корпус основание

СНАБ.731141.001

Основание | Лит. | Масса | Масштаб

Изм. | Лист | № докум. | Подп. | Дата | | | | | 1:1
Разраб. | | Петрова
Пров. | | Беляев
Т. контр. | | | | | Лист | Листов 1

Н. контр.
Утв.

PLA пластик | Университет ИТМО
