kuropatoochka/bms_stand/bms_docs/СНАБ.735214.001 Чертеж корпус крышка.pdf

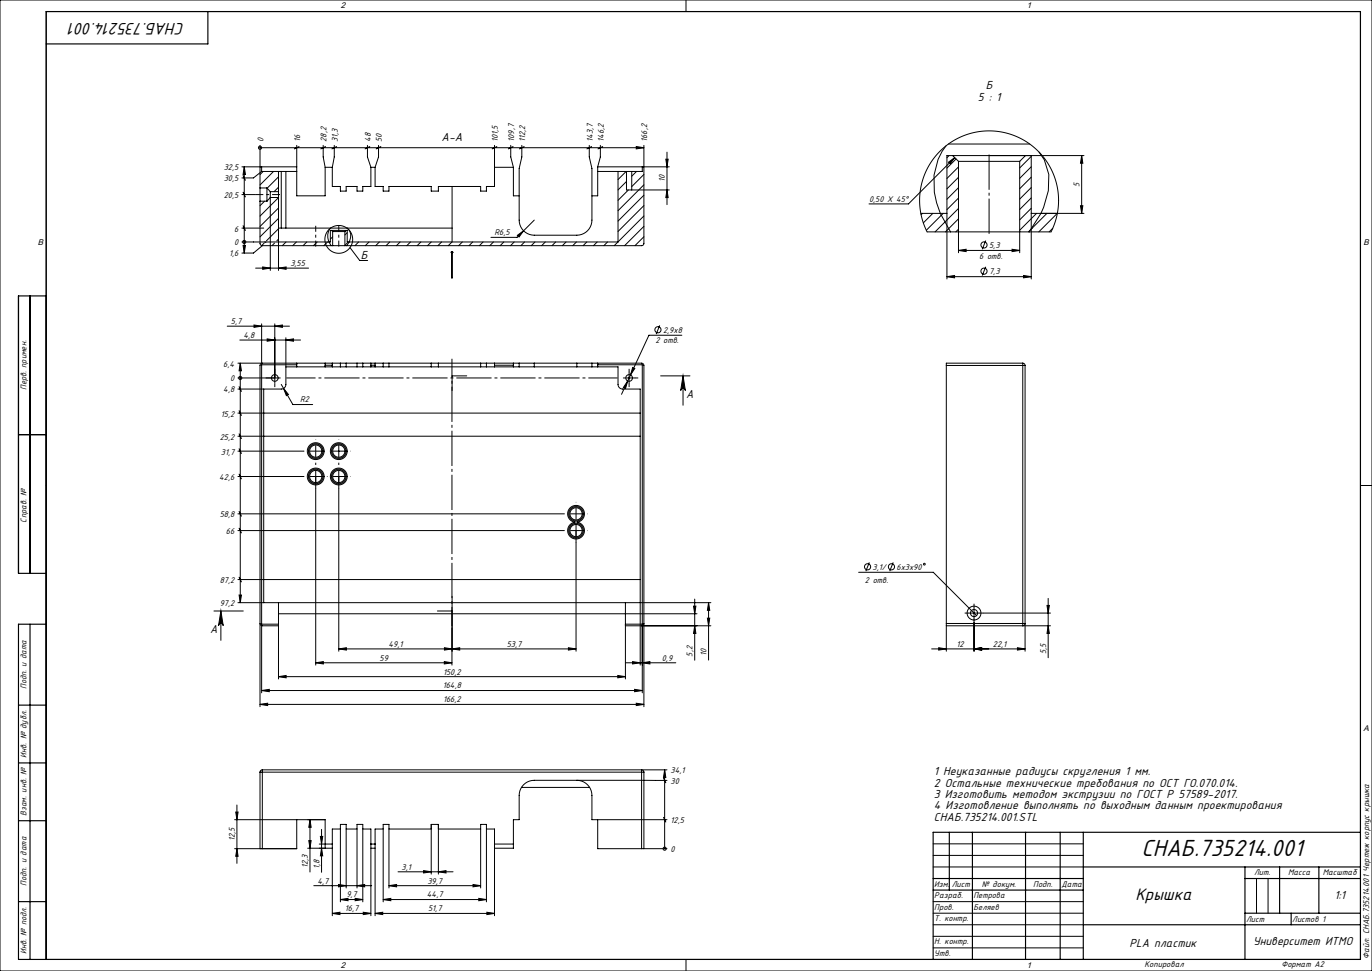
[picture p48: page 1]
6 отв.; 2 отв.; 1 Неуказанные радиусы скругления 1 мм.; Копировал; Формат А2

Справ. № Перв. примен. Подп. и дата Инв. № дубл. Взам. инв. № Подп. и дата Инв. № подл.

2 Остальные технические требования по ОСТ ГО.070.014.
3 Изготовить методом экструзии по ГОСТ Р 57589-2017.
4 Изготовление выполнять по выходным данным проектирования
СНАБ.735214.001.STL

Файл: СНАБ.735214.001 Чертеж корпус крышка

СНАБ.735214.001

Крышка | Лит. | Масса | Масштаб

Изм. | Лист | № докум. | Подп. | Дата | | | | | 1:1
Разраб. | | Петрова
Пров. | | Беляев
Т. контр. | | | | | Лист | Листов 1

Н. контр.
Утв.

PLA пластик | Университет ИТМО
