kuropatoochka/bms_stand/bms_docs/СНАБ.752694.001 Радиатор.pdf

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

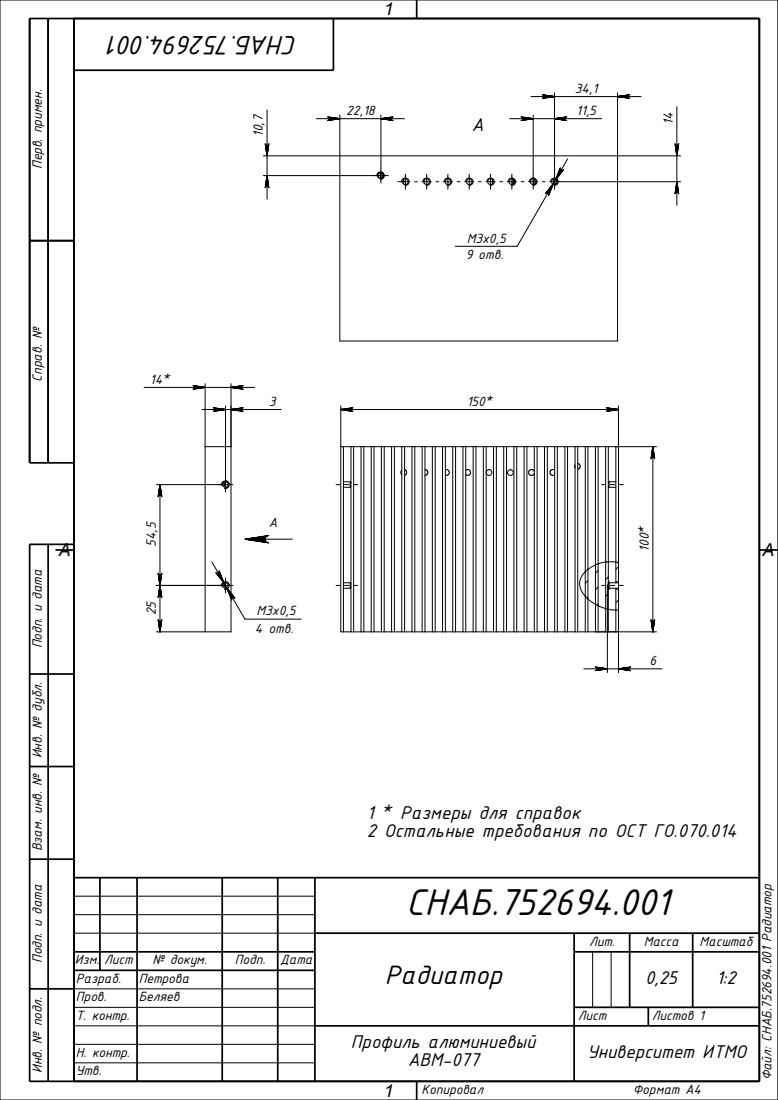
[picture p49: page 1]
СНАБ.752694.001; Файл: СНАБ.752694.00¹ Радиатор Изм.; Копировал; Формат А4; 4 отв.; 9 отв.

1 * Размеры для справок
2 Остальные требования по ОСТ ГО.070.014

Радиатор | Лит. | Масса | Масштаб
Петрова | | | | 0,25 | 1:2

Разраб.
Пров. | Беляев
Т. контр. | | | | Лист | Листов 1

Профиль алюминиевый АВМ-077 | Университет ИТМО

Н. контр.
Утв.
