kuropatoochka/bms_stand/bms_docs/СНАБ.758725.001 Чертеж платы.PDF

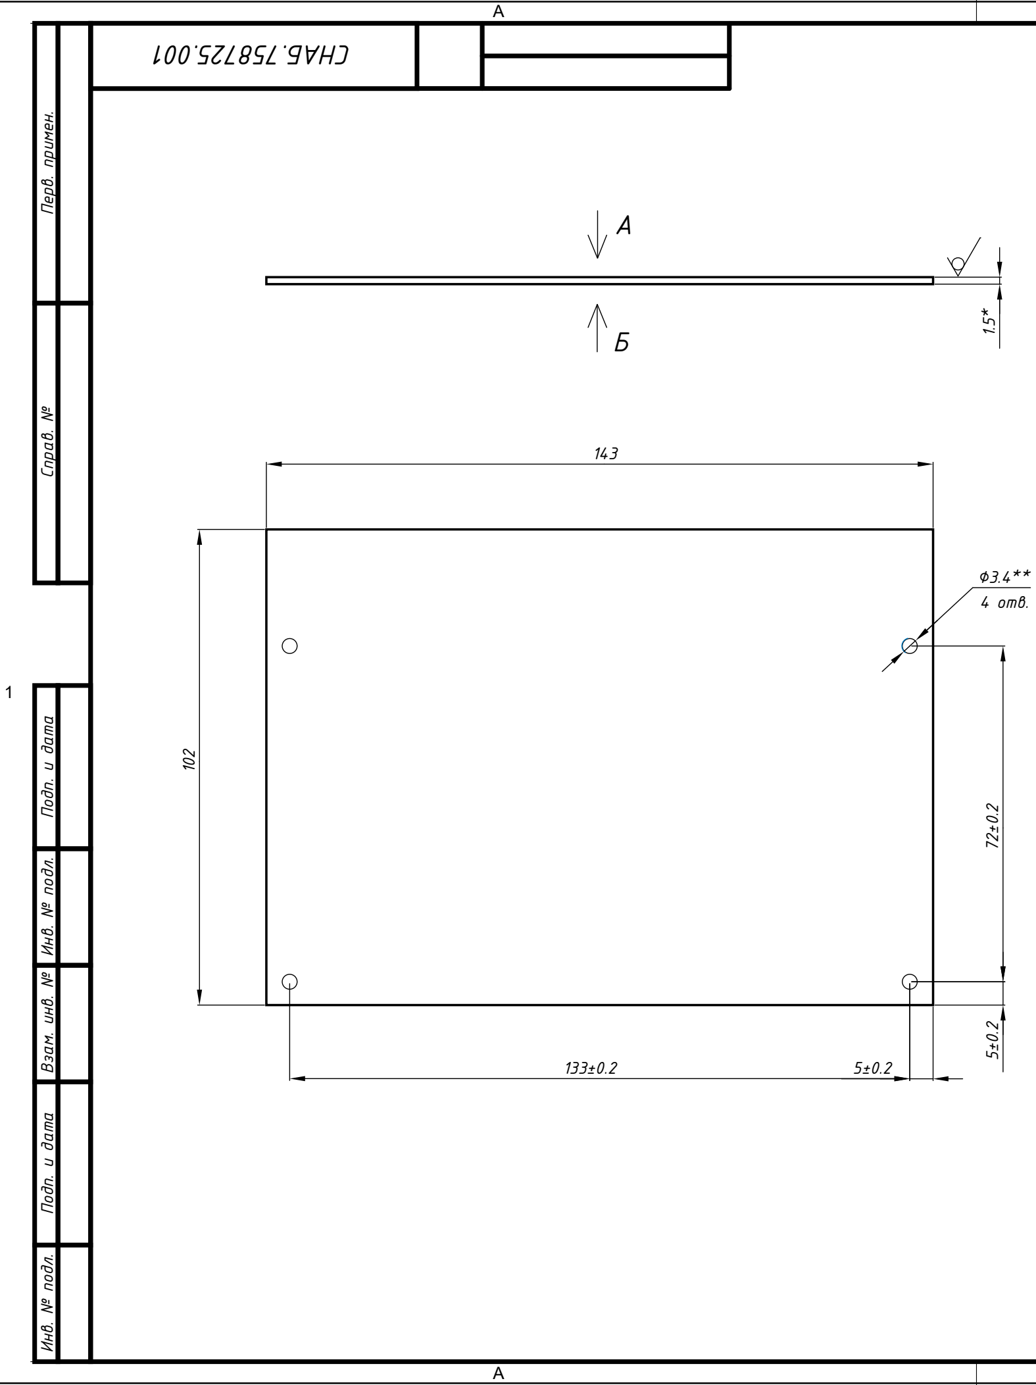
[picture p50: figure]
4 отв.

Перв. примен. Справ. № Подп. и дата Инв. № подл. Взам. инв. № Подп. и дата Инв. № подл.

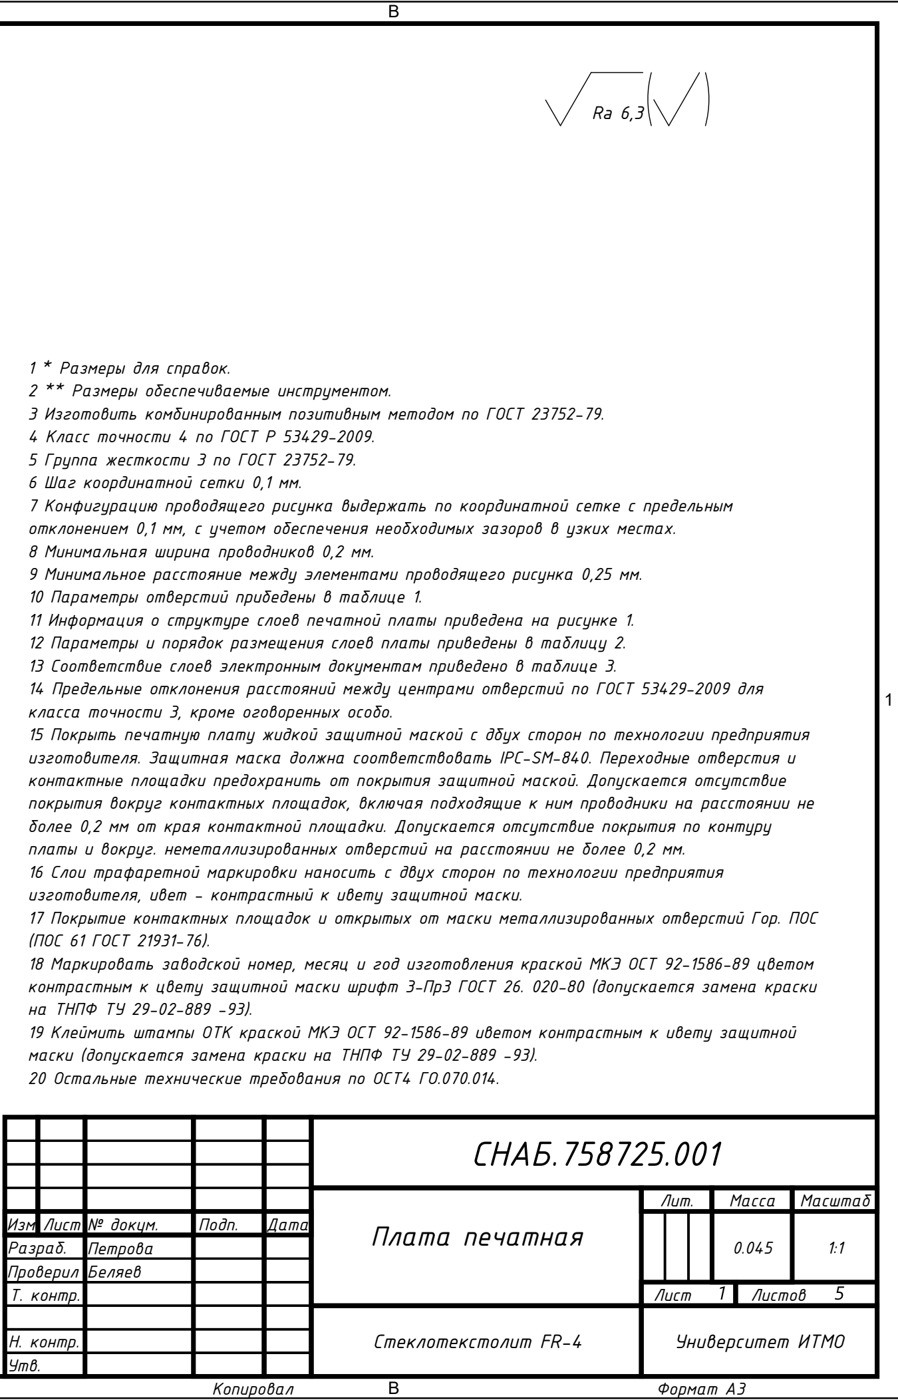
[picture p51: figure]
Изм. Лист № докум. Разраб.; Подп.; Дата; Проверил Т. контр.; Н. контр. Утв.; Лит.; Масса Масштаб; Лист; Листов; Плата печатная; СНАБ.758725.001; Петрова; Беляев; Копировал; Формат А3; Стеклотекстолит FR-4; Университет ИТМО; 1 * Размеры для справок. 2 ** Размеры обеспечиваемые инструментом.; 5 Группа жесткости 3 по ГОСТ 23752-79. 6 Шаг координатной сетки 0,1 мм.; (ПОС 61 ГОСТ 21931-76).; на ТНПФ ТУ 29-02-889 -93).

3 Изготовить комбинированным позитивным методом по ГОСТ 23752-79.
4 Класс точности 4 по ГОСТ Р 53429-2009.

7 Конфигурацию проводящего рисунка выдержать по координатной сетке с предельным отклонением 0,1 мм, с учетом обеспечения необходимых зазоров в узких местах.
8 Минимальная ширина проводников 0,2 мм.
9 Минимальное расстояние между элементами проводящего рисунка 0,25 мм.
10 Параметры отверстий прибедены в таблице 1.
11 Информация о структуре слоев печатной платы приведена на рисунке 1.
12 Параметры и порядок размещения слоев платы приведены в таблицу 2.
13 Соответствие слоев электронным документам приведено в таблице 3.
14 Предельные отклонения расстояний между центрами отверстий по ГОСТ 53429-2009 для класса точности 3, кроме оговоренных особо.
15 Покрыть печатную плату жидкой защитной маской с дбух сторон по технологии предприятия изготовителя. Защитная маска должна соответствовать IPC-SM-840. Переходные отверстия и контактные площадки предохранить от покрытия защитной маской. Допускается отсутствие покрытия вокруг контактных площадок, включая подходящие к ним проводники на расстоянии не более 0,2 мм от края контактной площадки. Допускается отсутствие покрытия по контуру платы и вокруг. неметаллизированных отверстий на расстоянии не более 0,2 мм.
16 Слои трафаретной маркировки наносить с двух сторон по технологии предприятия изготовителя, ивет - контрастный к ивету защитной маски.
17 Покрытие контактных площадок и открытых от маски металлизированных отверстий Гор. ПОС

18 Маркировать заводской номер, месяц и год изготовления краской МКЭ ОСТ 92-1586-89 цветом контрастным к цвету защитной маски шрифт 3-Пр3 ГОСТ 26. 020-80 (допускается замена краски

19 Клеймить штампы ОТК краской МКЭ ОСТ 92-1586-89 иветом контрастным к ивету защитной маски (допускается замена краски на ТНПФ ТУ 29-02-889 -93).
20 Остальные технические требования по ОСТ4 ГО.070.014.

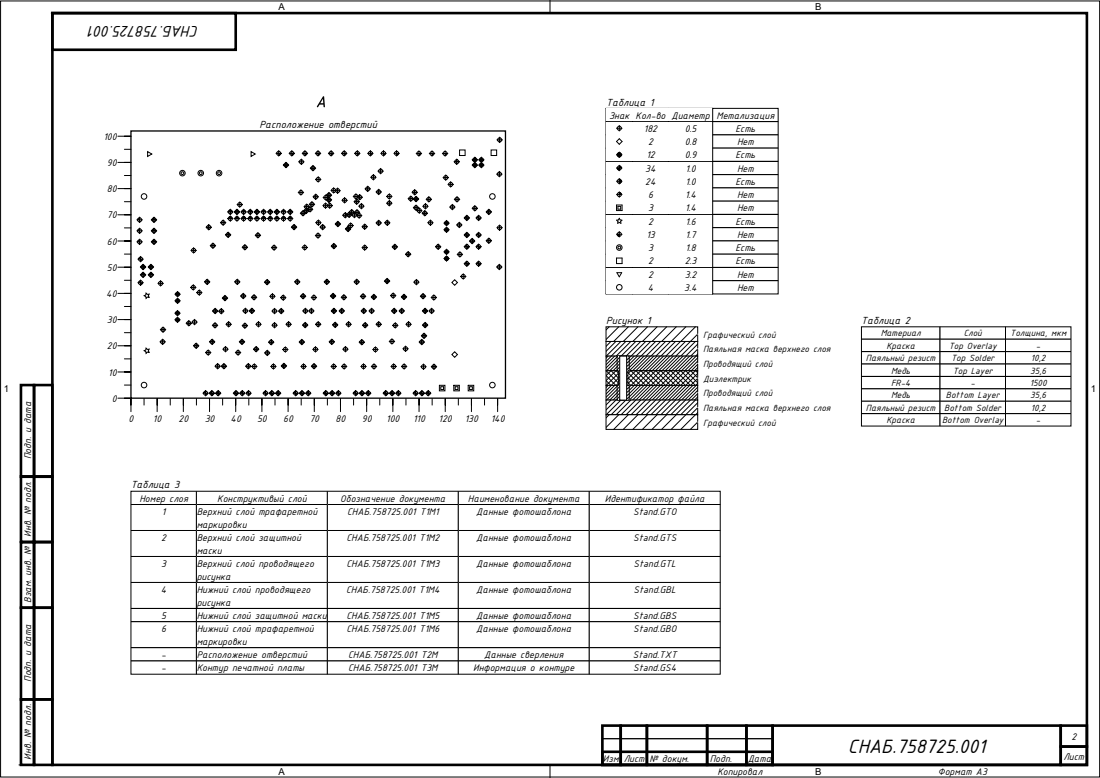
[picture p52: page 2]
СНАБ.758725.001; Изм. Лист № докум.; Подп.; Дата; Лист; Расположение отверстий; Знак; Кол-во; Диаметр 0.5 0.8 0.9 1.0 1.0 1.4 1.4 1.6 1.7 1.8 2.3 3.2 3.4; Таблица 1; Метализация Есть Нет Есть Нет Есть Нет Нет Есть Нет Есть Есть Нет Нет; Номер слоя 1; маркировки; маски; рисунка; Обозначение документа СНАБ.758725.001 Т1М1; СНАБ.758725.001 Т1М2; СНАБ.758725.001 Т1М3; СНАБ.758725.001 Т1М4; СНАБ.758725.001 Т1М5 СНАБ.758725.001 Т1М6; СНАБ.758725.001 Т2М СНАБ.758725.001 Т3М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

Графический слой
Паяльная маска верхнего слоя
Проводящий слой
Диэлектрик

Подп. и дата Инв. № подл. Взам. инв. № Подп. и дата Инв. № подл.

Конструктивый слой
Верхний слой трафаретной

Верхний слой защитной

Верхний слой проводящего

Нижний слой проводящего

Нижний слой защитной маски
Нижний слой трафаретной

Расположение отверстий
Контур печатной платы

А

Б

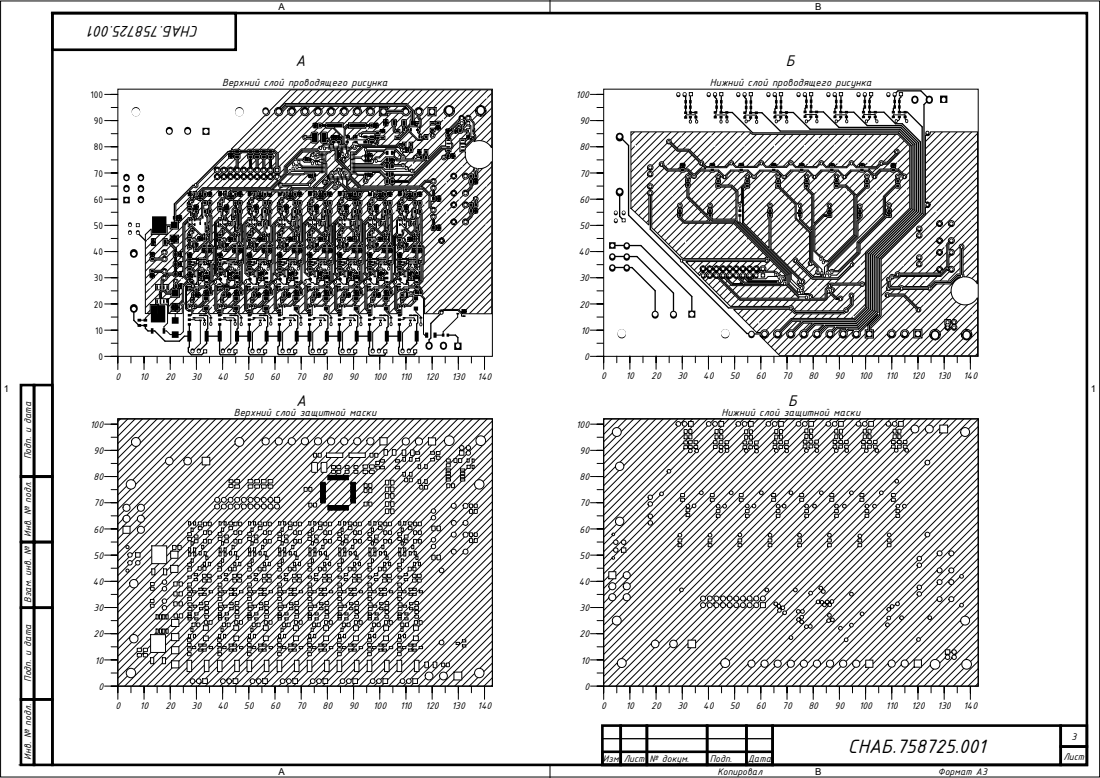
[picture p53: page 3]
Верхний слой проводящего рисунка; Нижний слой проводящего рисунка; Верхний слой защитной маски; Нижний слой защитной маски

Подп. и дата Инв. № подл. Взам. инв. № Подп. и дата Инв. № подл.

А
(2:1)

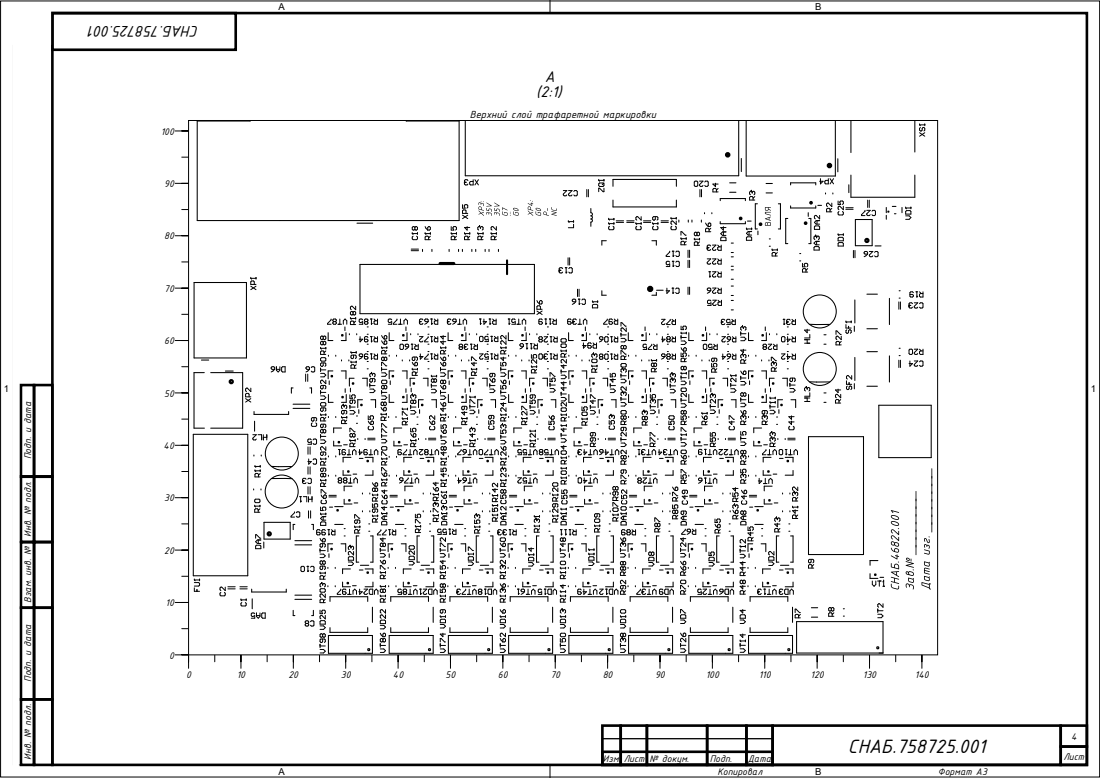
[picture p54: page 4]

Верхний слой трафаретной маркировки

Подп. и дата Инв. № подл. Взам. инв. № Подп. и дата Инв. № подл.

Б
(2:1)

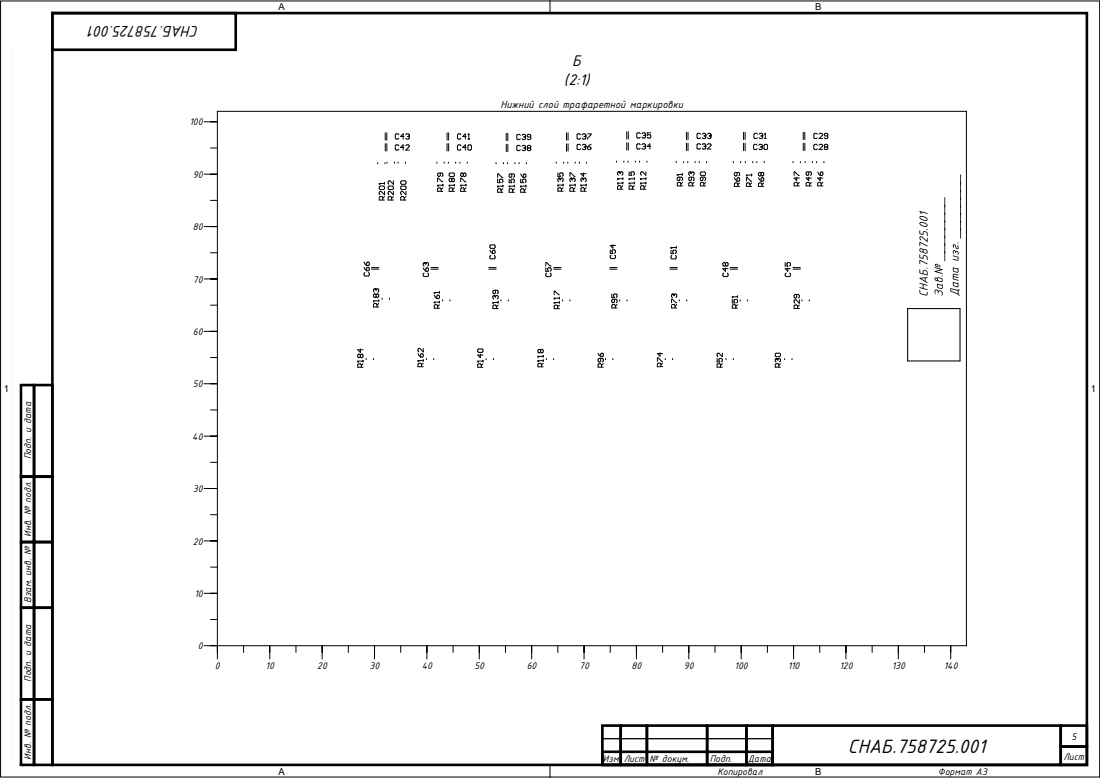
[picture p55: page 5]

Нижний слой трафаретной маркировки

Подп. и дата Инв. № подл. Взам. инв. № Подп. и дата Инв. № подл.
