kuropatoochka/bms_stand/(list of files, drawings)

Other design files:
bms_altium/BI1.SchDoc
bms_altium/BI2.SchDoc
bms_altium/BI3.SchDoc
bms_altium/BI4.SchDoc
bms_altium/BI5.SchDoc
bms_altium/BI6.SchDoc
bms_altium/BI7.SchDoc
bms_altium/BI8.SchDoc
bms_altium/BMS_Test_Stand.PrjPcb
bms_altium/Conn.SchDoc
bms_altium/Interface.SchDoc
bms_altium/MCU.SchDoc
bms_altium/Mode.SchDoc
bms_altium/Passive.SchLib
bms_altium/PassiveSMD.PcbLib
bms_altium/PcbLib.PcbLib
bms_altium/Power.SchDoc
bms_altium/Schlib.SchLib
