kuropatoochka/bms_stand/(commit log)

2025-08-11 add app for bms
2025-08-11 add docs for bms
    [A06-17.0.SLDPRT, Bot LRS-35,50.sldprt, Cap LRS-35,50.sldprt, LRS-35,50 Mean Well.SLDASM, PCB LRS-35,50.sldprt, Terminal Block LRS-35,50.sldprt, body.SLDPRT, radiator_АВМ-077-100.SLDPRT]
2025-08-11 add bms altium
    [BI1.SchDoc, BI2.SchDoc, BI3.SchDoc, BI4.SchDoc, BI5.SchDoc, BI6.SchDoc, BI7.SchDoc, BI8.SchDoc]
